sadaoikebe/ts52k/README.md

# TS52K — 無線版

親指シフト（NICOLA配列）を前提に設計した、52キーの自作キーボードです。このブランチは、MDBT50Q-1MV2 と ZMK で動かす無線版です。ケースとプレートは RP2040 版と共通です。

解説記事: [親指シフトキーボードを作った話](https://qiita.com/sadaoikebe/items/e3715383058286457a23)

## 特徴

- **親指シフト専用設計** — かな入力だけでなく、英数レイヤーも親指シフトで打てる配列
- **52キー + ロータリーエンコーダ** — 50%サイズに親指キーを確保したレイアウト
- **ZMK** — 有線のときは USB HID、ケーブルを抜くと BLE
- **MDBT50Q-1MV2** — Raytac の nRF52840 モジュール。チップアンテナ付き。技適あり
- **USB-C が一つ** — 有線キーボード、充電、あとからの UF2
- **保護付きの LiPo** — 過放電保護はセル側。基板側コネクタはJST PH横挿しSMT、電池製品は後で選ぶ
- **JLCPCB で発注できる基板** — モジュールは在庫 0 なので、事前発注してから PCBA
- **FDM 3Dプリンタで出力できるケース** — 特殊な設備なしで製作可能

---

## このブランチ

回路図は無線版へ更新しました。既存の配置を引き継いだ親シートと、MDBT50Q・電源容量・LF水晶の子シートの2枚です。[回路図PDF](pcb/schematic-review/ts52k-wireless.pdf)と[配置元・確認記録](notes/wireless-schematic-layout.md)を参照してください。PCBは2026-11-10にU5を西端へ移し、GPIO割当てと西側の配置・配線を更新しました。[配置画像・記録](pcb/placement-review/README.md)を参照してください。取り込み判断・実機検証・無線版の製造データ作成は未了です。

現行の決定は[無線版の決定事項](notes/wireless-decisions.md)に集約しています。BOMは20品種・82点で（2026-11-11に電池の逆接続保護Q1を追加）、回路図から参照番号付きで照合済みです。ERCはエラー・警告とも0件。電池・ケース、SWD機材の購入判断は後日です。

使用しているKiCad MCPとローカル開発環境は[KiCad開発環境の記録](pcb/DEVELOPMENT.md)を参照してください。

## リポジトリ構成

```
pcb/     KiCad 10 プロジェクト。回路図・PCBは無線版、U5西端移設後
         子シート pcb/mdbt50q.kicad_sch
         schematic-review/ — PDF、画像、ERC、参照番号付きBOMと検査結果
         placement-review/ — PCB配置・配線画像と各時点の照合結果
         PLACEMENT.md — RP2040 版の基板レイアウトガイド
case/    FreeCAD ソース、3Dプリント用 3MF、プレート加工用 DXF
```

`pcb/` は無線版で使うシンボルとフットプリントを同梱しています。回路図とPCBの旧部品・旧ライブラリ参照は除去済みです。

| ライブラリ | 内容 |
| :--- | :--- |
| `MX_Only.pretty` | Cherry MX キースイッチのフットプリント（1U〜3U、7種） |
| `ts52k.kicad_sym` / `.pretty` | 無線版の選定済み20品種とMXシンボル。採用ランド15種を同梱 |
| `tag-connect.kicad_sym` | Tag-Connect TC2030のSWDシンボル。既定ランドは`ts52k.pretty`に同梱 |

選定済み部品の登録、回路図への反映とPCBへの取り込みは完了しています。[ライブラリの出典・変更・削除内容](pcb/LIBRARIES.md)と[部品ごとのシンボル／ランド対応表](pcb/wireless-library.csv)を参照してください。全配線を接続した後の設計レビュー・実機検証は残っています。

---

## 回路の構成

```
USB-C (J1) ─┬─ VBUS ─┬─→ BQ24072 IN（1 µF）
            │        └─ 2.2 Ω ─→ モジュール VBUS（パッド 32、4.7 µF）
            └─ D−/D+ ──→ モジュール パッド 34 / 35
                         ESD は H5VU10U。データ線に直列抵抗は置かない

BQ24072 OUT（4.7 µF）──→ モジュール VDDH（パッド 30）
BQ24072 BAT（4.7 µF）──→ JST PH 2極（1=BAT+、2=GND）──→ 保護付きセル

モジュール VDD（パッド 28）──→ J2 の 1 番。電圧は REGOUT0 = 3.3 V
モジュール ── 16本 ──→ キーマトリクス（6列×10行）
          ── 2本   ──→ エンコーダの回転（A=P1.11、B=P1.13）
          ── SWD ──→ J2 の 2 番 SWDIO（パッド 51）、4 番 SWCLK（パッド 53）
SW1 ──→ P0.18（nRESET）を GND へ。電源を切らずに 500 ms 以内の 2 回押しで UF2
```

モジュールは MDBT50Q-1MV2 です。P1MV2 との差はアンテナだけで、技適は両方にあります。外形は 10.5 × 15.5 × 2.05 mm、供給は 1.7〜5.5 V です。アンテナは削ったり、足したりしません。32 MHz と無線側のインダクタはモジュールの中にあります。GPIO は 48 本が 61 パッドに出ています。

### USB

J1 は HRO TYPE-C-31-M-12 のままです。CC1 / CC2 は 5.1 kΩ で GND、シールドは GND、D− / D+ / VBUS の ESD は H5VU10U です。D+ / D− の直列抵抗は、nRF の USB PHY に入っているので置きません。

PC に挿すと、ZMK は既定で USB HID に出します。ケーブルを抜くと最後の BLE プロファイルに戻ります。切り替えは `&out` で、選択は残ります。充電器のように HID を受け取らない相手では `OUT_BLE` にします。キーマップだけの変更は ZMK Studio が USB でも BLE でもできます。

VBUS（パッド 32）は、モジュールの USB 用 3.3 V レギュレータへの 5 V 入力です。充電 IC の出力はここへ入れません。

モジュールVBUS枝には、Nordic推奨・Raytac参考回路の2.2 Ωを入れます。C22939（0603・Basic）を1個、4.7 µFは抵抗の後、VBUSのESDは手前です。BQ24072 INは抵抗の手前から分岐します。[選定根拠と接続](notes/wireless-power-input.md)を参照してください。

### 電源

セルの電圧を VDDH（パッド 30）へ入れ、モジュール内のレギュレータでコアを作ります。ZMK の nice!nano v2 は `zmk,battery-nrf-vddh` で、このピンを読みます。外の 3.3 V で VDD と VDDH を短絡する結線にはしません。この基板には灯が無く、他の基板へ 3.3 V を出すピンもありません。

GPIO の High は REGOUT0 です。nice!nano のブートローダに合わせて 3.3 V にします。UICR の生の数値は、ブートローダのソースからは写していません。未設定のままでは VDD が 1.8 V になります。

検証済みのZMK main最小構成に合わせ、REG0（高電圧側）・REG1（無線側）のDC/DCを両方オンにします。REG1のインダクタは内蔵、REG0用にはDCCH（31）–VDD（28）へ10 µHのLQM18DN100M70L / C713281を外付けします。P0.13のVCCスイッチは置かず、この端子はrow3に使います。VDDHに10 µF、VDDには4.7 µF＋1 µF＋100 nF×3を置きます。[現行BOMと根拠](notes/wireless-bom-candidates.md)を参照してください。

LFクロックは外付け32.768 kHz水晶、XTAL/50 ppm設定です。FC-12M / X1A0000610008（CL=9 pF）をXL1（17）–XL2（18）へ接続し、各端子からGNDへ12 pFを1個ずつ置きます。

### 充電

充電 IC は BQ24072 です。パッケージは VQFN-16（RGT、3.00 mm × 3.00 mm）、リール品の記号は BQ24072RGTR です。T 付きの BQ24072T は使いません。TS の見方が違い、10 kΩ 固定では充電しません。

nice!nano v2の公開回路図はBQ24075表記です。量産でBQ24072を使ったという発言は[調査記録](notes/wireless-bom-candidates.md)に出典と限界を残しています。今回の72の選定は、公開図と型番が同一という理由ではなく、VDDHへ供給するOUTの電圧条件に基づきます。SLUS810Nでは72のOUTはVBAT + 225 mV（VBATが3.2 V以上のとき+150 / +225 / +270 mV。3.2 V未満で入力があるときは3.3 / 3.4 / 3.5 V）です。4.2 Vのセルなら上側は約4.47 Vです。75のOUTは5.4 / 5.5 / 5.6 Vで、最大はモジュールの供給範囲1.7〜5.5 Vの上に出ます。

ピンは SLUS810N のピン図です。

| ピン | つなぎ |
| :--- | :--- |
| IN（13） | USB 5 V。1 µF。過電圧保護は typ 6.6 V（6.4〜6.8 V）。バイパスの範囲は 1〜10 µF |
| BAT（2、3） | 保護付きセルのプラス。充電電圧は 4.2 V。4.7 µF |
| OUT（10、11） | モジュール VDDH（パッド 30）。4.7 µF。範囲は 4.7〜47 µF。入力が無いときは BAT とつながる |
| EN1（6）、EN2（5） | 両方 GND。USB100 で入力上限は 100 mA（90 / 95 / 100 mA） |
| ISET（16） | 8.2 kΩ / C25981をGNDへ。Basic優先で選定。KISET = 890 AΩで約108.5 mAの設定だが、実際の充電電流はUSB100の入力制限とシステム負荷にも制限される |
| ILIM（12） | 1.5 kΩ を GND へ。データシートの試験条件。USB100 の電流を決めるのは EN の側。開放にはしない |
| TS（1） | 10 kΩ を GND へ。パックの NTC は引かない |
| TD（15） | GND。充電終止を有効にする。開放にはしない |
| CE（4） | GND。High で充電が止まり、OUT は生きたまま |
| TMR（14） | 開放。タイマは既定値 |
| CHG（9）、PGOOD（7） | 灯が無いので未接続 |
| VSS（8）とサーマルパッド | 両方 GND。パッドだけを GND にしない |

セルの容量はまだ決まっていないので、500 mA（EN1 = High、EN2 = Low）にはしません。nice!nano の公称も 100 mA です。BQ24072 に過放電保護は無く、短絡保護はあります。基板に保護 IC は足しません。セルを切り離す SYSOFF は 75 と 79 のピンで、72 にはありません。ロードスイッチは足しません。

コネクタはJST S2B-PH-SM4-TB(LF)(SN) / C295747で、基板側は1=BAT+、2=GNDに統一します。コネクタの1番とBQ24072のBATの間には、逆接続保護のPチャネルMOSFET（Q1、AO3401A / C15127）が直列に入っています。逆向きの電池をつないでもQ1がオフのままで、充電ICとモジュールに負電圧がかかりません。極性の確認が不要になるわけではありません（[手順書](notes/brick-avoidance.md)）。電池の容量・外形・製品は後で選び、ケーブルの実際の極性を基板に合わせます。PHシリーズ共通の極性規約を意味しません。

### キーの配線

52個のキーは、1個ずつマイコンのピンには繋ぎません。6列×10行のマトリクスです。列を1本ずつ順に駆動し、10本の行の電圧を見て、どのキーが押されているかを判断します。キーごとにダイオードが1本あり、向きはカソードが行側です。

エンコーダの押し込みスイッチも、このマトリクスの6列目に入っています。キー52と押し込み1つで、接点は53です。エンコーダの回転（A相とB相）はマトリクスの外で、専用のピンが2本です。

列と行でマイコンのピンは16本、回転と合わせて18本です。2026-11-10のU5西端移設に合わせ、上段バスの入力6本を北側パッド4・6・8・10・12・14、下段の行6本を南側パッド37・41・43・44・46・48へ割り当てました。列6本は制限なしのパッド16・20・22・24・26・49を使い、ZMKで高駆動を明示します。ダイオードは反転しません。[現在のGPIO表](notes/wireless-pin-assignment.md)は回路図・PCBへ反映済みで、ファームウェア側への反映は[ZMK同期チェックリスト](notes/zmk-pin-sync-checklist.md)に従って行います。

### 書き込み

通常のRaytacモジュールはAdafruit UF2ブートローダーなしを想定し、初回はJ2のSWDから書き込みます。検証対象はAdafruit 0.11.0のnice_nano用SoftDevice結合HEXです。秋月の書き込み済みモジュールも調達対案ですが、搭載版と電源初期化条件の照合が必要です。SWDランドはどちらでも必須、機材と購入先の決定は後日とします。[調査記録](notes/swd-equipment.md)を参照してください。

J2 は Tag-Connect TC2030 のランドだけです。部品は実装しません。初回書き込み・復旧の手順と、基板を壊さないための注意（電池の極性、3.3 V固定の書き込み器を使わない等）は[文鎮化回避の運用ルールと手順](notes/brick-avoidance.md)にまとめています。

| ピン | つなぎ |
| :--- | :--- |
| 1 | モジュール VDD（パッド 28） |
| 2 | SWDIO（パッド 51） |
| 3 | P0.18（nRESET）。SW1 と同じネット |
| 4 | SWCLK（パッド 53） |
| 5 | GND |
| 6 | SWO。未接続 |

SW1 は TS-1187A-B-A-B のまま、P0.18 を GND に落とすリセットにします。BOOTSEL 用の直列 1 kΩ は残しません。nRESET のプルアップは内蔵です。

---

## ロータリーエンコーダ

SW2 は型番未確定の EC11 互換です。押し込みは `col6` に入っています。A/B の 10 kΩ と 100 nF は外します。nRF52840 の内蔵プルアップは 11〜16 kΩ（別の回答は 13 kΩ）で、RP2040 の 50〜80 kΩ を前提にした回路は移しません。

---

## 部品リスト

回路図の実装対象BOMは**20品種・82点**です。[参照番号付きBOM](pcb/schematic-review/bom.csv)を回路図から生成し、[選定済みBOM](notes/wireless-bom-draft.csv)と一致することを確認しました。選定根拠は[先行例との対応](notes/wireless-bom-candidates.md)、実装条件は[ランド・配置の照合](notes/wireless-layout-check.md)にまとめています。実装座標はPCB移行後です。

### 残すもの、足すもの

| 部品 | 型番 / 値 | 数量 | パッケージ |
| :--- | :--- | ---: | :--- |
| モジュール | MDBT50Q-1MV2 / C5118826 | 1 | 10.5×15.5×2.05 mm |
| 充電 IC | BQ24072RGTR / C140288 | 1 | VQFN-16 3×3 mm |
| REG0 インダクタ | LQM18DN100M70L / C713281、10 µH | 1 | 0603 |
| LF 水晶 | X1A0000610008 / C96341、32.768 kHz | 1 | FC-12M、2012 |
| LF 負荷容量 | 12 pF / C1547 | 2 | 0402 |
| USB-C | HRO TYPE-C-31-M-12 / C165948 | 1 | SMD端子・スルーホール固定脚 |
| USB ESD | H5VU10U / C22395519 | 3 | DFN1006-2L |
| リセット | TS-1187A-B-A-B / C318884 | 1 | 上押し 5.1×5.1×1.5 mm |
| ダイオード | 1N4148W / C81598 | 53 | SOD-123 |
| CC 抵抗 | 5.1 kΩ / C23186 | 2 | 0603 |
| VBUS 直列抵抗 | 2.2 Ω / C22939（Basic） | 1 | 0603 |
| ISET | 8.2 kΩ / C25981 | 1 | 0603 |
| ILIM | 1.5 kΩ / C22843 | 1 | 0603 |
| TS | 10 kΩ / C25804 | 1 | 0603 |
| IN、VDD のコンデンサ | 1 µF / C15849 | 2 | 0603 |
| OUT、BAT、VBUS、VDD のコンデンサ | 4.7 µF / C19666 | 4 | 0603 |
| VDD のバイパス容量 | 100 nF / C14663 | 3 | 0603 |
| VDDH のコンデンサ | 10 µF / C15850 | 1 | 0805 |
| 電池コネクタ | S2B-PH-SM4-TB(LF)(SN) / C295747 | 1 | PH横挿しSMT、2極 |

Tag-ConnectのJ2はランドだけです。電源コンデンサの構成と選定根拠は[選定記録](notes/capacitor-selection.md)を使います。

### 手付け・機構部品

| 部品 | ソース | 数量 | 備考 |
| :--- | :--- | ---: | :--- |
| キースイッチ | AliEx / 淘宝 / 自キ専門店 | 52 | お好みの打鍵感で。Kailh Box 白軸がおすすめ |
| ロータリーエンコーダ | — | 1 | Alps EC11E 互換、押し込みスイッチ付き。型番未定 |
| 2u スタビライザー | AliEx / 淘宝 / 自キ専門店 | 3 | PCBマウント |
| 3u スタビライザー | AliEx / 淘宝 / 自キ専門店 | 1 | PCBマウント |
| キーキャップ | AliEx / 淘宝 / 自キ専門店 | 1セット | **3u と 2.75u の親指キーが必要** |
| ケース ふた | [3Dプリント](case/) | 1 | FDM で出力可能 |
| ケース 底板 | [3Dプリント](case/) | 1 | FDM で出力可能 |
| 定位板（プレート） | [レーザーカット](case/) | 1 | t=1.5 mm 真鍮 |
| セル | — | 1 | 保護付き LiPo。容量と外形はケースのとき |
| ヒートセットインサート | [AliExpress](https://www.aliexpress.com/item/1005002288716120.html) | 8 | M3 × 6 mm × 4.6 mm。長さは 6 mm でなくても可 |
| M3 円頭六角ボルト | — | 8 | 6 mm |
| クッション | — | 12 | Poron / EVA フォーム、2 mm 厚 × 2 mm × 87 mm |
| ゴム足 | — | 4〜 | — |

キースイッチの内訳: 1U ×39、1.25U ×5、1.5U ×2、1.75U ×2、2.25U ×2、2.75U ×1、3U ×1

### まだ決めていない

- **実際の部品配置** — U5を基板西端に移設し、モジュールの全層アンテナ禁止領域と、基板端に沿って拡張した `ANT_EDGE` を設定済みです。[配置記録](pcb/placement-review/README.md)を参照してください。実機の通信距離は未確認です。
- **SWD機材・モジュールの購入先** — 調査記録を残し、決定は後日。
- **電池製品** — 容量と外形は後で選びます。今回ケースの設計は行いません。
- **エンコーダ SW2** — 型番。RP2040 版から未定のままです。

---

## 回路図に反映した変更

### 維持したもの

- キー、1N4148W が 53 個、6列×10行。回路図のネット名は `col1`〜`col6`、`row1`〜`row10`。ダイオードのカソードは行側。エンコーダの押し込みは6列目。エンコーダ本体 SW2。
- J1。R5 と R6（5.1 kΩ）。シールドは GND。D89、D90、D91（H5VU10U）。
- J2 のランド。上のピン表。
- SW1 の部品。つなぎ先は P0.18。

### 除去したもの

旧RP2040子シートごと除去しました。

- U5 RP2040
- X2。12 MHz の OC2EL89CJO-113YLC-12M
- R3、R4。RUN と発振器 EN の 10 kΩ
- R7、R8。USB の直列 22 Ω
- R9〜R13。QSPI の直列 22 Ω
- C6〜C10、C12〜C18、C21。1 µF

親シートから除去しました。

- U4 W25Q128。R2（CS の 10 kΩ）
- R14（1 kΩ）。SW1 には残しません
- U3 TPS7A2433。C3（4.7 µF、0603）、C5（4.7 µF、0402）
- C2、C4。その 3.3 V の 1 µF
- R15、R16（エンコーダの 10 kΩ）、C19、C20（100 nF）

### 追加したもの

- MDBT50Q-1MV2 と GND。6列×10行の16本と、エンコーダの回転2本は[GPIO接続表](notes/wireless-pin-assignment.md)の割当てを使う
- VDD（パッド28）–GNDに4.7 µF＋1 µF＋100 nF×3。[電源コンデンサの現行選定](notes/capacitor-selection.md)を使う
- DCCH（31）–VDD（28）へ10 µH、VDDH（30）–GNDへ10 µF
- XL1（17）–XL2（18）へFC-12M、各端子からGNDへ12 pFを1個ずつ
- BQ24072 と、上のピン表の抵抗・コンデンサ
- OUTをVDDH（30）へ。USB 5 Vは別枝の2.2 Ωを介してVBUS（32）へ、4.7 µFは抵抗の後
- D− をパッド 34、D+ をパッド 35 へ
- 電池コネクタS2B-PH-SM4-TB(LF)(SN)。1=BAT+、2=GND
- アンテナの全層禁止領域と局所的な実装面禁止領域を登録ランドへ含めた。PCBでの拡張・配置は[寸法と配置条件](notes/wireless-layout-check.md)に従う

### 採用しないもの

- NFC
- 外の 3.3 V で VDD と VDDH を短絡する結線
- P0.13 のロードスイッチ
- LED、USBデータ線の直列抵抗、エンコーダのRC
- ドングル用ブートローダの P0.15 と P0.10
- 基板上の電池保護IC、電池プラス側のスイッチ、DW01AとFS8205。電池保護はパック側

---

## 配置と製造

モジュールは B.Cu、真鍮の定位板 t=1.5 mm は F 面、電波は樹脂の底板側へ抜けます。承認書 2.3 は、アンテナの位置を全層で GND 無し、できるだけ広く、端の方が中央より良い、と書いています。エンコーダの金属筐体はアンテナの近くに置きません。モジュールの高さは 2.05 mm です。

MDBT50Q-1MV2 の JLCPCB 部品番号は C5118826 です。2026-10-31 の表示は在庫 0、Standard Only、X-ray 必須でした。在庫が無くても Parts Manager で事前発注し、私有庫に入ってから PCBA に出します。生基板の最少は 5 枚です。Standard はエッジレールが要り、レール幅のヘルプは最小 5 mm です。レールは製品の外形に残しません。自宅リフローは、事前発注が通らないときの予備です。

Fanstel BC840 は使いません。同じ机の上でも、MDBT50Q より距離の余裕が小さく、縁ゼロのアンテナ条件は残ります。

---

## ファームウェア

無線版はZMKです。開発は別リポジトリ`C:\Users\marur\zmk-config`で行い、本リポジトリはハードウェアを扱います。ZMK main `4dd95d7840eb3d5a3f59bb29fbf1ab054715ef85` / Zephyr 4.1.0で、TS52Kの1×1最小定義をビルド済みです。VDDH給電、REG0/REG1 DC/DCともオン、外付けLF水晶XTAL/50 ppm、USB/BLE、P0.18リセット。P0.13の`EXT_POWER`は使いません。GPIO18本の全マトリクスと親指シフトの実装は今後のファームウェア開発で行います。

ビルド成功は実機の起動確認ではありません。初回SWD、USBブートローダー、最小ZMK、BLEの順に試作基板で確認します。[起動条件の調査記録](notes/zmk-hardware-bringup.md)を参照してください。

有線版の QMK は別リポジトリです。公開済みの `ts52k` 定義は ATmega32U4 用です。

https://github.com/sadaoikebe/qmk_firmware/tree/master/keyboards/ts52k

---

## 組み立て手順

ケース、プレート、キースイッチの手順はRP2040版と同じです。電池の入れ方は電池製品を選んだ後で書きます。SW1はBOOTSELではなくリセットです。ケースの穴は、このボタンを押すためのものです。

### 1. 部品の確認

部品リストの通り揃っているか確認します。

### 2. スタビライザーの取り付け

**ここが一番の要注意ポイントです。** ちゃんと嵌っていないと、後の工程で気づいたときに大幅な手戻りになります。基板にスタビライザーを取り付けたら、爪がしっかりロックされているか1つずつ確認してください。

### 3. ロータリーエンコーダの取り付け

### 4. プレートとキースイッチの取り付け

プレートを貫通させて、**まず四隅のキースイッチから固定**します。四隅が決まるとプレートと基板の位置が安定するので、残りが入れやすくなります。

### 5. Poron フォームの貼り付け

### 6. ケースへのヒートセットインサート挿入

半田ごてで温めながら、**まっすぐ**押し込みます。斜めに入ると取り返しがつかないので、少しずつ確認しながら進めてください。

### 7. ケースの組み立て

---

## 開発環境

- **KiCad 10.0** 以降

無線版回路図のERCはエラー0・警告0です。[検査スクリプト](pcb/check_schematic.py)で電源・信号・BOM・旧マトリクスとの一致を確認し、[結果](pcb/schematic-review/validation.json)を保存しました。ライブラリ検査は[別記録](pcb/LIBRARIES.md)です。PCBは旧版なので、無線版DRC・schematic parityの検査はこれからです。RP2040版の0件という過去結果を現在のPCB整合の結果として使いません。

**`Tools → Update PCB from Schematic` では `Link footprints using reference designators` をオフのままにしてください。** フットプリントは Unique ID で回路図と紐付いています。

基板を編集する場合は、[`pcb/PLACEMENT.md`](pcb/PLACEMENT.md) の「やってはいけないこと」を先に読んでください。`PLACEMENT.md` が説明しているのは RP2040 版の配置です。編集後はベタを再充填し、DRC と製造データを作り直します。

```sh
kicad-cli sch erc                                   -o erc.rpt ts52k.kicad_sch
kicad-cli pcb drc --schematic-parity --refill-zones -o drc.rpt ts52k.kicad_pcb
```

---

## ライセンス

[Creative Commons Attribution-NonCommercial 4.0 International (CC BY-NC 4.0)](LICENSE.md)

複製・改変・再配布が可能です。ただし以下の条件が付きます。

- **表示（Attribution）** — 作者のクレジット表示、ライセンスへのリンク、変更の有無の明示が必要です
- **非営利（NonCommercial）** — 商用目的での利用はできません
