sadaoikebe/ts52k/pcb/jlcpcb/README.md

# JLCPCB 向け出力 — 無線版

**同梱の製造出力は、2026-11-13にJ2（SWD接点）を最下段のMX5とMX9の間 (19.05, 115.0) へ再移設した基板から再生成したもの。BOM 21行・LCSC 20種類・82実装点、実装面はすべてBottom。** J2は部品を実装しないので、変わったのはガーバーだけ。BOM・CPLは2026-11-11の回転監査時（wireless `6e3c3ec`）と同じ。[移設の記録](../placement-review/README.md)Q1の既存+180°補正を維持し、今回追加する角度補正はない。

監査の[全BOM行の判定・根拠・角度一覧](../../notes/rotation-audit-2026-11-11/report.md)と[取得データ・照合手順](../../notes/rotation-audit-2026-11-11/README.md)を参照。最終再生成のDRCはシルク警告9件のみ、未接続0・回路図パリティ0、ERCはエラー・警告とも0。

## 無線版：発注画面の配置プレビューで向きを確かめる部品（2026-11-11）

JLCPCB公開ページのビューアが使う **JLCEDA/EasyEDA公式ライブラリの番号付きランド図**を全20種類取得し、KiCadのランド形状・寸法・ピン番号と比較した。基板上の全82点についても反転・配置回転を戻して確認した。判定は、補正あり1点（Q1）、補正不要（確認済み）61点、180°反転が電気的に無意味な2端子部品20点。ライブラリの回転定義について未確認の部品は残っていない。

`export.py` の `ROTATION_CORRECTIONS` は **C15127: +180°のみ**。補正はKiCadの生角度に一度だけ加える。Q1は生角度0°→CPL 180°で、今回の監査前後のCPL角度は同じ180°。他の部品は生角度を維持する。

公開ライブラリの照合を済ませても、**発注画面の配置プレビューは最終目視として必要**。ピン1・極性・全ランドの重なりを確認する。下表は基板を表面側から透かして見た向き（東=+x、南=+y、座標mm）。Bottomを直接見る表示では左右が反転する。CPLのYはKiCad基板座標の符号を反転している。

| 部品 / LCSC | 中心 (x, y) mm | 監査判定 / 最終CPL角度 | プレビューで確認する実際の位置 |
| --- | --- | --- | --- |
| U5 MDBT50Q-1MV2 / C5118826 | (4.45, 63.4) | 補正不要（確認済み） / −90° | 1番は西へ3.75、北へ4.65。アンテナが基板左端。61端子すべての位置も確認 |
| U6 BQ24072 / C140288 | (16.5, 51.2) | 補正不要（確認済み） / 90° | 1番は東へ0.75、南へ1.4625。中央17番を含む全端子がランドに重なること |
| D91 VBUS ESD / C22395519 | (25.9588, 49.9816) | 補正不要（確認済み） / −135° | 1番=Kは東へ約0.3005、北へ約0.3005（VBUS）。2番=AはGND |
| D89・D90 USB ESD / C22395519 | (21.225, 51.8) / (23.075, 51.8) | 補正不要（確認済み） / 180°・0° | 1番=KはD89が東へ0.425、D90が西へ0.425。信号側がK、GND側がA |
| Q1 AO3401A / C15127 | (24.97, 68.73) | **既存+180°補正を維持** / 180° | 1本の辺（3=D）が東、2本の辺が西。南西1=G/GND、北西2=S/BAT。補正の二重適用がないこと |
| J3 電池コネクタ / C295747 | (30.6, 65.0) | 補正不要（確認済み） / −90° | 1番=BAT+は西へ2.85、北へ1.0、シルク「+」側。差し込み口は東。信号端子・固定金具が重なること |
| J1 USB-C / C165948 | (23.820919, 43.588617) | 補正不要（確認済み） / 0° | 差し込み口が基板上辺。A1/B12は西、A12/B1は東。12か所の信号ランドと4本のシールド脚を確認 |
| SW1 リセット / C318884 | (27.5, 74.6) | 補正不要（確認済み） / 0° | 南側の左右がGND（KiCad 1=EasyEDA 1・2）、北側の左右がRESET（KiCad 2=EasyEDA 3・4）。180°は同等、90°はランドに合わない |
| D2〜D88のBOM記載53点 / C81598 | 全位置はCPL参照 | 補正不要（確認済み） / 各90°または−90° | 1=Kの帯が90°配置では南、−90°配置では北。全53点の帯とランドを確認。D2からD88の連番すべてではなく、BOMに列挙された53点を対象とする |
| C22〜C33・R5/R6/R17〜R20・L1・X3 | 全位置はCPL参照 | 回転無意味（0°と180°が電気的に等価） / 生角度を維持 | 合計20点。90°回転は許容しない。2端子の長軸とランドが重なること |

SW1の接点対応はメーカー図のA–B / C–Dの導通と、EasyEDAの1–2 / 3–4の同じ行の配置で確認済み。

**回転とは別の確認事項：** U5のEasyEDA原点はKiCad原点と約1.700 mm（フットプリントのy方向）異なる。J1にも約1.4〜1.6 mmのy方向差がある。番号とランド配列の向きは一致しており、フットプリント不適合と断定する差ではない。JLCPCBが部品中心をどう扱うかは公開SVGだけでは確定しないため、XY補正は加えず、プレビューで部品全体の平行ずれも最終確認する。

## 以下は旧RP2040版 Revision 0.2 の記録

以下の電源構成、部品数、配置、DRC件数、RP2040の製造実例は旧版の履歴であり、現在の無線版の発注値ではない。現行の部品数・回転監査・確認対象は上記を使う。[無線版の決定事項](../../notes/wireless-decisions.md)と[回路BOM](../schematic-review/bom.csv)も参照。

## 電源・USB ESD保護

- U3 は **TPS7A2433DBVR / C2866134**。SOT-23-5 の 1=+5V、2=GND、3=+5V（EN と IN を直結）、4=GND（NC端子を放熱用に接続）、5=+3V3。[TI データシート](https://www.ti.com/lit/gpn/TPS7A24)
- C3 は **CL10A475KA8NQNC / C69335、4.7 µF、25 V、0603**。入力側の C4 は1 µFのまま、位置を調整。U3出力側のC5は従来の **CL05A475MP5NRNC / C23733、4.7 µF、10 V、0402** のままです。メーカーの典型DCバイアスデータでは、C3は5 Vで約2.43 µF、C5は3.3 Vで約2.43 µFです。これは典型値であり、温度・個体差を含む保証値ではありません。[C3](https://product.samsungsem.com/mlcc/CL10A475KA8NQN.do) / [C5](https://product.samsungsem.com/mlcc/CL05A475MP5NRN.do)
- D−のD89、D+のD90、VBUSのD91に **H5VU10U / C22395519** を使用しています。各素子の1番は保護する線、2番はGNDです。[JLCPCB 部品情報](https://jlcpcb.com/partdetail/C22395519)
- 3個ともKiCad標準の `Diode_SMD:D_SOD-882D` を使用し、Bottomに実装します。現在の位置と向きは基板データと実装座標を参照してください。
- J1はKiCad標準の `Connector_USB:USB_C_Receptacle_HRO_TYPE-C-31-M-12`、C13は `Capacitor_SMD:C_0402_1005Metric`、J2は `Connector:Tag-Connect_TC2030-IDC-NL_2x03_P1.27mm_Vertical` です。J1のシールド端子 `SH` はGNDに接続しています。J2は標準のベタ銅箔とビアの禁止領域を含みます。
- C3・C4はU3入力とGNDの間、C5・C21は3.3V出力とGNDの間に接続しています。U3の2番・4番はGNDに接続しています。回路・ESD波形の実測は未実施です。
- USB付近の配線と保護素子の位置は基板データを参照してください。USB信号品質は未測定です。

## 基板と検査

- 銅箔と基板外周の設計ルールを **0.25 mm** にし、表裏の GND ゾーンを再充填して基板に保存しました。JLCPCB の通常のルーター外形では銅箔まで 0.2 mm 以上が必要です。[JLCPCB 基板製造能力](https://jlcpcb.com/capabilities/pcb-capabilities)
- BOOTSEL の SW1 は、上押し式 **XKB TS-1187A-B-A-B / C318884** に変更。JLCPCB の掲載上は Basic です。高さは基板から約 1.5 mm、実装面は Bottom。裏面側から押します。[部品情報](https://jlcpcb.com/partdetail/C318884) / [メーカー図面](https://www.helloxkb.com/uploads/qingchukaiguan/TS-1187A-X-X-X.pdf)
- SW1 は裏面の (47.6, 76.2) mm、90°に配置しています。メーカー図面の推奨ランドと A–B／C–D の接点構成に合わせています。ケースは既存版と共通です。底板を取り付けた状態での BOOTSEL の押下方法は組み立て時に確認してください。
- KiCad 10.0.5 のDRCは **エラー0、未接続0、回路図との不一致0、フットプリント差異0、警告25件**。残る警告はシルク関連で、ERCはエラー・警告とも0件です。プロジェクト設定で無効なチェックもあるため、これだけで機構干渉や実装品質を保証するものではありません。
- USB の R7/R8 は **22Ω・C25092** のままです。同じ Basic 部品を QSPI 側 R9–R13 と共通化し、部品種と PCBA の段取り費を抑える設計判断です。Raspberry Pi の[設計資料](https://datasheets.raspberrypi.com/rp2040/hardware-design-with-rp2040.pdf)で指定される 27Ω とは異なり、USB 波形の測定・シミュレーションは行っていません。

## データの再生成

KiCad 10 と Python 3 を用意し、KiCad 上の変更を保存したうえで、リポジトリ直下から実行します。

```powershell
python pcb/jlcpcb/export.py
```

`kicad-cli` が PATH にない場合、Windows の標準 KiCad 10 インストール先を探します。それ以外では `--kicad-cli` に実行ファイルのパスを渡します。

スクリプトは現在の回路図・基板から DRC / ERC、ガーバー、PTH・NPTH ドリル、BOM、実装座標を作成します。外周クリアランスが 0.2 mm 未満の場合、DRC エラー・未接続・回路図との不一致・ERC エラーがある場合、部品番号や実装座標が欠けている場合は停止します。作成時のソースと出力の SHA-256 は `assembly/manifest.json` に記録します。ガーバーZIP、BOM、実装座標、manifestはGitに保存し、基板編集後は再生成してください。その他の生成物は `.gitignore` の対象です。

次の表は現在の基板から生成した出力先です。

| JLCPCB に渡すもの | ファイル |
| :--- | :--- |
| ガーバーとドリル | `gerber/ts52k-gerbers.zip` |
| PCBA 部品表 | `assembly/ts52k-bom.csv` |
| PCBA 配置座標 | `assembly/ts52k-cpl.csv` |

正常終了したら `assembly/export-status.txt` が `EXPORT COMPLETED` になります。失敗時には以前の出力が残ることがあるため、利用しないでください。基板・回路図・設定を変更したら再生成します。

実装面は **Bottom のみ、96 点 / 部品番号16種、BOM 16行**です。C13は同じ標準フットプリントと部品番号を使うコンデンサと同じ行です。USB コネクタ J1 と BOOTSEL の SW1 は JLCPCB に実装してもらいます。キースイッチ 52 個とロータリーエンコーダ SW2 は手付け、Tag-Connect J2 は接点と穴だけで部品実装なしです。J1は固定脚にPTHがあるため、スクリプトはSMDのみに限定せず座標を出力し、J1を含むBOMと配置座標の参照番号を照合します。

## RP2040 のパッドと JLCPCB の製造実例

**結論：この基板の RP2040 のパッドと中央パッド内ビアは、JLCPCB の2層・1 ozで製造・実装できる設計と判断しています。パッド幅や中央パッド内ビアを理由にガーバー出力を止める必要はありません。**

この基板の U5（RP2040）は、端子パッドの幅が **0.20 mm** です。中央の GND パッドには、ペースト開口と重なる **穴径 0.30 mm の貫通ビアが4個**あります。

参考となる実例として、[RP2040 Advanced Breakout Board の発注手順](https://github.com/OpenStickCommunity/Hardware/blob/main/Boards/GP2040-CE%20Official%20Boards/RP2040%20Advanced%20Breakout%20Board/RP2040%20Advanced%20Breakout%20Boa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)では、JLCPCB に発注した基板について、2層・1.6 mm厚・1 oz・Tented ビアが指定されています。[公開 BOM・実装座標・ガーバー](https://github.com/OpenStickCommunity/Hardware/tree/main/Boards/GP2040-CE%20Official%20Boards/RP2040%20Advanced%20Breakout%20Board/RP2040%20Advanced%20Breakout%20Boa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)を確認すると、RP2040 は C2040、端子パッド幅は 0.20 mm、中央パッド内にはペースト開口と重なる穴径 0.305 mm のビアが9個あります。

この実例は、同様のパッド幅と中央パッド内ビアを持つ基板が JLCPCB に発注されている根拠です。中央パッド内ビアの実装については、[JLCPCB のビア・イン・パッド資料](https://jlcpcb.com/help/article/via-in-pad-pofv-guide)も参照できます。

## 発注画面で確認すること

1. 2 層、板厚 1.6 mm、銅厚 **1 oz** を選ぶ。基板外形は約 307.23 × 80.41 mm。最小配線幅 0.15 mm は JLCPCB の 2 層 1 oz の公表能力内ですが、2 oz の公表最小値 0.16 mm は満たしません。
2. BOM をアップロードし、各部品の実装在庫と見積額を確認する。
3. 現在の無線版を発注する場合は、本書冒頭の「無線版：発注画面の配置プレビューで向きを確かめる部品」の表を使う。Q1のみ+180°補正済み。公開ライブラリの全件照合後も、極性・角度・XY位置をプレビューで最終目視する。
4. U5 のパッドとビアについては、上記の製造実例を参照する。
5. 実機では SW1 の押下方法と Tag-Connect の挿入性、全キー、同時押し、USB の両向き、繰り返し起動を確認する。Revision 0.2 の動作には RP2040 対応ファームウェアが必要です。
