sadaoikebe/ts52k/pcb/placement-review/scripts-2026-11-10/README.md

# 2026-11-10 配線編集スクリプト（記録）

`lib.py` はpcbnew用の小さな編集ヘルパー。`s2`→`s2b`→`s3`→`s4`→`s5`→`s5b` の順に、
コミット `5ea75d5` の基板へ適用した編集の記録である。各スクリプトは適用前の座標を前提にしており、
現在の基板へ再実行するものではない。`lib.py` の `PCB` は作業時の絶対パスを指す。

このVMのpcbnewでは `BOARD.Remove()` の後にSWIGの型解決が壊れるため、削除は `RemoveNative()` を使っている。
