sadaoikebe/ts52k/notes/wireless-decisions.md

# 無線版の現行決定事項

2026-11-03更新。会話で合意した内容の参照先。旧調査案より本書を優先し、会話で変更が決まった場合は本書と関連するBOM・ライブラリを揃える。

## 作業範囲と現在地

ts52kはハードウェア用。ファームウェアは`C:\Users\marur\zmk-config`等の別リポジトリで扱う。NICOLAの内部実装とQMKのRP2040移植は今回の作業に含めない。ZMKの調査対象は基板の起動に必要な条件に限る。

現在は**無線版回路図の作成・検査が完了し、PCBの仮配置まで実施**。親シートとMDBT50Q子シートの2枚。旧RP2040子シートと不採用の埋め込みシンボルを削除した。回路図の既存配置と追加ブロックの先行例は[配置記録](wireless-schematic-layout.md)を参照。PCBは旧MCU・周辺部品と配線を除去し、無線部品を裏面に仮置きした。新規配線は行っていない。[仮配置記録](../pcb/placement-review/README.md)を参照。旧ライブラリは復活させない。

メーカー参考回路と実績あるキーボードの構成を基準にする。新たな仕様や最適化を先に作り、そのために高価な部品・追加回路・検討工程を増やさない。抵抗・容量は必要条件を満たす安いBasic品を優先する。

## 決定済みの構成

| 項目 | 採用内容 |
| --- | --- |
| MCU | MDBT50Q-1MV2 / C5118826。裏面実装、内蔵アンテナ・32 MHz水晶・REG1インダクタを使用 |
| 給電 | BQ24072 OUT→VDDH(30)。外部3.3 V LDOは使わない |
| REG0 / REG1 | ZMKで両DC/DC有効。REG0はDCCH(31)–VDD(28)にLQM18DN100M70L / C713281、10 µHを外付け |
| VDD外付け容量 | **4.7 µF＋1 µF＋100 nF×3を全て実装**。単体4.7 µFへ簡略化しない |
| その他の電源容量 | VDDH=10 µF、モジュールVBUS=4.7 µF、BQ IN=1 µF、OUT=4.7 µF、BAT=4.7 µF |
| LFクロック | 外付けFC-12M / X1A0000610008 / C96341、CL=9 pF。12 pF / C1547×2、ZMKはXTAL/50 ppm |
| 充電 | **USB100固定**。EN1・EN2・CE・TDはGND。TS=10 kΩ、TMR開放。USB状態連動の充電制御・追加GPIO・記述子変更は初版で実施しない |
| ISET | 8.2 kΩ / C25981。ISET単独設定は約108.5 mAだが、USB100入力制限から本体負荷を差し引くため、実際に109 mA充電へ増やす変更ではない |
| USB | 既存HRO USB-C、CC各5.1 kΩ、H5VU10U×3を継続。モジュールVBUS枝だけに2.2 Ω / C22939。BQ INは抵抗の手前で分岐。D−=34、D+=35、データ線直列抵抗なし |
| 電池コネクタ | JST S2B-PH-SM4-TB(LF)(SN) / C295747、横挿しSMT。1=BAT+、2=GND |
| 電池の逆接続保護 | 2026-11-11追加（ブランチ claude-fable-mosfet-2026-11-11、未マージ）。J3の1番とBQ24072 BATの間にPチャネルMOSFET Q1＝AO3401A / C15127（Basic、SOT-23）を直列に1個。ドレイン=J3側（ネット `/BAT_CONN`）、ソース=BAT、ゲート=GND。C24（4.7 µF）はBQ側に残す。[選定根拠](wireless-bom-candidates.md#電池の逆接続保護q12026-11-11)、[手順上の注意](brick-avoidance.md) |
| SWD / リセット | TC2030-NL接点を必ず設ける。VTref=VDD(28)、SWDIO=51、SWCLK=53、nRESET=P0.18(40)。6番NC。消去直後1.8 Vと初期化後3.3 Vへ対応する経路を確保 |
| マトリクス等 | 6列×10行、53接点、カソード行側、`col2row`を維持。2026-11-10にモジュールを基板左端へ移し、GPIO割当てを組み直した。入力12本のうち上段6本は低周波専用のパッド4〜14、列6本は制限なしGPIOで、ZMKで高駆動を指定。[現在の割当て表](wireless-pin-assignment.md)を参照 |

発注型番・JLC番号・数量は[仮BOM](wireless-bom-draft.csv)、シンボルとランドは[登録表](../pcb/wireless-library.csv)。**20品種・82点、Basic 13品種73点、Extended 7品種9点**（2026-11-11にQ1を追加）。[参照番号付きBOM](../pcb/schematic-review/bom.csv)を回路図から生成・照合済み。実装座標はPCB作成後で、現時点のCSVをJLC製造用BOMとして使わない。

ExtendedのREG0インダクタはBasic対案との電流特性比較後に了承済み。電池コネクタも廉価対案との比較後にSMTを了承済み。比較結果は[選定根拠](wireless-bom-candidates.md)に残す。

BQ24072の選定理由は当初READMEにあったOUTの電池電圧追従とBQ24075との出力電圧差を引き継ぐ。nice!nanoの公開図がBQ24075であることと、量産品に関する第三者経由のBQ24072採用情報は区別する。ビルド成功から充電ICの適合を判断しない。

## 検証済みの範囲

- ZMK main `4dd95d7840eb3d5a3f59bb29fbf1ab054715ef85` / Zephyr `10ba6d0cb38bc3d258775d27982f707599320085`で1×1最小構成をビルド済み。両DC/DC、XTAL/50 ppm、USB/BLE、P0.18、フラッシュ領域を出力設定で照合した。
- ブートローダ候補はAdafruit 0.11.0のnice_nano用SoftDevice結合HEX。初期化ソースとファイル領域を照合済み。初回実機でVDD/UICRを読戻す。[起動条件](zmk-hardware-bringup.md)を参照。
- 採用部品のライブラリはKiCadで読み込み、BOMとの一致、ピン・パッド番号、専用ランド寸法を検査済み。[検査記録](../pcb/LIBRARIES.md)を参照。
- 無線版回路図はERCエラー0・警告0。ネットリストで電源・USB・SWD・LF水晶・18 GPIO・BOMを照合し、既存マトリクス105部品の座標と接続も確認した。[検査結果](../pcb/schematic-review/validation.json)と[PDF](../pcb/schematic-review/ts52k-wireless.pdf)を参照。

REG0 LDOは以前の検証用の暫定設定。ZMKの版を変えるたびに回路を変更する要求ではなく、実装回路と基板定義の対応を維持する。UF2生成は実機起動の証明ではない。旧RP2040版のERC/DRC結果は当時の回路・ライブラリ構成に対する履歴で、現在の検査結果ではない。

## 後日扱う事項

電池製品・容量・外形とケース設計は後日。SWD機材・購入時期・モジュール購入先も後日。通常品と秋月の書き込み済み品を候補にでき、どちらでもSWDランドは必須。機材購入や秋月品の採用を現在の工程の条件にしない。

独自の0〜50℃等の温度要件や高精度品への変更は採用していない。実機の起動、LF精度、USB波形・ESD、BLE通信は試作後の確認。内部容量やUSB電流管理の未実証を、決定済み部品の再選定・初版の追加制御へ自動的につなげない。

## 会話監査12項目への是正

| 監査項目 | 是正後の状態 |
| --- | --- |
| 1. 不要ライブラリの保持 | RP2040用ライブラリ一式・旧LDO・登録を削除。旧回路図参照の例外を撤回 |
| 2. VDD単体への独自簡略化 | 5個構成をBOM・README・登録済み部品へ統一 |
| 3. 部品決定後の調査・保留の反復 | 容量の旧候補・選定停止記述を現行資料から除去し、試作確認と区別 |
| 4. Basic優先・価格比較の不足 | 全19品種を分類。抵抗・容量は全てBasic、了承済みのExtended例外と比較根拠を明記 |
| 5. 固定充電の未決扱い | USB100固定を決定として統一。追加制御案を現行の作業候補から除去 |
| 6. 電池・ケースへの範囲拡大 | 現在の作業候補から製品選定・収納設計を除外。コネクタだけを採用BOMへ記載 |
| 7. 暫定LDOの固定条件扱い | 現行の両DC/DC構成を冒頭に明示。旧v0.3は試験履歴として分離 |
| 8. 独自温度要件 | 温度範囲・精度変更を未依頼の要件として使わない |
| 9. BQ24072の選定理由の見落とし | 既存理由を復元し、メーカー条件と第三者情報を区別 |
| 10. SWD機材推奨前の調達比較不足 | 通常品／書き込み済み品を先に示し、機材は未決の調査例と明記 |
| 11. 109 mAの説明 | ISET設定値とUSB100入力制限・実充電電流を各資料で区別 |
| 12. 記録・検査状態の過大報告 | 古い進捗・未決記述を整理。旧ERC/DRCと現在のライブラリ検査を区別 |

再発防止の作業方針は[AGENTS.md](../AGENTS.md)へ記載した。既存の決定事項を参照して次の依頼を実行し、解消済みの論点で繰り返し判断を求めない。
