sadaoikebe/ts52k/pcb/mcu-layout/ground-reference.png

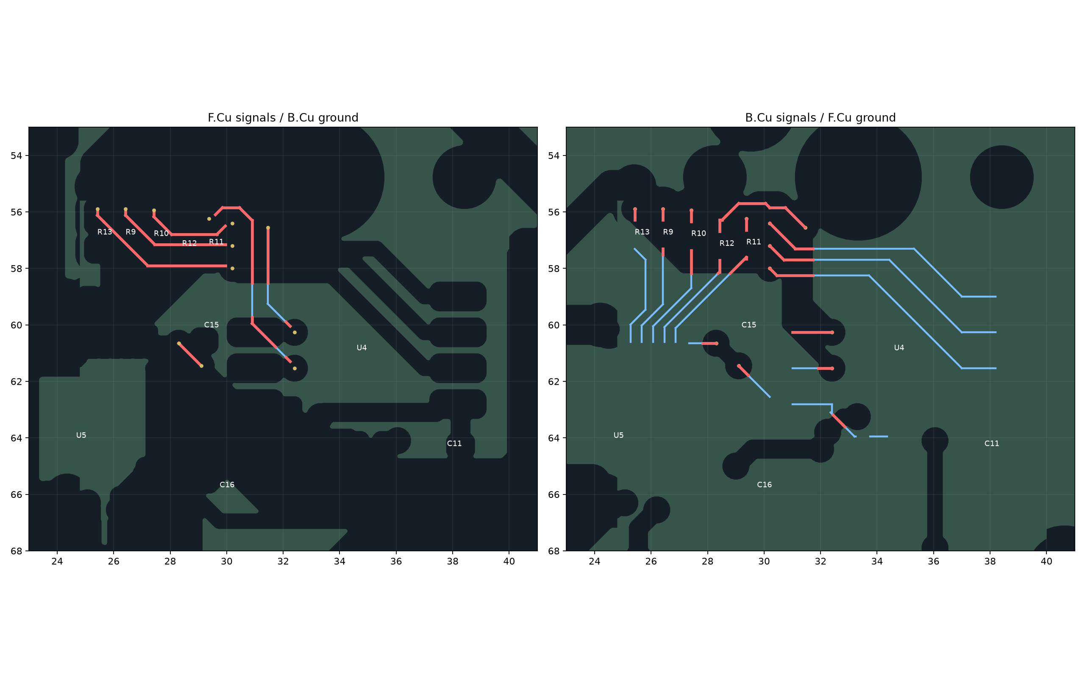
pcb/mcu-layout/ground-reference.png
