sadaoikebe/ts52k/pcb/placement-review/antenna-module-2026-11-10.png

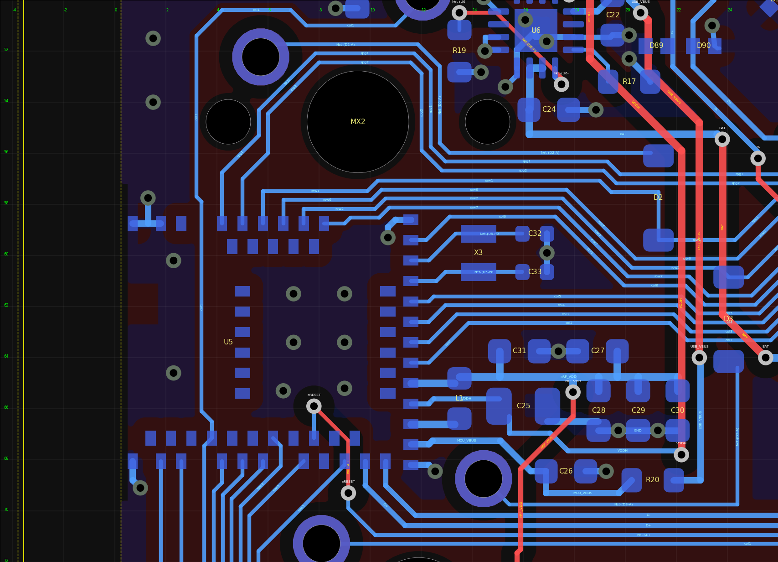
pcb/placement-review/antenna-module-2026-11-10.png
