sadaoikebe/ts52k/pcb/placement-review/gpio-schematic.png

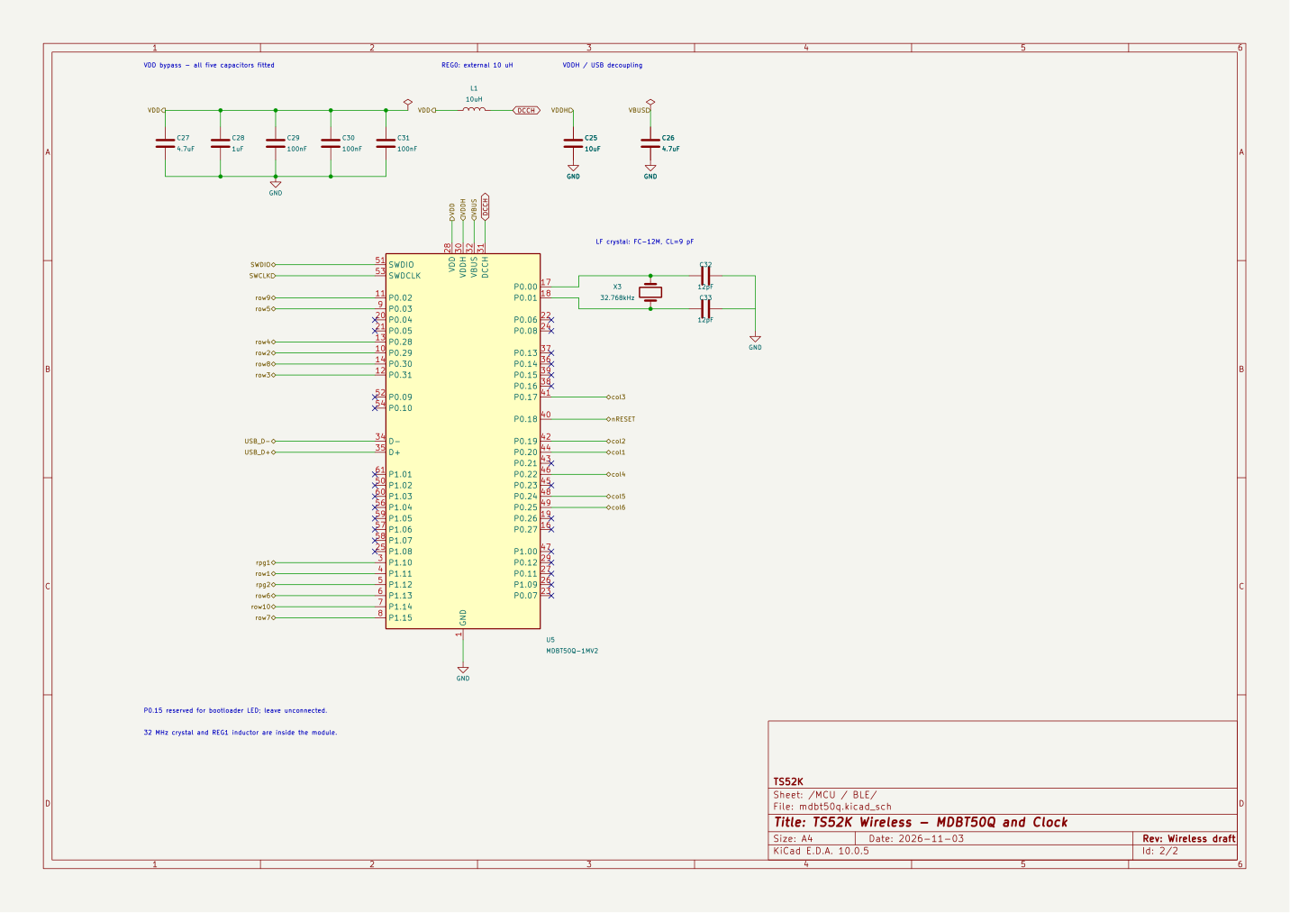
pcb/placement-review/gpio-schematic.png
