sadaoikebe/ts52k/pcb/placement-review/matrix-bus.png

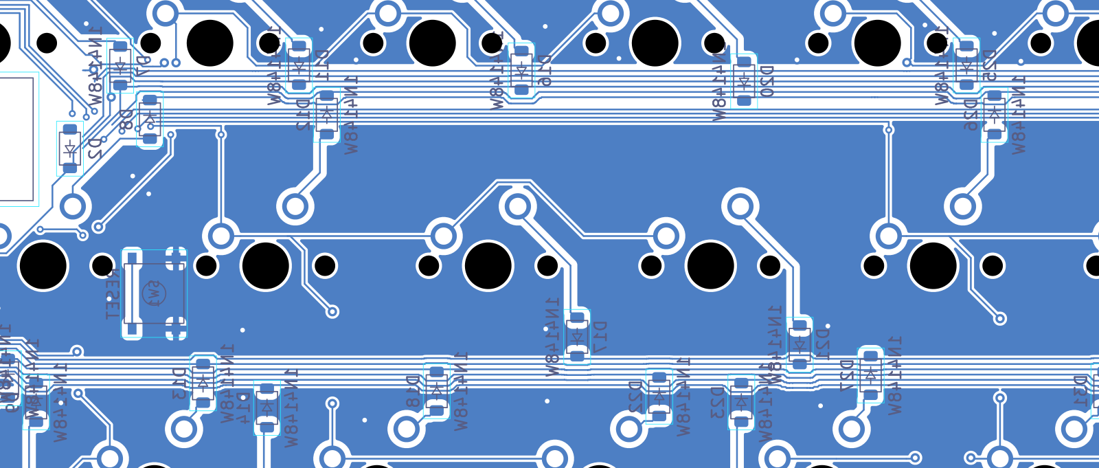
pcb/placement-review/matrix-bus.png
