sadaoikebe/ts52k/pcb/placement-review/matrix-front.png

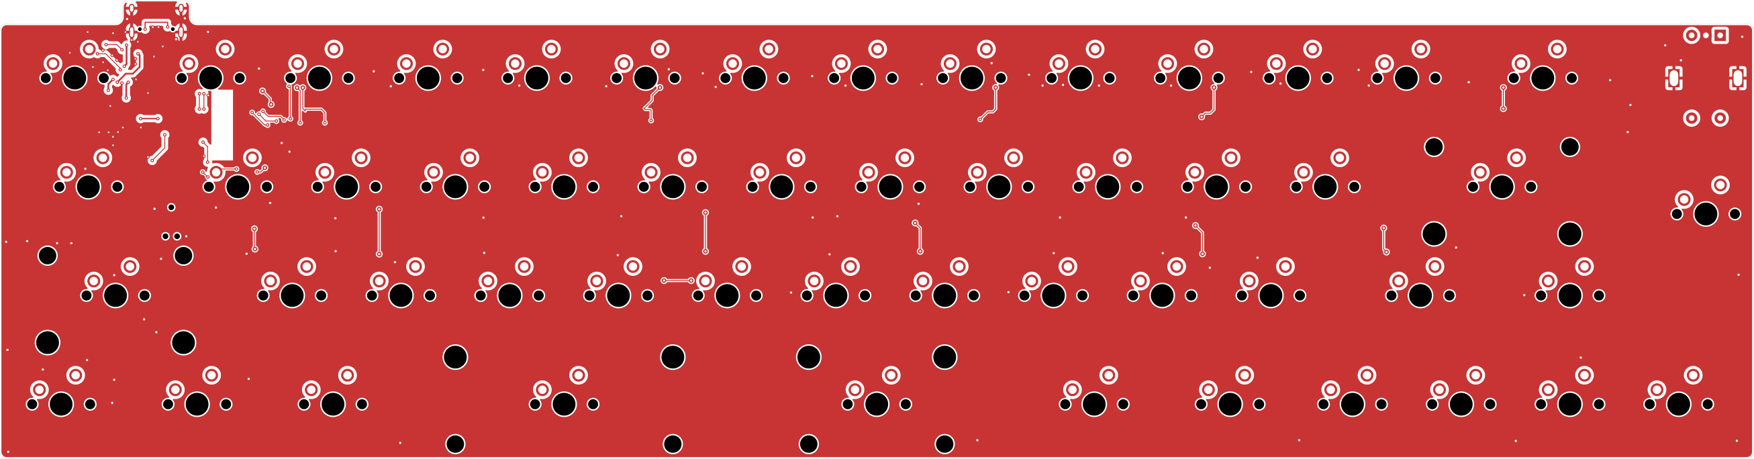
pcb/placement-review/matrix-front.png
