sadaoikebe/ts52k/pcb/placement-review/mcu-area.png

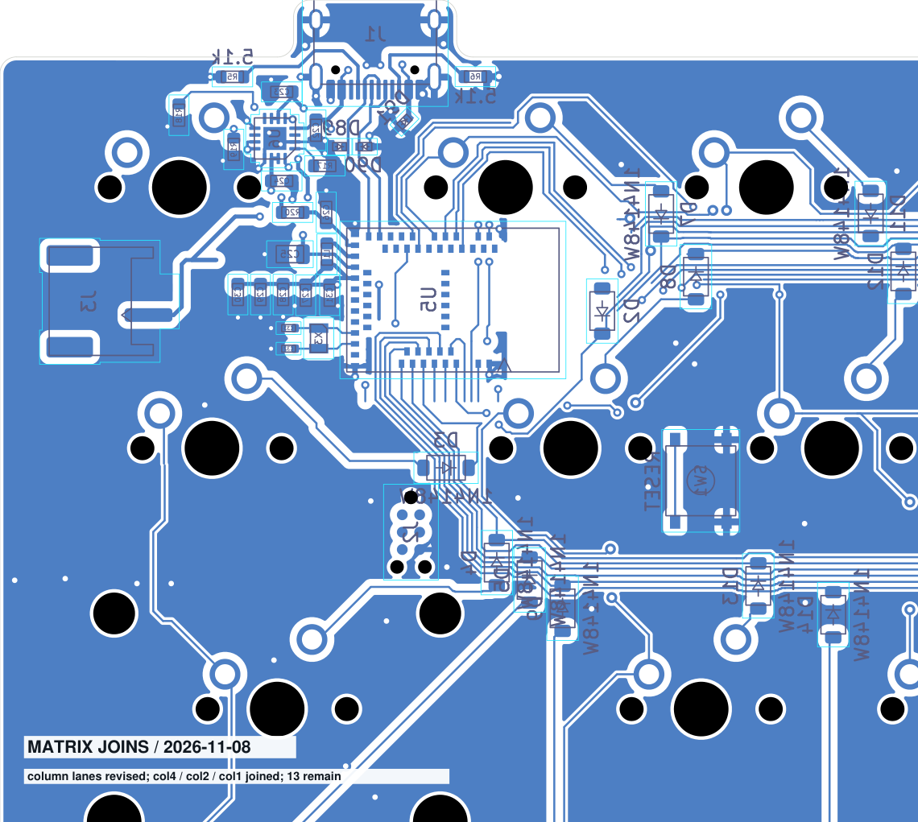
pcb/placement-review/mcu-area.png
