sadaoikebe/ts52k/pcb/placement-review/mx2-west-2026-11-10.png

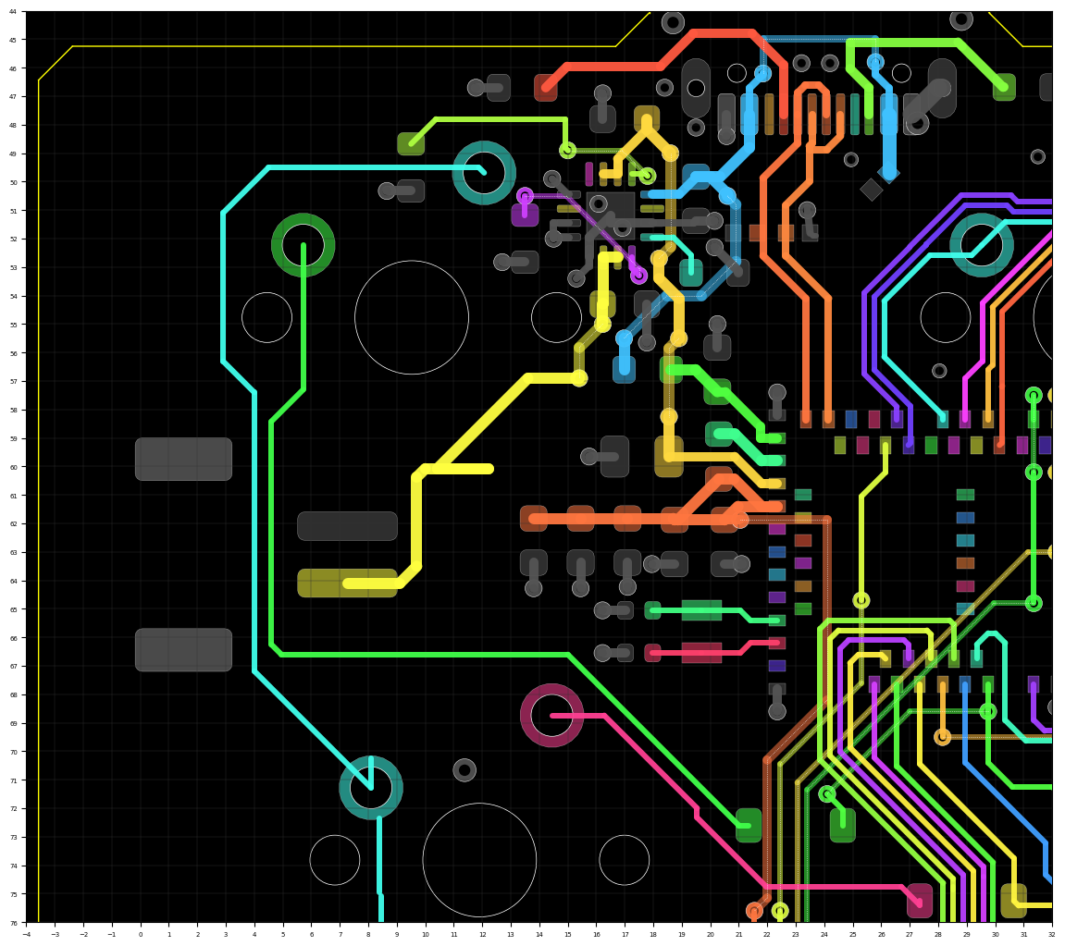
pcb/placement-review/mx2-west-2026-11-10.png
