sadaoikebe/ts52k/pcb/placement-review/power-front.png

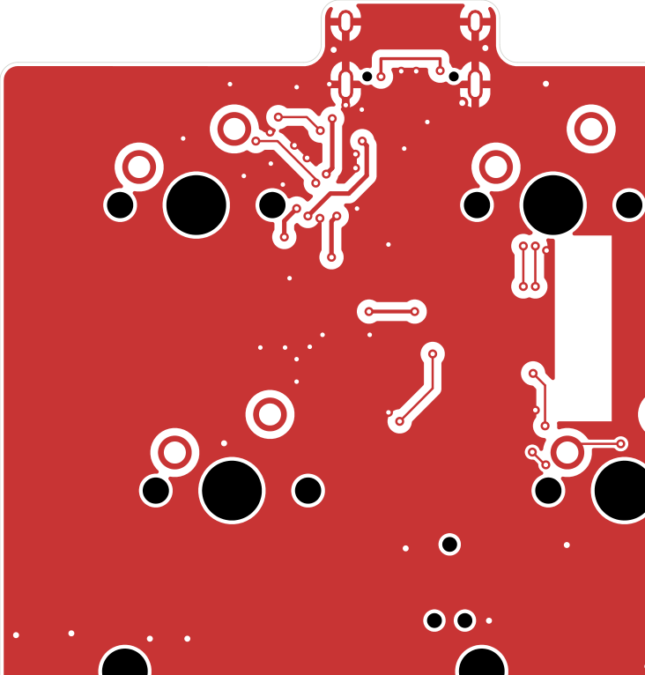
pcb/placement-review/power-front.png
