sadaoikebe/ts52k/pcb/schematic-review/mcu.png

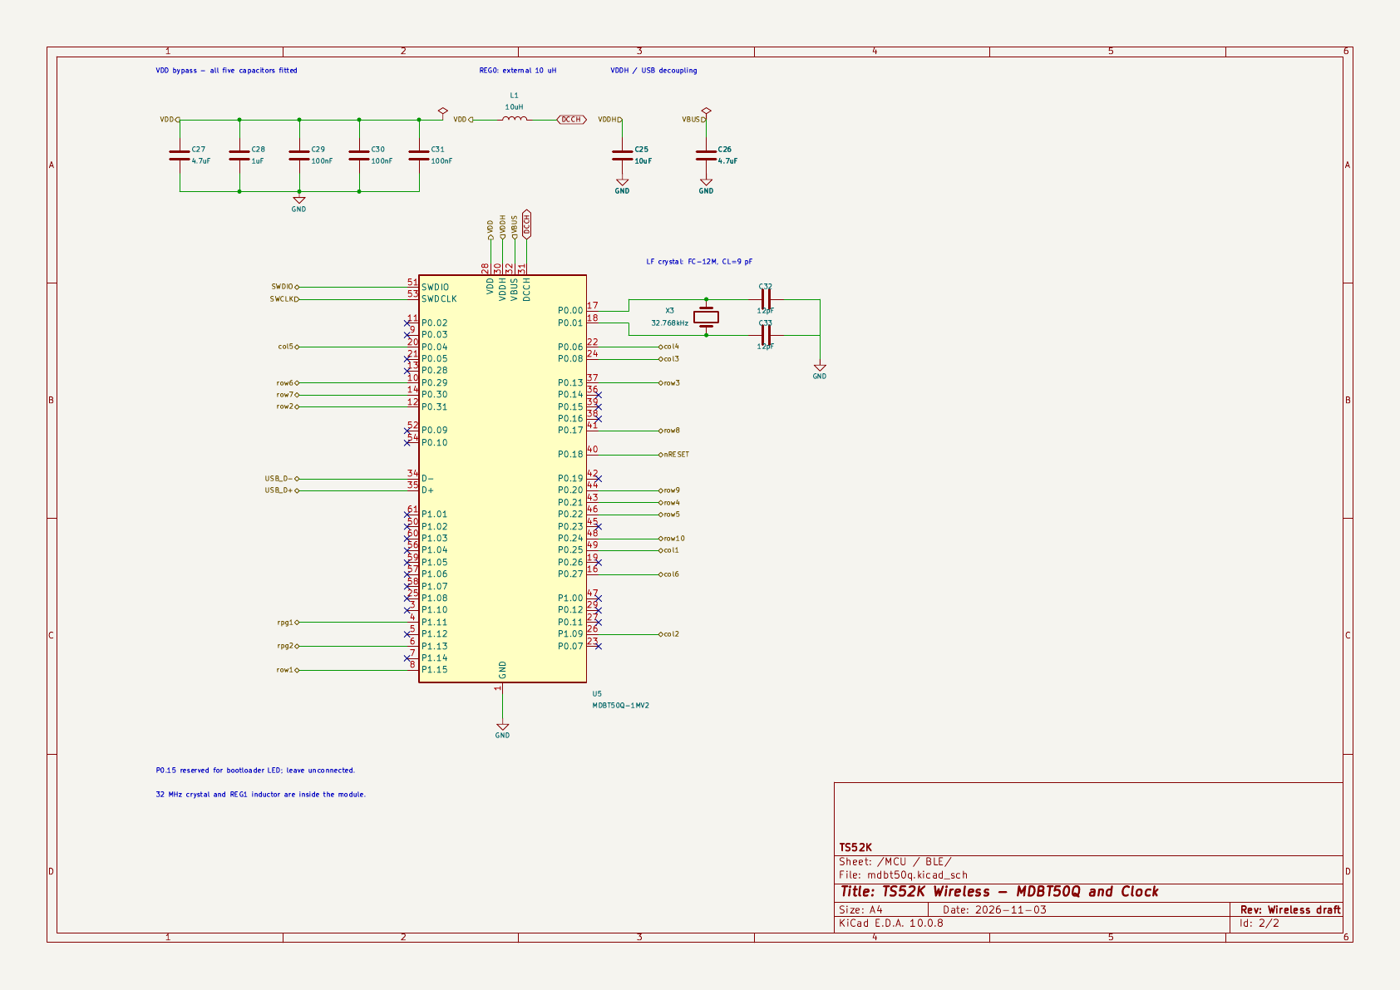
pcb/schematic-review/mcu.png
