sadaoikebe/ts52k/pcb/schematic-review/overview.png

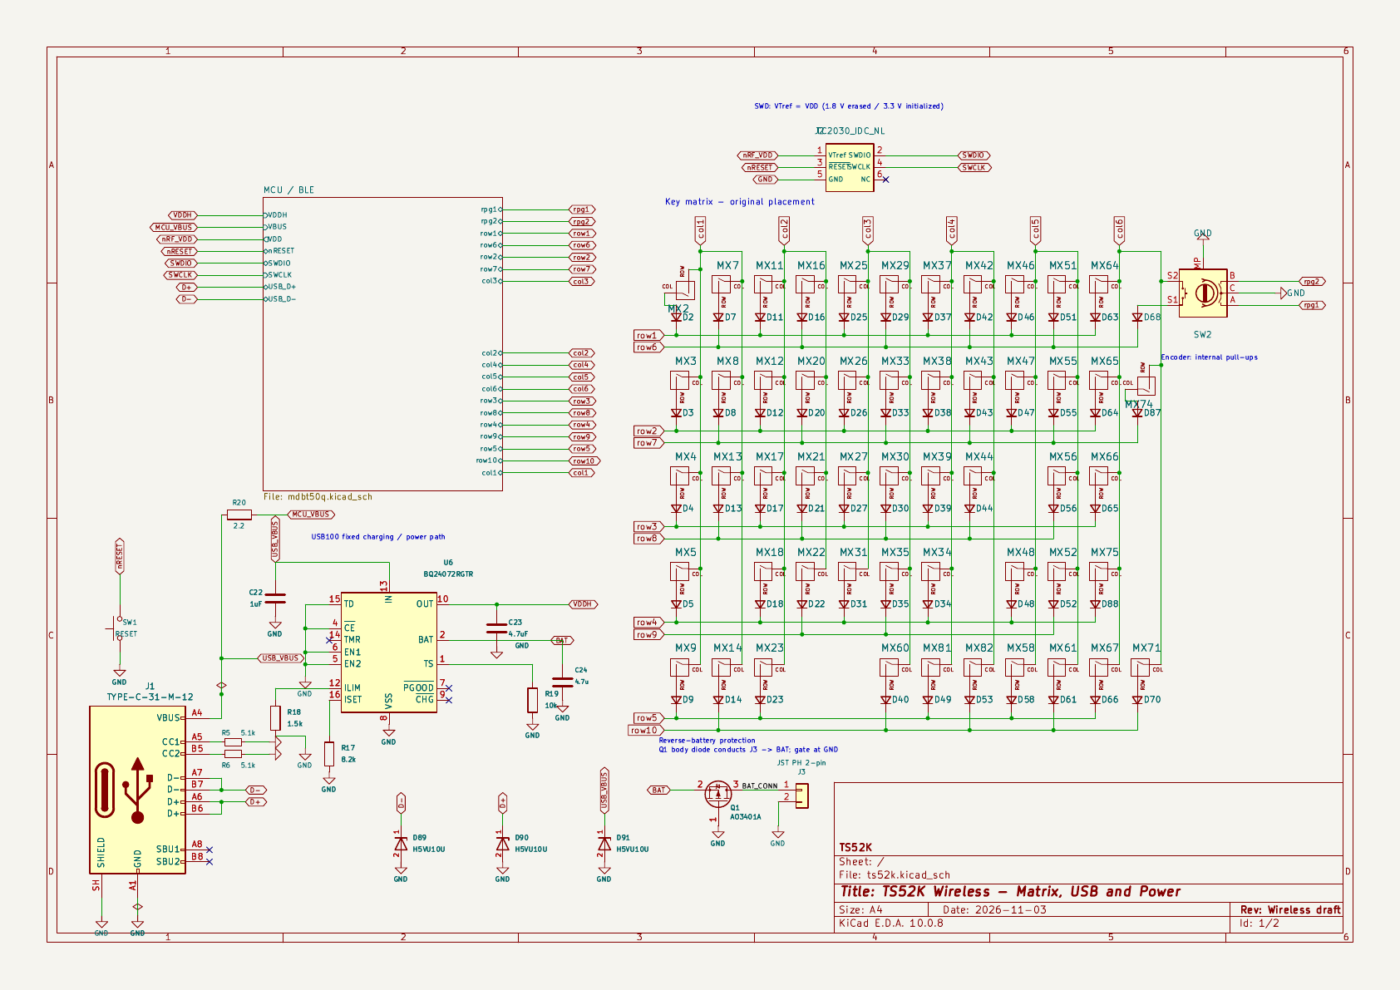
pcb/schematic-review/overview.png
