sadaoikebe/ts52k/notes/wireless-bom-candidates.md

# 無線版BOM候補と先行例の対応

2026-11-11更新（Q1を追加して20品種・82点。末尾の節）。2026-11-10時点で19品種・81点のライブラリ登録と無線版回路図への反映・検査まで完了した。[参照番号付きBOM](../pcb/schematic-review/bom.csv)と選定表は一致。PCBも無線版へ移行済みだが、製造データは未作成であり、この表は製造用BOMではない。現行方針は[決定事項](wireless-decisions.md)を参照。
ファームウェアの検証記録は `C:\Users\marur\zmk-config\docs\ts52k-main-bringup.md`、ハードウェア調査の詳細は [zmk-hardware-bringup.md](zmk-hardware-bringup.md)。

電源容量の最新案とUSB固定充電構成の決定は [wireless-power-input.md](wireless-power-input.md)。初版はBQ24072のEN1・EN2・CEをGNDに固定し、USB100と現在のUSB申告設定を維持する。USB状態連動の充電制御や追加GPIOは設計範囲外。電流管理上の制約は記録済みで、未決事項として再提起しない。以下の容量は公称候補で、実効容量の検証完了を意味しない。

## 今回の判断基準

メーカー参考回路と、実際のキーボード用コントローラの構成を優先する。温度範囲を先に独自設定して、それを満たすために部品を高級化する進め方は採らない。0〜50℃は確定要件ではない。

現在の比較基準は、ZMK `4dd95d7840eb3d5a3f59bb29fbf1ab054715ef85` / Zephyr 4.1.0でビルドしたTS52K最小構成。VDDH給電、REG0/REG1 DC/DC、外付け32.768 kHz、50 ppm、USB/BLE、P0.18リセット。この文書作成では設定・UF2を変更していない。

「踏襲」は結線・方式を参考にできる意味で、TS52Kの実機動作保証ではない。「差分」は追加照合が必要、「未確認」は発注仕様や動作実績を裏づけられていないもの。

## 先行例の比較

| 参考元 | 確認できた内容 | TS52Kへの適用と限界 |
| --- | --- | --- |
| Raytac MDBT50Q仕様書 Version K p37–40 | REG0 DC/DC参考図はDCCH–VDDに10 µH。LF水晶と12 pF×2。REG1用インダクタと32 MHz水晶はモジュール内蔵 | モジュール周辺の主たる結線根拠。メーカー参考構成であり、完成キーボードの実績ではない |
| nice!nano v2 公開回路 | 裸のnRF52840、REG0に10 µH、LFはFC-12M＋12 pF×2。充電IC表記はBQ24075 | 電源・LFクロックの方式を踏襲。TS52Kはモジュールなので、内蔵部品を外へ重複実装しない。FC-12Mの完全な発注仕様は図から確定できない |
| 検証に使用したZMK mainのnice!nano v2 | REG0/REG1 DC/DC、基準ビルドではXTAL/50 ppm | 今回のTS52K設定と対応する。旧v0.3との差を確認済み。公開回路とファームウェアの現行設定を組み合わせた照合であり、量産BOMが全て公開されているわけではない |
| MDBTMicro-50Q | 同系列MDBT50Q。外付け3.3 V LDO、TP4057、水晶32.768 kHz・3215、12 pF×2 | 電源はVDD/VDDHを同電圧で使う別方式なのでコピーしない。v1.4は未製造・未試験、v1.3も製造・実装済みだが未試験と記載。水晶の確実な動作実績の根拠にはしない |
| nRFMicro作者の部品資料 | 水晶候補FC1610AN、FC-12M、FC-135。1.4への3215実装と部品番号C32346を記載 | 完全型番を追跡する補助資料。水晶任意・RC使用の説明もあり、そのBOMだけでTS52KのXTAL/50 ppmとの組合せを検証済みとはしない |

出典:
- [Raytac Version K](https://cdn.sparkfun.com/assets/4/7/4/3/8/_nRF52840__MDBT50Q-1MV2___MDBT50Q-P1MV2_Ver.K_spec.pdf)
- [nice!nano公開回路](https://nicekeyboards.com/docs/nice-nano/pinout-schematic/)
- [MDBTMicro BOM](https://github.com/siderakb/mdbt-micro#bom)、[版ごとの試験状況](https://github.com/siderakb/mdbt-micro/releases)
- [nRFMicro作者の部品資料](https://github.com/joric/nrfmicro/wiki/Components)

## BOM候補

2026-11-03更新: コンデンサは[Basic部品での現行選定](capacitor-selection.md)を採用。VDD外付けはnice!nano公開回路とNordicの例に合わせ、**4.7 µF＋1 µF＋100 nF×3**で決定。従来の4.7 µF単体案を置き換えた。

数量は1基板あたり。採用19品種は全て型番・JLC番号・ランドを登録済み。電池製品とSWD機材は選定対象外の記録。JLC分類・価格は取得時点の記録で、発注時の見積とは区別する。現行集計は[仮BOM CSV](wireless-bom-draft.csv)、主要端子と回路移行時の確認は[照合表](wireless-bom-audit.md)を参照。

| 部品・用途 | 採用型番／値 | 数量 | 出典・判定 | 配置時・実機・後日の確認 |
| --- | --- | ---: | --- | --- |
| MCUモジュール | MDBT50Q-1MV2 / C5118826 | 1 | Raytac、既存案・踏襲。Version Lとランド照合済み | 発注時の調達。ENなどの別型番へ自動置換しない |
| MCUモジュール・書き込み済みの調達対案 | 秋月電子117928、MDBT50Q-1MV2、Adafruit nRF52 Bootloader書き込み済み | 上の通常品と排他で1 | モジュール単体での販売を確認。税込1,430円・在庫あり（2026-11-03） | 通常品とどちらを購入するかは後日決める。秋月品の場合はブートローダー構成・実装手配を照合 |
| REG0インダクタ | Murata LQM18DN100M70L / C713281、10 µH、±20%、0603、Extended | 1 | Basic対案との比較後、2026-11-03にユーザーがExtended採用を了承し確定。nice!nanoの採用品番ではない | DCCH（31）–VDD（28）の直近に配置。従来READMEの「置かない」から変更する項目 |
| LF水晶 | Epson X1A0000610008 / C96341（FC-12M、32.768 kHz、CL=9 pF、±20 ppm、Extended） | 1 | 既存の電気仕様候補に対応するJLC登録を確認。メーカー梱包末尾00を付ける場合はX1A000061000800 | nice!nanoの末尾型番と一致する証拠は未取得。12 pF×2との起動・精度は実機確認 |
| LF負荷コンデンサ | 0402CG120J500NT / C1547、12 pF、50 V、C0G、±5%、0402、Basic | 2 | 初回実装用に選定 | CL=9 pF水晶用。モジュール端子・PCB寄生容量を含む精度は実機確認 |
| VDDデカップリング・4.7 µF | CL10A475KO8NNNC / C19666、4.7 µF、16 V、X5R、0603、Basic | 1 | nice!nano型の5個構成を初版へ採用 | VDD（28）–GND直近。内部込みの特性・実機動作は未検証 |
| VDDデカップリング・1 µF | CL10A105KB8NNNC / C15849、1 µF、50 V、X5R、0603、Basic | 1 | 同上。BQ24072 INと型番共用 | VDD（28）–GND |
| VDDデカップリング・100 nF | YAGEO CC0603KRX7R9BB104 / C14663、100 nF、50 V、X7R、0603、Basic | 3 | 同上。JLC個別ページでBasicと型番確認 | VDD（28）–GND、短い帰路を確保 |
| VDDHデカップリング | CL21A106KAYNNNE / C15850、10 µF、25 V、X5R、0805、Basic | 1 | Raytac公称値を維持 | モジュール直近 |
| VBUSデカップリング | CL10A475KO8NNNC / C19666、4.7 µF、16 V、X5R、0603、Basic | 1 | Nordic/nice!nano公称値 | USB直結合計5.7 µF |
| 充電IC | BQ24072RGTR / C140288、VQFN-16 RGT 3×3 mm、Extended | 1 | 決定済み型番に対応するJLC番号を確認 | BQ24075表記の公開図との違いは下記。T付き型番に置換しない |
| 充電IC IN容量 | CL10A105KB8NNNC / C15849、1 µF、50 V、X5R、0603、Basic | 1 | TI公称値 | IN直近 |
| 充電IC BAT容量 | CL10A475KO8NNNC / C19666、4.7 µF、16 V、X5R、0603、Basic | 1 | TI公称値 | BAT直近 |
| 充電IC OUT容量 | CL10A475KO8NNNC / C19666、4.7 µF、16 V、X5R、0603、Basic | 1 | TI公称値 | OUT直近、VDDHと別ランド |
| ISET抵抗 | 0603WAF8201T5E / C25981、8.2 kΩ、±1%、0.1 W、0603、Basic | 1 | Basic優先で8.87 kΩから変更。下記参照 | ISET単独の典型設定約108.5 mA、実際はUSB100入力制限も受ける |
| ILIM抵抗 | 0603WAF1501T5E / C22843、1.5 kΩ、±1%、0.1 W、0603、Basic | 1 | 既存値を継承 | EN1/EN2共にGNDのUSB100。ILIMで100 mAを設定するわけではない |
| TS抵抗 | 0603WAF1002T5E / C25804、10 kΩ、±1%、0.1 W、0603、Basic | 1 | 既存値を継承 | 固定抵抗で温度監視を代替。セルの許容充電条件は電池選定時に確認 |
| USB-C | HRO TYPE-C-31-M-12 / C165948、Extended | 1 | RP2040版の採用品を継承。JLC分類・価格を再確認 | 既存コネクタ位置を基準に、改版後のランド・ケースとの位置を照合 |
| CC抵抗 | 0603WAF5101T5E / C23186、5.1 kΩ、±1%、0.1 W、0603、Basic | 2 | 既存値を継承し完全型番を確定 | CC1/CC2からGNDへ各1個。CC同士は接続しない |
| USB VBUS直列抵抗 | 0603WAF220KT5E / C22939、2.2 Ω、±1%、0.1 W、0603、Basic | 1 | Nordic推奨・Raytac Version L p42の任意抵抗を採用 | モジュールVBUS枝のみ。4.7 µFは抵抗の後。充電IC INは手前で分岐 |
| USB ESD | H5VU10U / C22395519、DFN1006-2L、Extended | 3 | 既存品を継続採用。メーカーRev.2.0資料のCJ最大0.8 pFを確認 | D+/D−/VBUS。VBUS用は2.2 Ωの手前。保護性能は実機試験で確認 |
| リセットスイッチ | XKB TS-1187A-B-A-B / C318884、5.1×5.1×1.5 mm、SMT、Basic | 1 | 既存品を継続。JLC分類・価格確認済み | P0.18–GND。RP2040のBOOTSEL用1 kΩは省く |
| マトリクスダイオード | ST(Semtech) 1N4148W / C81598、SOD-123、Basic | 53 | 既存品を継続。JLC分類・価格確認済み | カソード行側。最小UF2は1接点だけで全マトリクス未実装 |
| 電池 | 保護付き1セルLiPo、4.2 V充電。具体的な製品は後で選ぶ | 1 | ユーザー指示により、容量・価格・外形はケース製作時に選定する | 今回の部品選定・BOM整理を止める条件にしない |
| 電池コネクタ | JST S2B-PH-SM4-TB(LF)(SN) / C295747、PH・2極・2.0 mmピッチ、横挿しSMT、Extended | 1 | 2026-11-03選定。一般的なLiPoパック用PHR-2に合わせる | 回路図ではメーカーの1番端子をBAT+、2番をGNDとする |
| 電池側ケーブル | JST PHR-2付き。電池付属品を優先 | 1 | 電池選定時に手配し、今回は別売ケーブルを選定しない | 採用電池の実際の極性を基板側に合わせる |
| SWDランド | TC2030、VTref=VDD、SWDIO、nRESET、SWCLK、GND、6番NC | 1箇所 | 結線・ランド照合と登録済み | 実際の配置面とアクセスを確認。実装部品ではない |

アンテナ、32 MHz水晶、REG1のインダクタはモジュール内部。別途BOMには追加しない。nice!nanoのLED用電源スイッチ回路も今回の構成には含めない。

### リセットスイッチ・ダイオード・充電ICのJLC番号（2026-11-03）

- [XKB TS-1187A-B-A-B / C318884](https://jlcpcb.com/partdetail/C318884): **Basic**、少量単価$0.0207。既存製造BOMと同一品で、5.1×5.1 mm・高さ1.5 mm・上押しSMTを継続する。押すとP0.18（モジュール40番）をGNDへ接続する。RP2040版BOOTSELに用いた直列1 kΩは残さない。
- [ST(Semtech) 1N4148W / C81598](https://jlcpcb.com/partdetail/C81598): **Basic**、少量単価$0.0124、SOD-123。キー52個＋エンコーダ押し込み1個の計53個に使い、既存のカソード行側の向きを維持する。マトリクス全体のファームウェア実装は別途。
- [TI BQ24072RGTR / C140288](https://jlcpcb.com/partdetail/BQ24072RGTR/C140288): 決定済み充電ICに対応するJLC番号を追加。**Extended**、QFN-16-EP 3×3 mm、少量単価$0.9975（1〜9個）。方式や型番の再選定ではなく調達番号の補完。

上記価格は選定時の部品単価で実装費別。選定時には候補表だけを更新し、その後無線版回路図へ反映・検査した。旧製造BOMとPCBは未更新。

### 電池コネクタの選定（2026-11-03）

ユーザー指示により、今回は基板側コネクタだけを選定する。電池製品の選定・ケースの設計や収納検討は今回の作業範囲から外す。電池はケース製作時に、収まりと価格を基準に選ぶ。

基板側は **JST S2B-PH-SM4-TB(LF)(SN) / C295747**。PHシリーズの2極、2.0 mmピッチ、横挿し、補強金具付きSMTとする。[JST公式資料](https://www.jst-mfg.com/product/pdf/eng/ePH.pdf)でPHR-2との組合せと2 A定格を確認。[JLCPCB C295747](https://jlcpcb.com/partdetail/C295747)はExtendedで、少量単価$0.2269（1〜49個、実装費別）を確認した。

**コスト比較の追記:** このJST品を性能上必須として選んだわけではない。ユーザーからExtended分類を指摘され、Basicと廉価品を追加確認した。今回確認した範囲ではPH・2極のBasic品は見つからず、安いPH互換品もExtendedだった。廉価対案は[CAX PH-2AW / C722769](https://jlcpcb.com/partdetail/CAX-PH2AW/C722769)、2極・2.0 mmピッチ・横挿し・2 A、少量単価$0.0085。こちらはスルーホール品なので、JSTのSMTランドへそのまま置換する品ではない。メーカー指定寸法による専用ランドが必要。部品単価は約96%下がるが、JLC実装を頼む限りExtended分類は残る。手付けに回せばこの品種のJLC実装費を除けるが、実装方法をユーザーの了承なく変更したことにはしない。上表のJST案に加えた比較記録であり、C722769への変更はまだ行っていない。

**決定:** ユーザーが「まあSMTでいいよ」と了承。JST S2B-PH-SM4-TB(LF)(SN) / C295747のSMT案を維持する。

回路図では1番=BAT+（BQ24072 BAT）、2番=GNDに統一し、基板に＋／−を表示する。PHシリーズ自体に電池の極性規約があるという意味ではない。電池側はPHR-2付きケーブルを使い、購入するパックの配線極性を基板に合わせる。電池の具体的な型番や別売ケーブルは今回のBOMに追加しない。

### USBコネクタ・CC・ESD部品の照合（2026-11-03）

旧製造BOM `pcb/jlcpcb/assembly/ts52k-bom.csv` のJ1=C165948、R5/R6=C23186、D89/D90/D91=C22395519を継続し、無線版回路図でも照合済み。旧PCBと製造BOMは未更新。

- **USB-C:** [HROメーカー説明](https://www.krhro.com/Product-Details/726.html)はTYPE-C-31-M-12を16接点、8.94×7.35×3.16 mm、20 V/5 A、着脱10,000回とする。[JLCPCB C165948](https://jlcpcb.com/partdetail/C165948)でExtended、少量単価$0.1874を確認。既存のケース開口・実装方式との整合を優先し、この既存品を継続する。
- **CC抵抗:** [JLCPCB C23186](https://jlcpcb.com/partdetail/C23186)は0603WAF5101T5E、5.1 kΩ±1%、0.1 W、75 V、0603、Basic、少量単価$0.0015。CC1/CC2は独立して各抵抗でGNDへ落とす。完全型番を上表へ反映した。
- **ESD:** [JLCPCB C22395519](https://jlcpcb.com/partdetail/C22395519)はH5VU10U、Extended、少量単価$0.0186。JLCに添付されたメーカーRev.2.0仕様書を取得し、VRWM=5 V、漏れ電流最大0.2 µA（5 V・25℃）、CJ最大0.8 pF（0 V・1 MHz）、VC最大10 V（1 A・8/20 µs）／16 V（5 A・8/20 µs）、DFN1006-2Lを確認した。メーカーサイトの代表値や別版の0.2 pFを現行仕様の最大容量として使わない。

価格は少量区分で、実装費別。**2026-11-03更新:** ESDは既存品の継続採用、VBUS直列抵抗はBasicの2.2 Ω / C22939を1個追加と決定した。メーカー参考図、分岐位置、保護性能の未検証範囲は[電源・USB入力ノート](wireless-power-input.md)に記録した。ESD素子自身のIEC耐量や低容量だけでnRF52840端子の保護を保証しない。固定充電構成やZMK設定の変更はない。

## BQ24072を選んだ根拠の訂正と引継ぎ

2026-11-03抵抗選定: [8.2 kΩ C25981](https://jlcpcb.com/partdetail/0603WAF8201T5E/C25981)、[1.5 kΩ C22843](https://jlcpcb.com/partdetail/23570-0603WAF1501T5E/C22843)、[10 kΩ C25804](https://jlcpcb.com/partdetail/C25804)は全てJLCPCBでBasicを確認。0603・±1%・0.1 Wに統一する。

従来の8.87 kΩ [C23248](https://jlcpcb.com/partdetail/23975-0603WAF8871T5E/C23248)はExtendedだったため、ISETはBasicの8.2 kΩを採用する。TI SLUS810NのISET範囲590 Ω〜8.9 kΩ内にあり、典型係数890 AΩで890/8200≒108.5 mA（従来8.87 kΩは約100.3 mA）。これはISET単独設定で、USB100固定の入力制限とシステム負荷により実充電電流は抑えられる。USB100の配線は維持し、充電電流を108.5 mA保証とは記載しない。終端・予備充電のISET依存しきい値も約8%変わるため、電池選定ではこの設定を使う。9.1 kΩは推奨範囲外なので選ばない。値の変更は本節と上表が現行で、README等の8.87 kΩ記載は旧案。

**109 mAと50／100 mAの整理（2026-11-03）:** 50／100 mAの切替は[Seeed XIAO nRF52840](https://wiki.seeedstudio.com/XIAO_BLE/#battery-charging-current)の方式。BQ24072の入力制限モードはUSB100／USB500／ILIM抵抗設定／停止で、今回使うのはUSB100固定。TI SLUS810N p12のUSB100入力制限は90／95／100 mA（最小／典型／最大、同表の条件下）。p25では、ISET設定が入力制限より大きければ、入力制限からOUT負荷を差し引いた電流で充電すると明記される。したがって8.2 kΩの採用は「実充電電流を109 mAへ増やす」という変更ではない。USB100での終端電流はp13の0.033×ICHGが典型で、今回のISET設定なら約3.6 mA、予備充電電流は約10.7 mA。

[nice!nano公式FAQ](https://nicekeyboards.com/docs/nice-nano/faq/)は標準充電を100 mAと説明し、[公式の電池説明](https://nicekeyboards.com/docs/nice-nano/#recommended-batteries)では実際は約85 mA、boost時は約500 mAと説明している。TS52Kも約100 mAクラスを維持する。公開回路の方式・公式の電流説明は参考にするが、nice!nanoが8.2 kΩを採用していると確認したわけではない。電池の許容充電電流は、未選定のセル仕様で確認する。

先の会話で「採用理由は整理されていない」と回答したのは誤り。READMEには既に、出力電圧の違いとnice!nano量産品への言及がある。

TIの[SLUS810N](https://www.ti.com/lit/ds/symlink/bq24072.pdf)では、BQ24072の出力は電池電圧追従、BQ24075は5.5 V設定で、両者は同じではない。従って「公開図が75だからTS52Kも75にする」とはしない。BQ24072を採用品として維持する。

nice!nanoで第2バッチから72になったという情報は、[nRFMicro Batteries](https://github.com/joric/nrfmicro/wiki/Batteries)が引用する設計者の発言。製造BOMを直接確認した事実とは区別する。公開図の75とこの記録を、どちらかが存在しないかのように扱わない。

TS52Kの充電設定はREADMEのUSB100、約100 mA設定、TS固定抵抗を引き継ぐ。ZMKが充電ICを制御する構成ではなく、これらは抵抗と配線で決まる。今回のビルド成功は充電条件の検証ではない。

## 水晶と温度条件

nice!nano公開図のFC-12M＋12 pF×2、現行ZMKのXTAL/50 ppmを基準に、TS52KはC96341＋C1547×2で決定・登録済み。nice!nano公開図だけから発注末尾まで特定したという意味ではなく、メーカー個別仕様で補完して選定した。

nRFMicroのC32346はCL=12.5 pFの別仕様で、今回の採用品ではない。選定済みC96341の代替として自動採用しない。

今回確認したnice!nano公式ドキュメント、公開回路、MDBTMicroのREADME/リリース、nRFMicroの部品資料からは、キーボード全体の保証動作温度や保証充電温度を確定できなかった。「世間相場は0〜50℃」とは結論しない。部品単体の温度定格を完成品の保証へ読み替えない。

独自の0〜50℃要件、50 ppmから100 ppm等への変更、広温度品や追加費用は採用しない。先行構成を基準に選んだ部品で回路図へ進み、実装後の起動・精度を確認する。

### 続報: 発注候補まで具体化できた部品

**LF水晶:** Epsonの[個別仕様書 X1A0000610008xx](https://download.epsondevice.com/td/pdf/td_xtal_32khz/FC-12M_X1A0000610008_en.pdf)を確認。32.768 kHz、CL=9 pF、25℃で±20 ppm、ESR最大90 kΩ、C0代表値1.3 pF、駆動レベル最大0.5 µW。末尾00は3000個リールなので、完全型番候補を **X1A000061000800** とする。小口手配の可否やPCBA用調達は別途確認する。

この選択は「nice!nanoで使われるFC-12Mというシリーズを、メーカーの9 pF仕様で補完した候補」であって、公開されていないnice!nanoの発注末尾を突き止めた結果ではない。個別資料でもC0は代表値なので、最大値保証まで確認したとはしない。

**2026-11-03調達番号の具体化:** [JLCPCB C96341](https://jlcpcb.com/partdetail/C96341)は **X1A0000610008** として登録され、32.768 kHz、CL=9 pF、±20 ppm、ESR=90 kΩ、SMD2012-2P、Extendedを確認。少量単価は$0.2497（1〜49個、実装費別）。Epsonの個別仕様書はX1A0000610008xxを対象とし、末尾2桁は梱包区分なので、従来候補の電気仕様を変えずにJLC番号まで具体化できた。PCBA用BOMにはC96341とJLC登録型番を記載する。在庫・必要数の引当ては発注時に確認する。メーカー仕様上の本体は2.05×1.2 mm、推奨ランドに従う。

**負荷コンデンサ:** 先行図の12 pF×2を初回実装候補とし、現行選定は **C1547、C0G、0402**。当初の0603案からBasic優先で変更済み。Nordicの[クロック回路説明](https://docs.nordicsemi.com/r/bundle/ps_nrf52840/page/clock.html)に従い、端子・PCB容量も含めた負荷を照合する。単純化した等価モデルでは同じ12 pFが2個で直列分6 pF、CL=9 pFとの差3 pFが寄生容量相当になる。ただし3 pFはモジュールで実測した値ではない。PCBではXL1/XL2を短く配置し、容量を交換できる2個のランドを確保する。固定容量での精度と起動は初回基板で確認する。

**REG0インダクタ:** メーカーの[仕様書 JELF243B-0086G-01](https://pim.murata.com/asset/pim4/inductor/JELF243B-0086_PDF_INDUCTOR)から **LQM18DN100M70L** を候補化。10 µH±20%、DCR=1.05±0.32 Ω、自己共振周波数32 MHz以上。電流定格にはインダクタンス変化基準100 mAと温度上昇基準300 mAの2種類があり、100 mA側の判定は初期値から±50%以内。販売店の「300 mA」だけで選定しない。

**2026-11-03選定完了:** 初版のREG0用には上記 **LQM18DN100M70L / C713281** を選ぶ。Raytac Version K p37の10 µH／0603／±20%／IDC 80 mA以上に対し、インダクタンス変化基準100 mA、温度上昇基準300 mAを確認。DCR上限は約1.37 Ω、自己共振周波数は32 MHz以上。[MurataのBLE電源向け説明](https://www.murata.com/products/inductor/power/overview/lineup/info/lqm)でもLQM18DN100M70は推奨シリーズとして挙がる。Raytacの推奨条件を基準に選定し、nice!nanoの非公開BOMと同一とは扱わない。

[JLCPCBのC713281](https://jlcpcb.com/partdetail/MurataElectronics-LQM18DN100M70L/C713281)で0603、Extended、少量単価$0.1052（1〜49個、実装費別）を確認。条件を満たす電源用インダクタを優先し、この1品種のExtendedを許容する。別の新着登録C9900027831は0805表記のため使用しない。DCCH（31）–VDD（28）を短く結び、メーカー推奨ランドに従う。部品選定を保留する項目には残さず、初回基板の起動・電源確認は実機検証として行う。

### REG0インダクタのBasic対案比較（2026-11-03）

外形の0603一致は絶対条件とせず、0805まで広げて比較した。JLCPCBのBasic一覧と個別ページで確認できた10 µH品は次の2品。分類・価格は個別ページで再確認し、メーカー仕様は[Sunlord SDFLシリーズ仕様書（2022/05/15版）](https://www.sunlordinc.com/uploads/files/20221118/SDFL%20Series%20of%20Multilayer%20Chip%20Ferrite%20Inductor-OK.pdf)で照合した。

| 比較項目 | 主案 Murata LQM18DN100M70L | Basic対案 Sunlord SDFL2012S100KTF | Basic参考 Sunlord SDFL1608S100KTF |
| --- | --- | --- | --- |
| JLC番号・分類 | [C713281](https://jlcpcb.com/partdetail/C713281)、Extended | [C1046](https://jlcpcb.com/partdetail/C1046)、Basic | [C1035](https://jlcpcb.com/partdetail/C1035)、Basic |
| 少量単価・実装費別 | $0.1052 | $0.0516 | $0.0279 |
| 公称L・許容差 | 10 µH ±20% | 10 µH ±10% | 10 µH ±10% |
| 本体L×W | 1.6×0.8 mm | 2.0×1.25 mm | 1.6×0.8 mm |
| DCR上限 | 約1.37 Ω | 1.15 Ω | 1.85 Ω |
| 自己共振周波数・最小 | 32 MHz | 24 MHz | 17 MHz |
| 電流定格 | L変化±50%基準100 mA、温度上昇基準300 mA | 15 mA | 3 mA |

**Basicの対案として比較に残すのはC1046。** 部品単価は約51%安くなり、Economic PCBAではこの品種のExtended段取り費も省ける。DCR上限は約16%低く、同じ電流波形なら巻線の抵抗損失も約16%減る。本体面積は約1.95倍。公称Lの許容差も狭くなり、ここは性能低下ではない。自己共振周波数は25%下がるが、これだけからREG0での損失増を定量化できない。

問題は直流重畳特性。C1046の電流定格15 mAはRaytac推奨80 mAの約19%で、推奨値は定格の約5.3倍に当たる。ただしSunlord資料はこの定格のL変化率・温度上昇の判定条件を明記しておらず、Murataの100 mAと単純に比べて「性能85%低下」とはしない。

Sunlord仕様書最終ページのSDFL2012シリーズの典型DC重畳グラフでは、10 µH品は約40〜50 mAの付近でLが低下し、50 mA付近では約8 µHに見える（小さい図の目読みによる概数、保証値ではない）。同じ印加電圧・通電時間なら8 µHでの電流増加速度は10 µHの約1.25倍になる。80 mAでのLはグラフに示されず、実際のREG0電流波形も未測定なので、効率が何%下がるか、起動やBLE送信がどこまで安定するかまでは算出できない。平均消費電流が15 mA以下というだけでは採用根拠にならない。

C1035はDCR上限が主案より約35%増え、定格3 mAはRaytac推奨値の約4%。C1046よりも電源用途の代替として不利なので推奨しない。

**判断:** C1046は安価なBasic対案として提示できるが、現資料だけでは「効率を少し犠牲にする置換」と評価できず、メーカー推奨条件外での動作検証が必要になる。初版の確実な起動と先行構成の優先を引き続き重視し、主案はC713281を維持する。サイズ・DCR・共振周波数の完全一致を要求した結果ではなく、電流特性の差を理由とする。

**決定:** 比較提示後、ユーザーが「じゃあExtendedでいいよ」と了承。REG0用はLQM18DN100M70L / C713281で確定し、C1046は比較記録としてのみ残す。LF水晶の調達型番も上表で選定済み。

現行UF2の両DC/DC・XTAL/50 ppmは維持する。これらの部品候補が見つかったことだけを理由に、実装精度や温度範囲まで検証済みとはしない。新たな回路方式や高精度発振器への変更は行っていない。

## 初回起動の機材とファームウェア

| 項目 | 候補／確認済み事項 | 未確認事項 |
| --- | --- | --- |
| SWD書き込み器 | 調査例: J-Link EDU Mini **V2**、USB-C版、8.08.91。1.8 V/3.3 V対応 | ユーザー判断により機種・購入時期は後で決める。部品選定を止めない |
| SWDケーブル | **TC2030-CTX-NL、Normal Orientation**。任意でTC2030-CLIP-3PACK | メーカー配線図と無線版予定の6ピンを照合済み。20ピン変換器不要。改版時にランド向きを照合 |
| 初回HEX | Adafruit 0.11.0 nice_nano用SoftDevice結合HEX | ソースの電圧・リセット初期化経路とファイル領域は確認済み。実機でUICR読戻し・USB認識が必要 |
| ZMK UF2 | TS52K最小構成、開始0x26000、両DC/DC、XTAL/50 ppm | 実機USB/BLE未検証 |

出典: [SEGGER V2仕様](https://kb.segger.com/J-Link_EDU_Mini_V2)、[Adafruit 0.11.0](https://github.com/adafruit/Adafruit_nRF52_Bootloader/releases/tag/0.11.0)。

機材一式、価格、利用条件、接続表は[SWD機材の選定記録](swd-equipment.md)。本体とSWDケーブルの参考額は$118.95、保持クリップを含め$136.95（税・送料別）。TS52KはUSBから給電し、VTrefはモジュールVDDを参照する。機材の実接続・書き込み・復旧の試験は未実施。

**初回SWDを省く調達対案:** [秋月117928](https://akizukidenshi.com/catalog/g/g117928/)はAdafruit nRF52 Bootloader書き込み済みのMDBT50Q-1MV2単体。標準品の工場テストコードとは別なので、ブートローダー書き込みのためにJ-Link購入が必須とはしない。版・ビルド対象・SoftDevice・電源初期化を現構成と照合できるまで、既存UF2がそのまま使えるとは断言しない。SWDランドは復旧用に保持する。具体的な残項目は上記機材ノートに記録した。

## 現在の工程と後日扱う事項

部品選定、GPIO18本の接続表、ランド照合、ライブラリ登録と無線版回路図の作成・検査まで完了した。[回路図の配置元と確認](wireless-schematic-layout.md)を参照。2026-11-10にはPCBも無線版へ移行し、U5西端移設後のGPIOと配線を反映済み。[現在の配置・配線記録](../pcb/placement-review/README.md)を参照。実機検証は未実施。SWD機材、モジュール購入先、電池製品の決定は後日とし、完了済みの部品選定へ戻さない。

2026-11-03更新: READMEと無線版回路図を現行構成へ同期。ERCエラー0・警告0、主要ネットと19品種81点を照合済み。旧RP2040子シートは除去した。旧PCBと製造出力は未移行。

## 電池の逆接続保護（Q1、2026-11-11）

ブランチ claude-fable-mosfet-2026-11-11 で追加。**Alpha & Omega AO3401A / C15127、Pチャネル、SOT-23、JLCPCB Basic、1個。**

| 条件 | 必要な値 | AO3401A（メーカー Rev 3.1、2023-12） |
| --- | --- | --- |
| ドレイン・ソース耐圧 | 逆接続時、USBなしで約4.2 V、USB給電中は定常で約5.6 V（電池4.2 V＋しきい値まで下がったBAT）、挿した瞬間は約8.4 V。配線のインダクタンスによる跳ね上がりは別（見積もりは配置記録） | −30 V |
| ゲート・ソース耐圧 | ゲートはGND固定なので、BATの最大電圧（定格5 V）がそのままかかる | ±12 V |
| しきい値 | BQ24072のBAT短絡検出しきい値（最小1.6 V）より十分低いこと。高いと、0 V付近まで放電した電池を充電し始められない | −0.5／−0.9／−1.3 V（最小／標準／最大、250 µA） |
| オン抵抗 | 電池が減った状態（VGS≈−3 V）で規定があること | 最大60 mΩ（−4.5 V）、85 mΩ（−2.5 V） |
| 漏れ | 電池からの常時消費を増やさないこと | ゲート最大±100 nA（±12 V）。オフ時ドレイン最大1 µA（−30 V、25℃） |
| ピン配置 | KiCadのSOT-23（1・2が同じ辺、3が反対の辺）と一致 | 1=G、2=S、3=D（メーカー図、およびEasyEDAのC15127部品データで確認） |

- JLCPCBの区分は、2026-11-11に[部品ページ](https://jlcpcb.com/partdetail/C15127)の埋め込みデータで `componentLibraryType: base`（Basic）を確認。LCSCの在庫表示は同日約114万個。
- Basic対案のSI2301CDS / C10487（−20 V、VGS ±8 V、142 mΩ@−2.5 V）は、ゲート耐圧とオン抵抗の余裕がAO3401Aより小さいので採らなかった。値はLCSCの掲載値で、メーカー資料との照合はしていない。
- SOT-23より小さいPチャネル品は、検索した範囲でBasicがなく、Extendedも在庫の薄いものが多かった。SOT-23を置くために周辺配線を局所的に動かす方を選んだ（`pcb/placement-review/README.md`）。
- 抵抗・ツェナーなどの付加部品はない。ゲートをGNDへ直結するので、電池からの常時電流はゲート漏れだけ。
