sadaoikebe/ts52k/case/ts52k-knob2.step

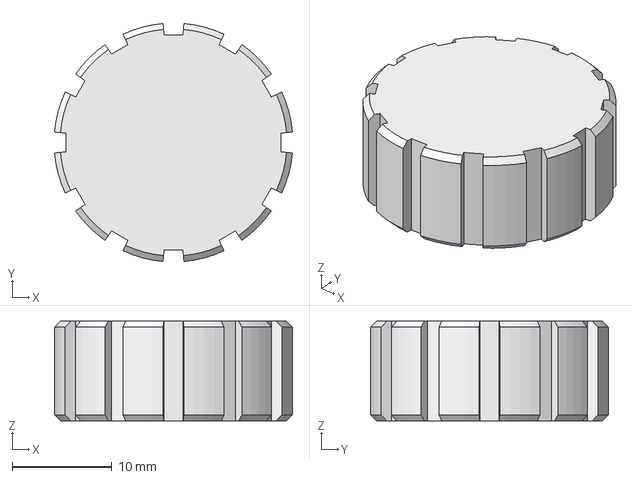
[picture p18: CAD file, 2026-05-09]
case/ts52k-knob2.step
23.9 x 23.9 x 10.0 mm
Sketch004
