sadaoikebe/ts52k/case/ts52k-case-Brim-Lid.step

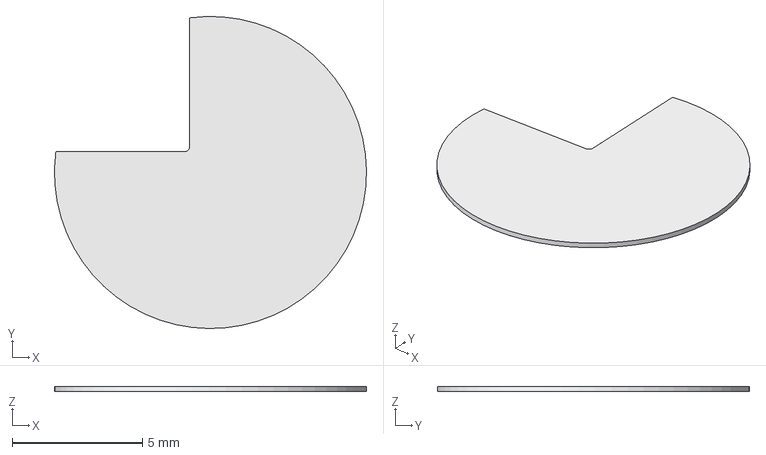
[picture p19: CAD file, 2026-05-09]
case/ts52k-case-Brim-Lid.step
12.0 x 12.0 x 0.2 mm
