sadaoikebe/ts52k/case/ts52k-case-Lid.step

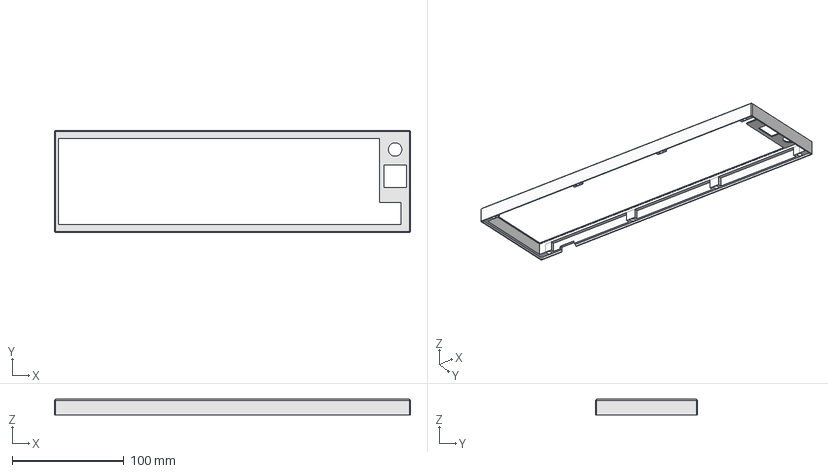
[picture p20: CAD file, 2026-05-09]
case/ts52k-case-Lid.step
318.0 x 91.0 x 14.0 mm
