sadaoikebe/ts52k/case/ts52k-knob-Body.step

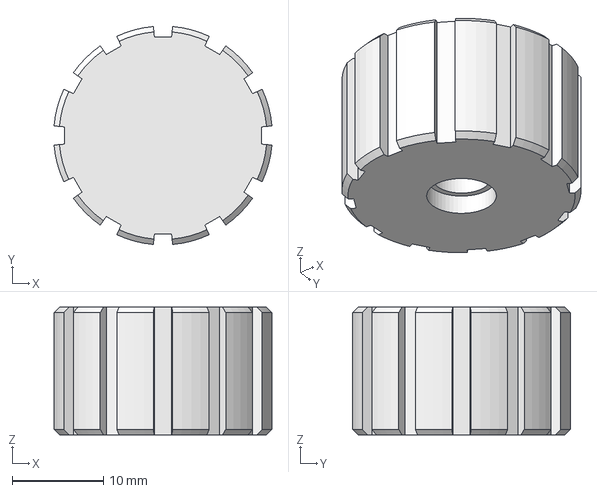
[picture p21: CAD file, 2026-05-09]
case/ts52k-knob-Body.step
23.9 x 23.9 x 14.0 mm
