sadaoikebe/ts52k/case/ts52k-case-Base.3mf

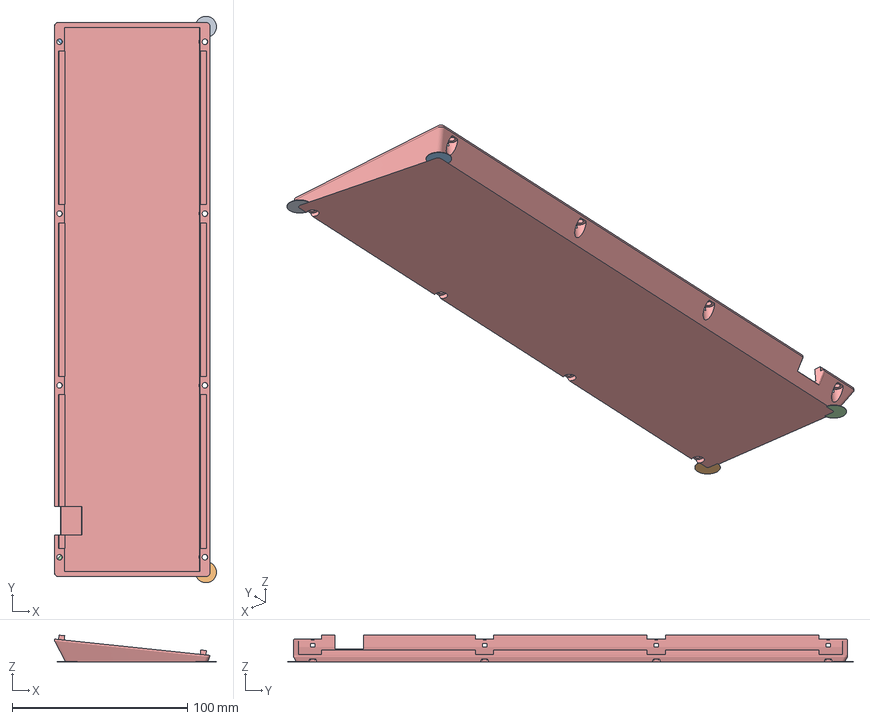
[picture p22: CAD file, 2026-05-09]
case/ts52k-case-Base.3mf
92.4 x 323.1 x 15.3 mm
ts52k-case-Brim-Base1 x 2
ts52k-case-Brim-Base2 x 2
ts52k-case-Base
