sadaoikebe/ts52k/case/ts52k-knob2-Body.step

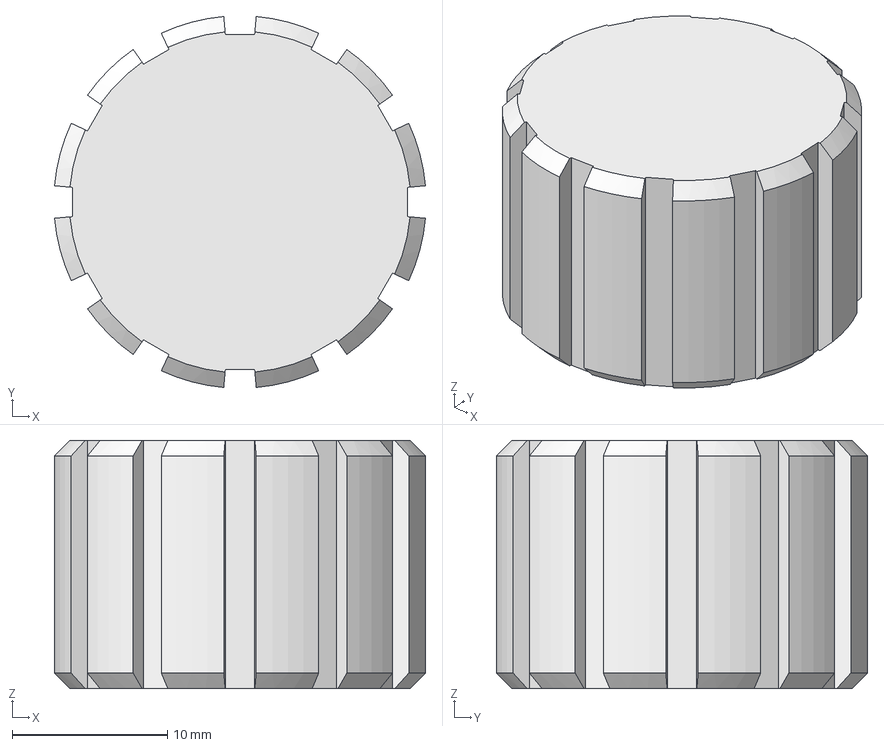
[picture p23: CAD file, 2026-05-09]
case/ts52k-knob2-Body.step
23.9 x 23.9 x 16.0 mm
