sadaoikebe/ts52k/case/ts52k-plate-2u-lthumb.FCStd

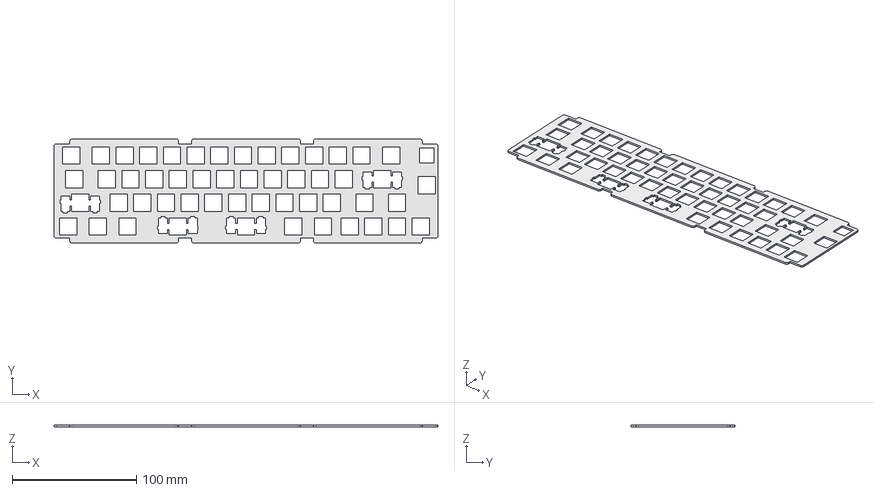
[picture p24: CAD file, 2026-02-23]
case/ts52k-plate-2u-lthumb.FCStd
308.8 x 84.0 x 1.50 mm
