sadaoikebe/ts52k/case/ts52k-plate-Body.dxf

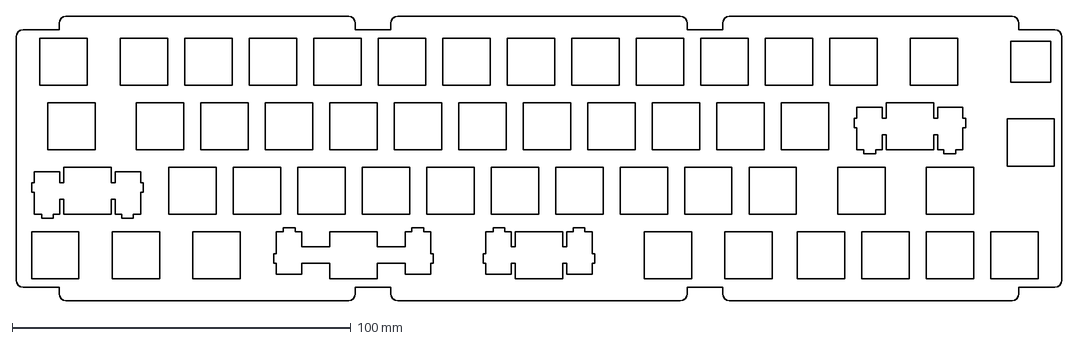
[picture p25: CAD file, 2023-10-20]
case/ts52k-plate-Body.dxf
308.8 x 83.9 mm
