sadaoikebe/ts52k/(list of files, cad)

Other CAD files:
case/ts52k-knob.FCStd
case/ts52k-case.FCStd
case/ts52k-plate.FCStd
case/ts52k-case-Lid.3mf
case/ts52k-knob2.FCStd
