sadaoikebe/ts52k/pcb/schematic-review/ts52k-wireless.pdf

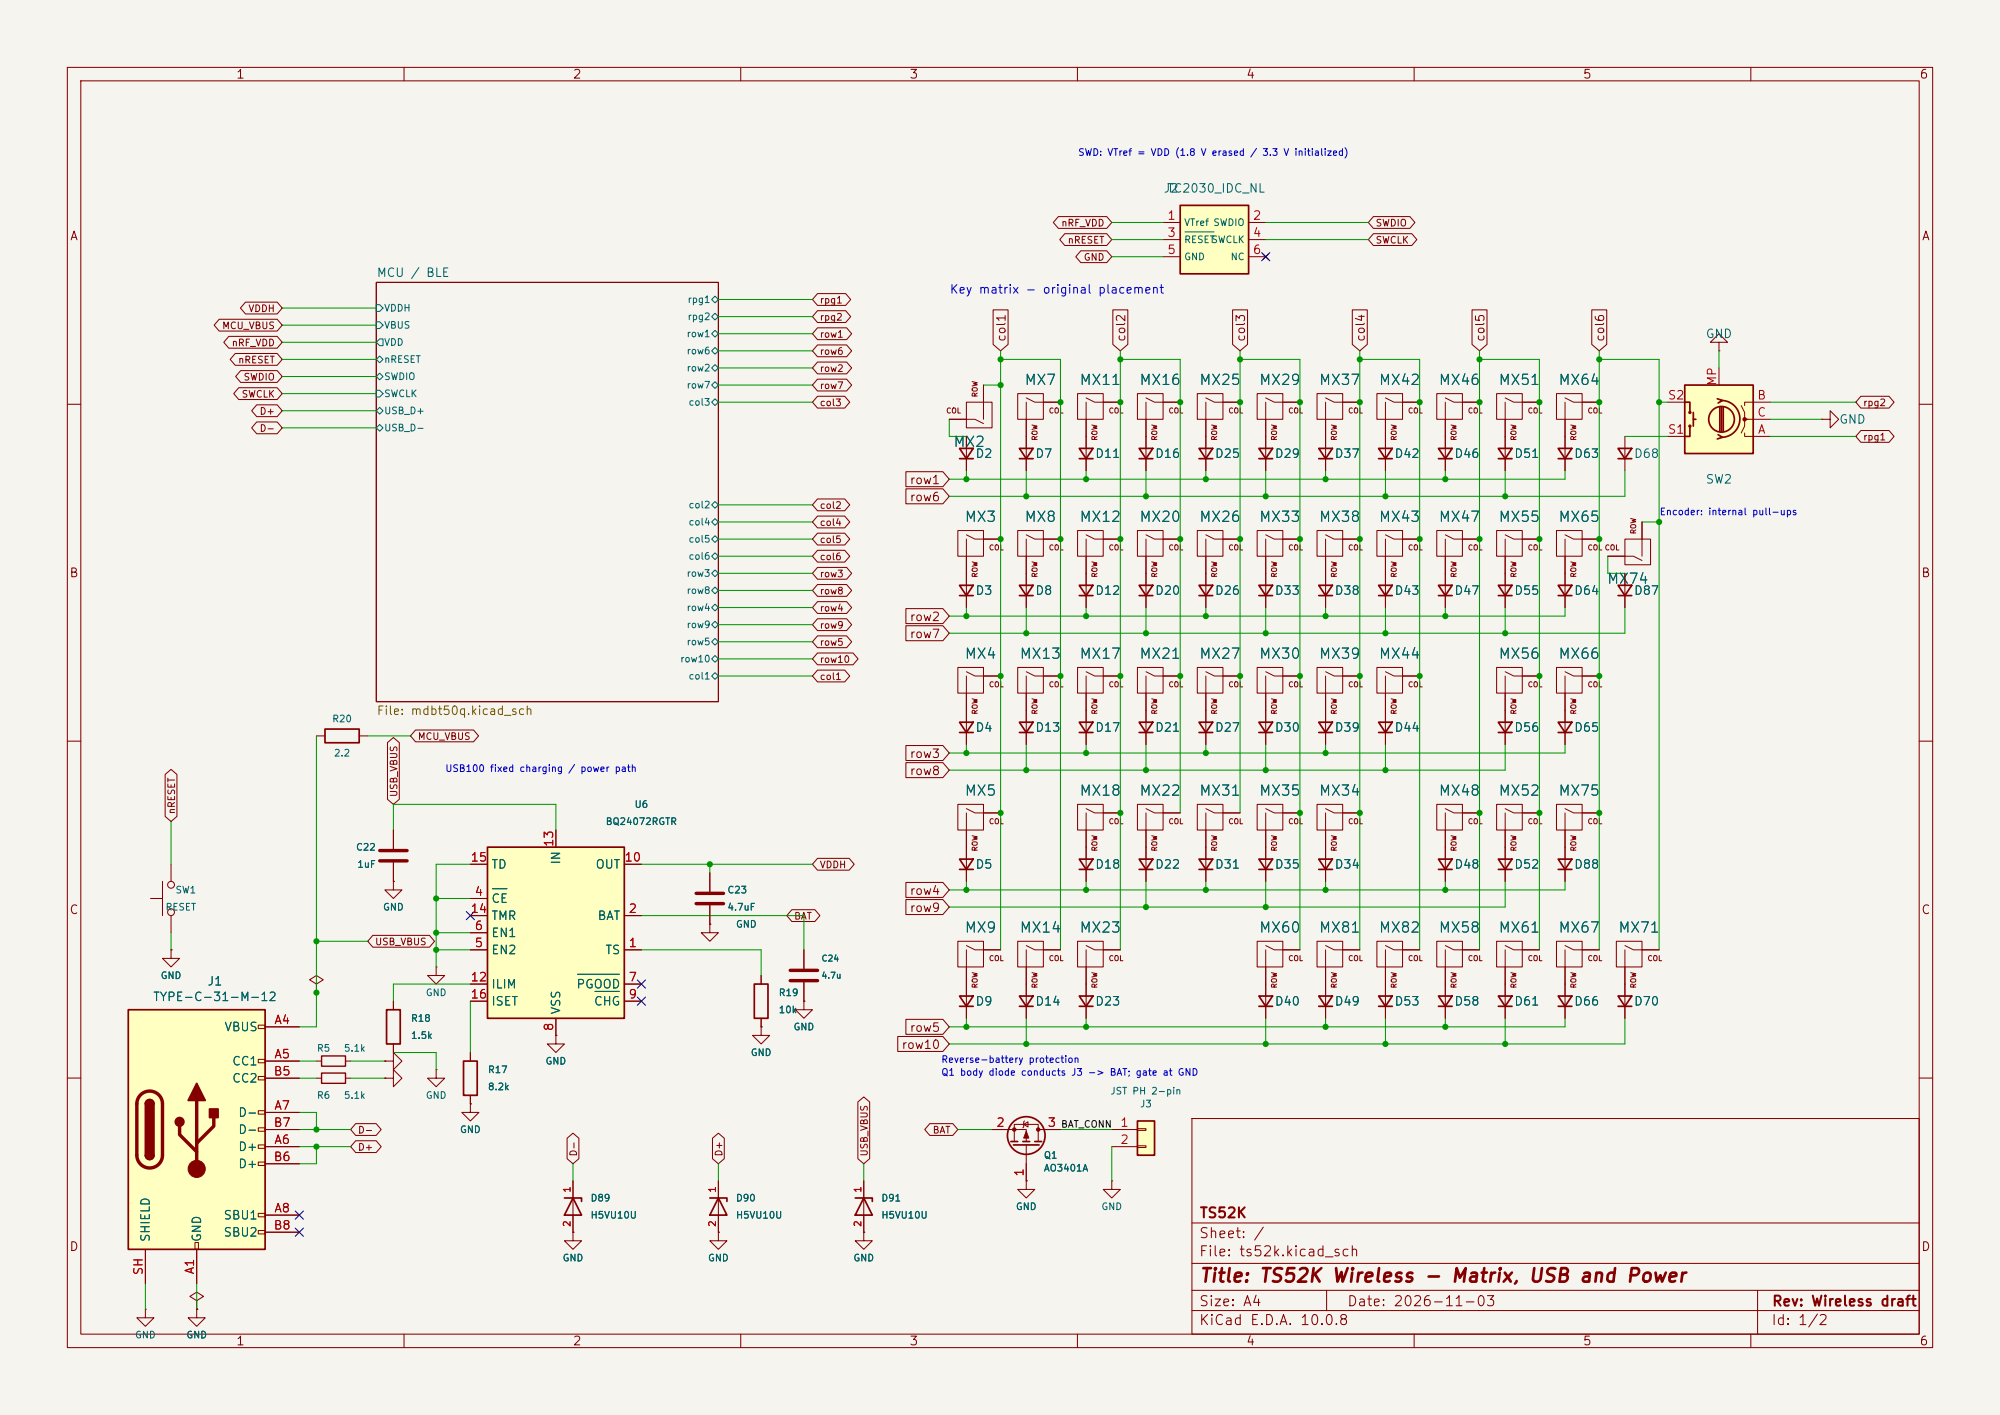
[picture p26: page 1]

SWD: VTref = VDD (1.8 V erased / 3.3 V initialized)
J2TC2030_IDC_NL ROW

Sheet: /
File: ts52k.kicad_sch
Title: TS52K Wireless - Matrix, USB and Power

Size: A4 | Rev: Wireless draft
KiCad E.D.A. 10.0.8 | Id: 1/2

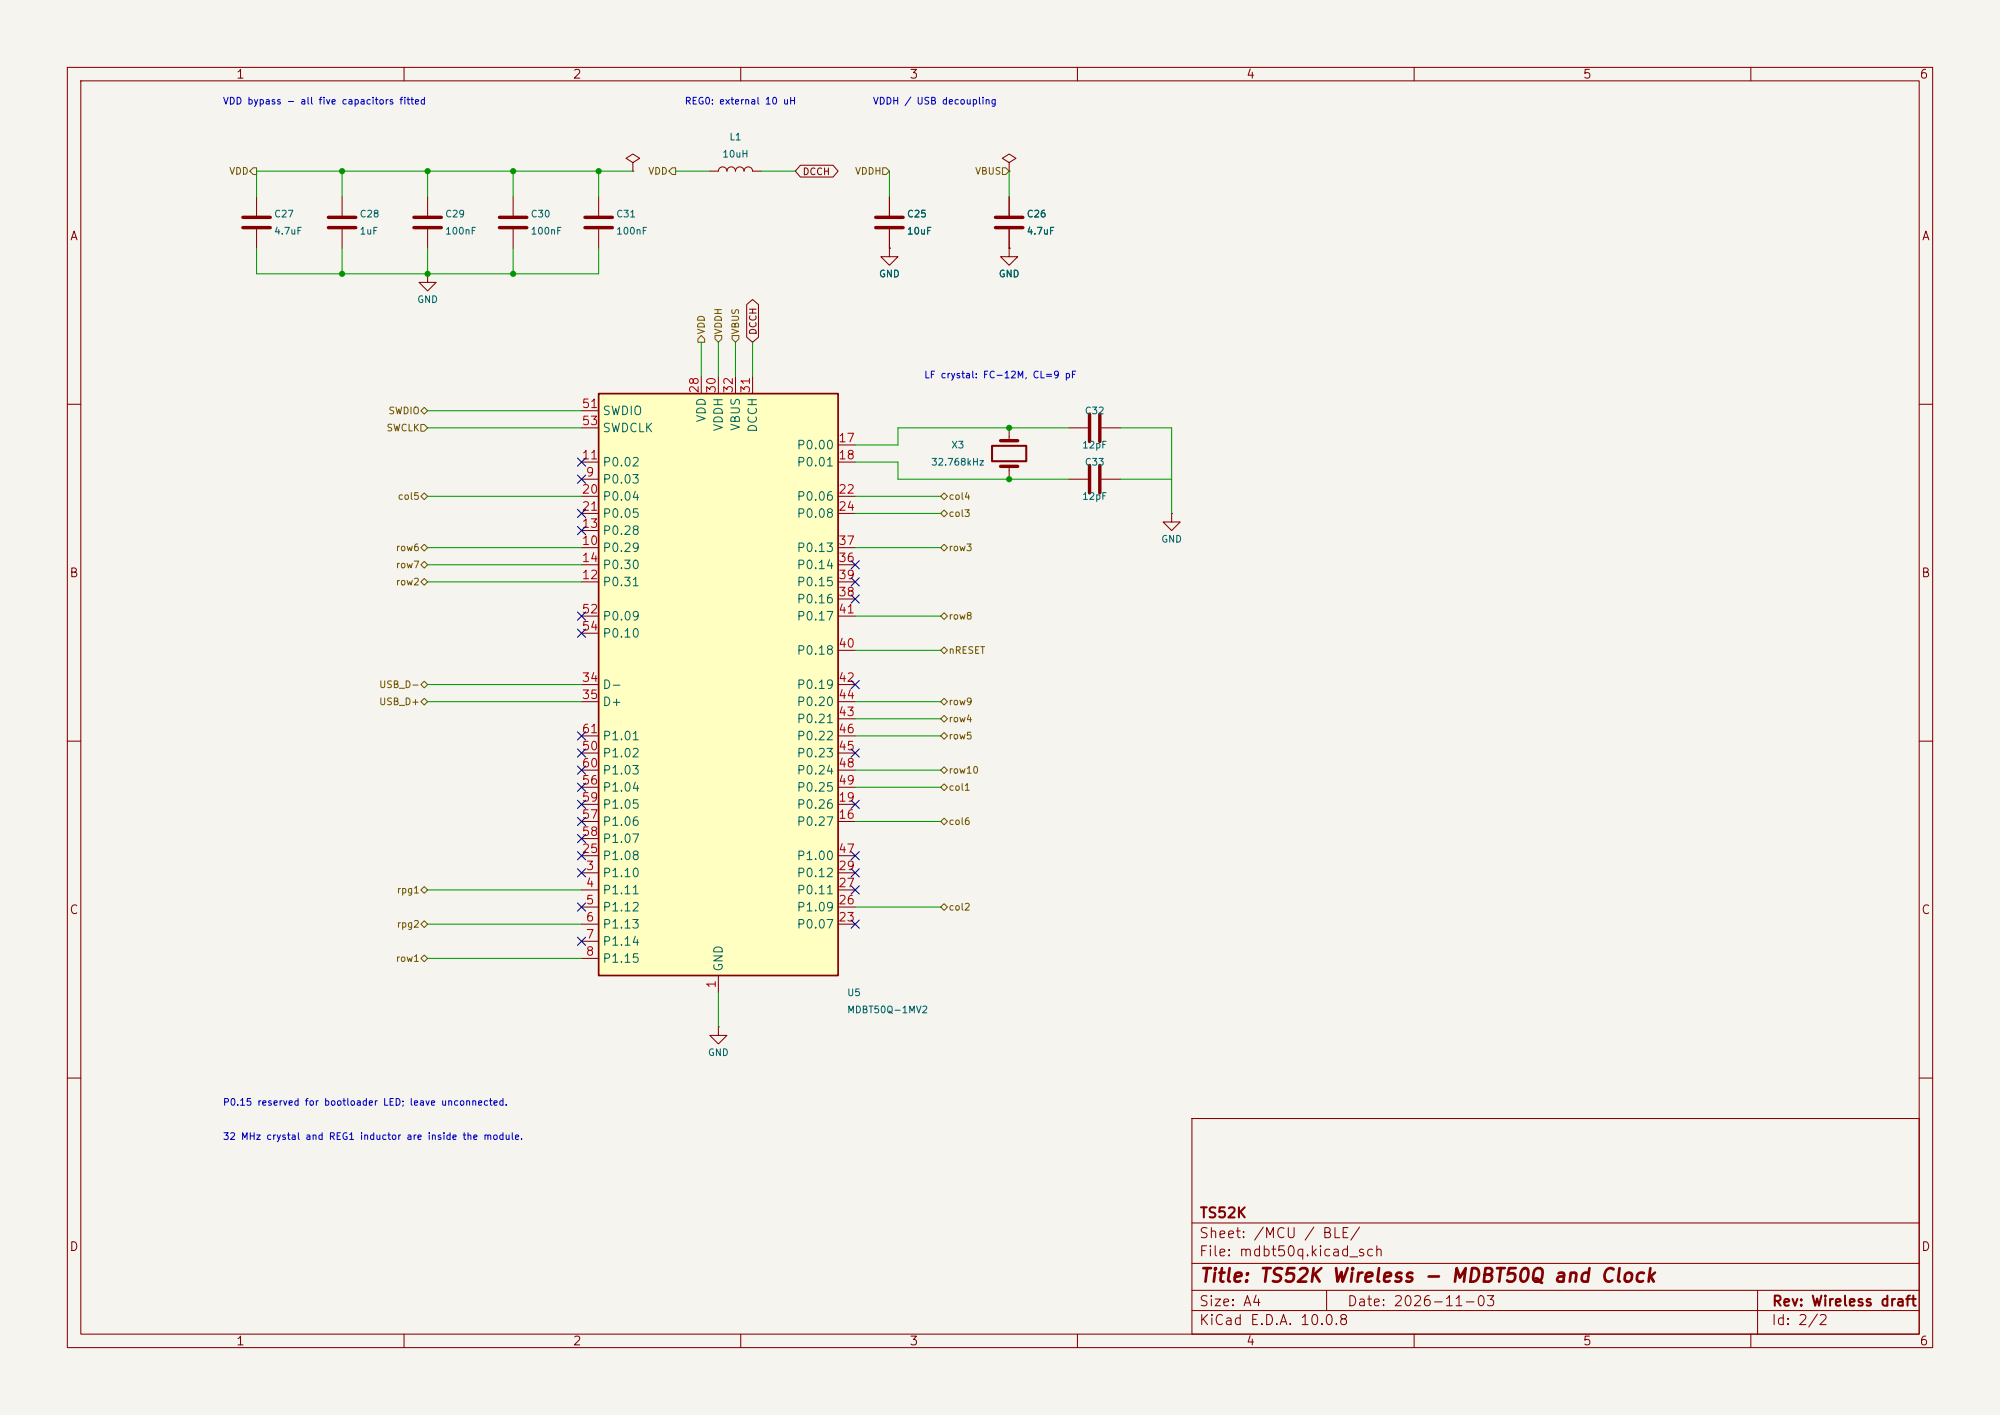
[picture p27: page 2]

LF crystal: FC-12M, CL=9 pF

1 P1.10 3 P1.11 4 P1.12 5 P1.13 6 P1.14 7 P1.15 8 P0.03 9 P0.29 10 P0.02 11 P0.31 12 P0.28 13 P0.30 14 P0.27 16 P0.00 17 P0.01 18 P0.26 19 P0.04 20 P0.05 21 P0.06 22 P0.07 23 P0.08 24 P1.08 25 P1.09 26 P0.11 27 VDD 28 P0.12 29 VDDH 30 DCCH 31 VBUS 32 D- 34 D+ 35 P0.14 36 P0.13 37 P0.16 38 P0.15 39 P0.18 40 P0.17 41 P0.19 42 P0.21 43 P0.20 44 P0.23 45 P0.22 46 P1.00 47 P0.24 48 P0.25 49 P1.02 50

P0.15 reserved for bootloader LED; leave unconnected.

32 MHz crystal and REG1 inductor are inside the module.

Sheet: /MCU / BLE/
File: mdbt50q.kicad_sch
Title: TS52K Wireless - MDBT50Q and Clock

Size: A4 | Rev: Wireless draft
KiCad E.D.A. 10.0.8 | Id: 2/2
