sadaoikebe/ts52k/(list of files, drawings)

Other design files:
notes/rotation-audit-2026-11-11/fetch-easyeda-log.json
