sadaoikebe/ts52k/pcb/ts52k.kicad_pcb

## KiCad design pcb/ts52k.kicad_pcb (2026-11-13)

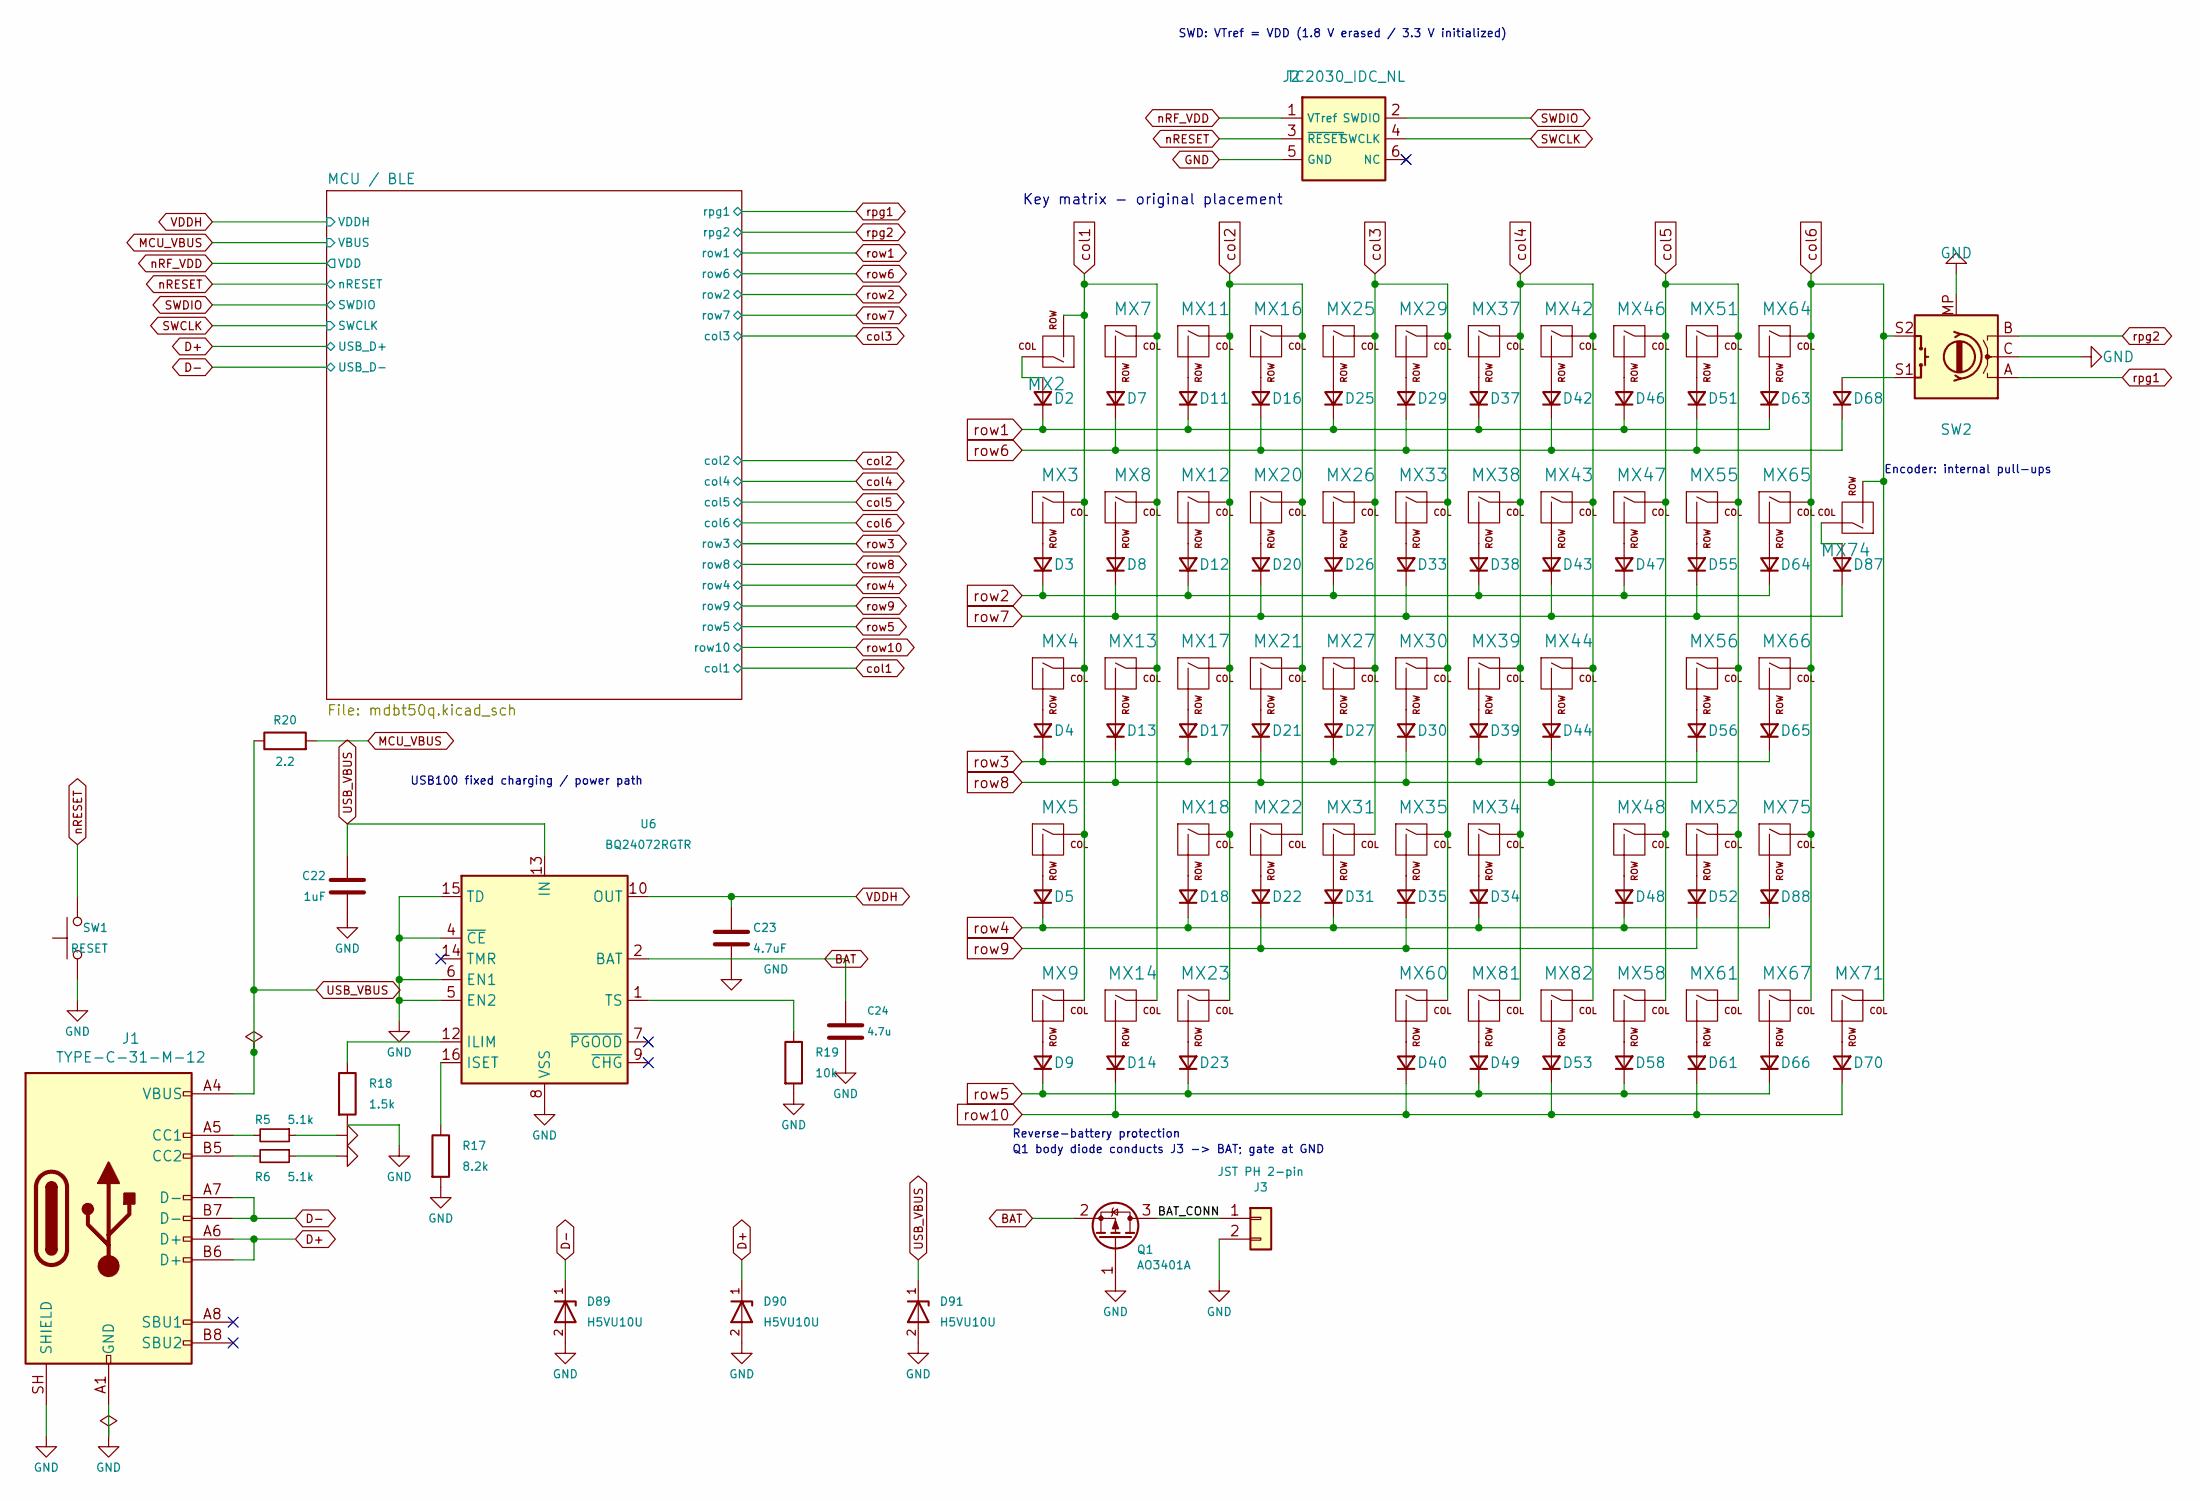
[picture p28: schematic ts52k.kicad_sch, TS52K Wireless - Matrix, USB and Power]

Parts:
C22: 1uF; C_0603_1608Metric; MPN CL10A105KB8NNNC; LCSC C15849
C23: 4.7uF; C_0603_1608Metric; MPN CL10A475KO8NNNC; LCSC C19666
C24: 4.7u; C_0603_1608Metric; MPN CL10A475KO8NNNC; LCSC C19666
D2, D3, D4, D5, D7, D8, D9, D11, D12, D13, D14, D16, D17, D18, D20, D21, D22, D23, D25, D26, D27, D29, D30, D31, D33, D34, D35, D37, D38, D39, D40, D42, D43, D44, D46, D47, D48, D49, D51, D52, D53, D55, D56, D58, D61, D63, D64, D65, D66, D68, D70, D87, D88: 1N4148W; D_SOD-123; MPN 1N4148W; LCSC C81598
D89, D90, D91: H5VU10U; H5VU10U_DFN1006-2L; MPN H5VU10U; LCSC C22395519
J1: TYPE-C-31-M-12; USB_C_Receptacle_HRO_TYPE-C-31-M-12; MPN TYPE-C-31-M-12; LCSC C165948
J2: TC2030_IDC_NL; Tag-Connect_TC2030-IDC-NL_2x03_P1.27mm_Vertical
J3: JST PH 2-pin; JST_PH_S2B-PH-SM4-TB_1x02-1MP_P2.00mm_Horizontal; MPN S2B-PH-SM4-TB(LF)(SN); LCSC C295747
MX2, MX64: MX-NoLED; MXOnly-1.5U-NoLED
MX3, MX75: MX-NoLED; MXOnly-1.75U-NoLED
MX4, MX65: MX-NoLED; MXOnly-2.25U-NoLED
MX5, MX9, MX14, MX81, MX82: MX-NoLED; MXOnly-1.25U-NoLED
MX7, MX8, MX11, MX12, MX13, MX16, MX17, MX18, MX20, MX21, MX22, MX25, MX26, MX27, MX29, MX30, MX31, MX33, MX34, MX35, MX37, MX38, MX39, MX42, MX43, MX44, MX46, MX47, MX48, MX51, MX52, MX55, MX56, MX58, MX61, MX66, MX67, MX71, MX74: MX-NoLED; MXOnly-1U-NoLED
MX23: MX-NoLED; MXOnly-3U-ReversedStabilizers-NoLED
MX60: MX-NoLED; MXOnly-2.75U-ReversedStabilizers-NoLED
Q1: AO3401A; SOT-23; MPN AO3401A; LCSC C15127
R5, R6: 5.1k; R_0603_1608Metric; MPN 0603WAF5101T5E; LCSC C23186
R17: 8.2k; R_0603_1608Metric; MPN 0603WAF8201T5E; LCSC C25981
R18: 1.5k; R_0603_1608Metric; MPN 0603WAF1501T5E; LCSC C22843
R19: 10k; R_0603_1608Metric; MPN 0603WAF1002T5E; LCSC C25804
R20: 2.2; R_0603_1608Metric; MPN 0603WAF220KT5E; LCSC C22939
SW1: RESET; SW_Tactile_XKB_TS-1187A_5.1x5.1mm; MPN TS-1187A-B-A-B; LCSC C318884
SW2: RotaryEncoder_Switch; RotaryEncoder_Alps_EC11E-Switch_Vertical_H20mm
U6: BQ24072RGTR; VQFN-16-1EP_3x3mm_P0.5mm_EP1.68x1.68mm; MPN BQ24072RGTR; LCSC C140288

Connections:
/BAT_CONN: J3.1, Q1.3 (D)
BAT: C24.1, Q1.2 (S), U6.2 (BAT), U6.3 (BAT)
D+: D90.1 (IO), J1.A6 (D+), J1.B6 (D+); also elsewhere on the board
D-: D89.1 (IO), J1.A7 (D-), J1.B7 (D-); also elsewhere on the board
GND: C22.2, C23.2, C24.2, D89.2 (GND), D90.2 (GND), D91.2 (GND), J1.A1 (GND), J1.A12 (GND), J1.B1 (GND), J1.B12 (GND), J1.SH (SHIELD), J2.5 (GND), J3.2, Q1.1 (G), R5.1, R6.1, R17.2, R18.2, R19.2, SW1.1, SW2.C, SW2.MP, U6.4 (~CE), U6.5 (EN2), U6.6 (EN1), U6.8 (VSS), U6.15 (TD), U6.17 (VSS); also elsewhere on the board
MCU_VBUS: R20.2; also elsewhere on the board
unnamed: D2.2 (A), MX2.1 (COL)
unnamed: D3.2 (A), MX3.2 (ROW)
unnamed: D4.2 (A), MX4.2 (ROW)
unnamed: D5.2 (A), MX5.2 (ROW)
unnamed: D7.2 (A), MX7.2 (ROW)
unnamed: D8.2 (A), MX8.2 (ROW)
unnamed: D9.2 (A), MX9.2 (ROW)
unnamed: D11.2 (A), MX11.2 (ROW)
unnamed: D12.2 (A), MX12.2 (ROW)
unnamed: D13.2 (A), MX13.2 (ROW)
unnamed: D14.2 (A), MX14.2 (ROW)
unnamed: D16.2 (A), MX16.2 (ROW)
unnamed: D17.2 (A), MX17.2 (ROW)
unnamed: D18.2 (A), MX18.2 (ROW)
unnamed: D20.2 (A), MX20.2 (ROW)
unnamed: D21.2 (A), MX21.2 (ROW)
unnamed: D22.2 (A), MX22.2 (ROW)
unnamed: D23.2 (A), MX23.2 (ROW)
unnamed: D25.2 (A), MX25.2 (ROW)
unnamed: D26.2 (A), MX26.2 (ROW)
unnamed: D27.2 (A), MX27.2 (ROW)
unnamed: D29.2 (A), MX29.2 (ROW)
unnamed: D30.2 (A), MX30.2 (ROW)
unnamed: D31.2 (A), MX31.2 (ROW)
unnamed: D33.2 (A), MX33.2 (ROW)
unnamed: D34.2 (A), MX34.2 (ROW)
unnamed: D35.2 (A), MX35.2 (ROW)
unnamed: D37.2 (A), MX37.2 (ROW)
unnamed: D38.2 (A), MX38.2 (ROW)
unnamed: D39.2 (A), MX39.2 (ROW)
unnamed: D40.2 (A), MX60.2 (ROW)
unnamed: D42.2 (A), MX42.2 (ROW)
unnamed: D43.2 (A), MX43.2 (ROW)
unnamed: D44.2 (A), MX44.2 (ROW)
unnamed: D46.2 (A), MX46.2 (ROW)
unnamed: D47.2 (A), MX47.2 (ROW)
unnamed: D48.2 (A), MX48.2 (ROW)
unnamed: D49.2 (A), MX81.2 (ROW)
unnamed: D51.2 (A), MX51.2 (ROW)
unnamed: D52.2 (A), MX52.2 (ROW)
unnamed: D53.2 (A), MX82.2 (ROW)
unnamed: D55.2 (A), MX55.2 (ROW)
unnamed: D56.2 (A), MX56.2 (ROW)
unnamed: D58.2 (A), MX58.2 (ROW)
unnamed: D61.2 (A), MX61.2 (ROW)
unnamed: D63.2 (A), MX64.2 (ROW)
unnamed: D64.2 (A), MX65.2 (ROW)
unnamed: D65.2 (A), MX66.2 (ROW)
unnamed: D66.2 (A), MX67.2 (ROW)
unnamed: D68.2 (A), SW2.S1
unnamed: D70.2 (A), MX71.2 (ROW)
unnamed: D87.2 (A), MX74.1 (COL)
unnamed: D88.2 (A), MX75.2 (ROW)
unnamed: J1.A5 (CC1), R5.2
unnamed: J1.B5 (CC2), R6.2
unnamed: R18.1, U6.12 (ILIM)
unnamed: R17.1, U6.16 (ISET)
unnamed: R19.1, U6.1 (TS)
SWCLK: J2.4 (SWCLK); also elsewhere on the board
SWDIO: J2.2 (SWDIO); also elsewhere on the board
USB_VBUS: C22.1, D91.1 (IO), J1.A4 (VBUS), J1.A9 (VBUS), J1.B4 (VBUS), J1.B9 (VBUS), R20.1, U6.13 (IN)
VDDH: C23.1, U6.10 (OUT), U6.11 (OUT); also elsewhere on the board
col1: MX2.2 (ROW), MX3.1 (COL), MX4.1 (COL), MX5.1 (COL), MX7.1 (COL), MX8.1 (COL), MX9.1 (COL), MX13.1 (COL), MX14.1 (COL); also elsewhere on the board
col2: MX11.1 (COL), MX12.1 (COL), MX16.1 (COL), MX17.1 (COL), MX18.1 (COL), MX20.1 (COL), MX21.1 (COL), MX22.1 (COL), MX23.1 (COL); also elsewhere on the board
col3: MX25.1 (COL), MX26.1 (COL), MX27.1 (COL), MX29.1 (COL), MX30.1 (COL), MX31.1 (COL), MX33.1 (COL), MX35.1 (COL), MX60.1 (COL); also elsewhere on the board
col4: MX34.1 (COL), MX37.1 (COL), MX38.1 (COL), MX39.1 (COL), MX42.1 (COL), MX43.1 (COL), MX44.1 (COL), MX81.1 (COL), MX82.1 (COL); also elsewhere on the board
col5: MX46.1 (COL), MX47.1 (COL), MX48.1 (COL), MX51.1 (COL), MX52.1 (COL), MX55.1 (COL), MX56.1 (COL), MX58.1 (COL), MX61.1 (COL); also elsewhere on the board
col6: MX64.1 (COL), MX65.1 (COL), MX66.1 (COL), MX67.1 (COL), MX71.1 (COL), MX74.2 (ROW), MX75.1 (COL), SW2.S2; also elsewhere on the board
nRESET: J2.3 (~RESET), SW1.2; also elsewhere on the board
nRF_VDD: J2.1 (VTref); also elsewhere on the board
row1: D2.1 (K), D11.1 (K), D25.1 (K), D37.1 (K), D46.1 (K), D63.1 (K); also elsewhere on the board
row2: D3.1 (K), D12.1 (K), D26.1 (K), D38.1 (K), D47.1 (K), D64.1 (K); also elsewhere on the board
row3: D4.1 (K), D17.1 (K), D27.1 (K), D39.1 (K), D65.1 (K); also elsewhere on the board
row4: D5.1 (K), D18.1 (K), D31.1 (K), D34.1 (K), D48.1 (K), D88.1 (K); also elsewhere on the board
row5: D9.1 (K), D23.1 (K), D49.1 (K), D58.1 (K), D66.1 (K); also elsewhere on the board
row6: D7.1 (K), D16.1 (K), D29.1 (K), D42.1 (K), D51.1 (K), D68.1 (K); also elsewhere on the board
row7: D8.1 (K), D20.1 (K), D33.1 (K), D43.1 (K), D55.1 (K), D87.1 (K); also elsewhere on the board
row8: D13.1 (K), D21.1 (K), D30.1 (K), D44.1 (K), D56.1 (K); also elsewhere on the board
row9: D22.1 (K), D35.1 (K), D52.1 (K); also elsewhere on the board
row10: D14.1 (K), D40.1 (K), D53.1 (K), D61.1 (K), D70.1 (K); also elsewhere on the board
rpg1: SW2.A; also elsewhere on the board
rpg2: SW2.B; also elsewhere on the board

Notes on the sheet:
SWD: VTref = VDD (1.8 V erased / 3.3 V initialized)
Reverse-battery protection
Q1 body diode conducts J3 -> BAT; gate at GND
USB100 fixed charging / power path
Key matrix - original placement
Encoder: internal pull-ups

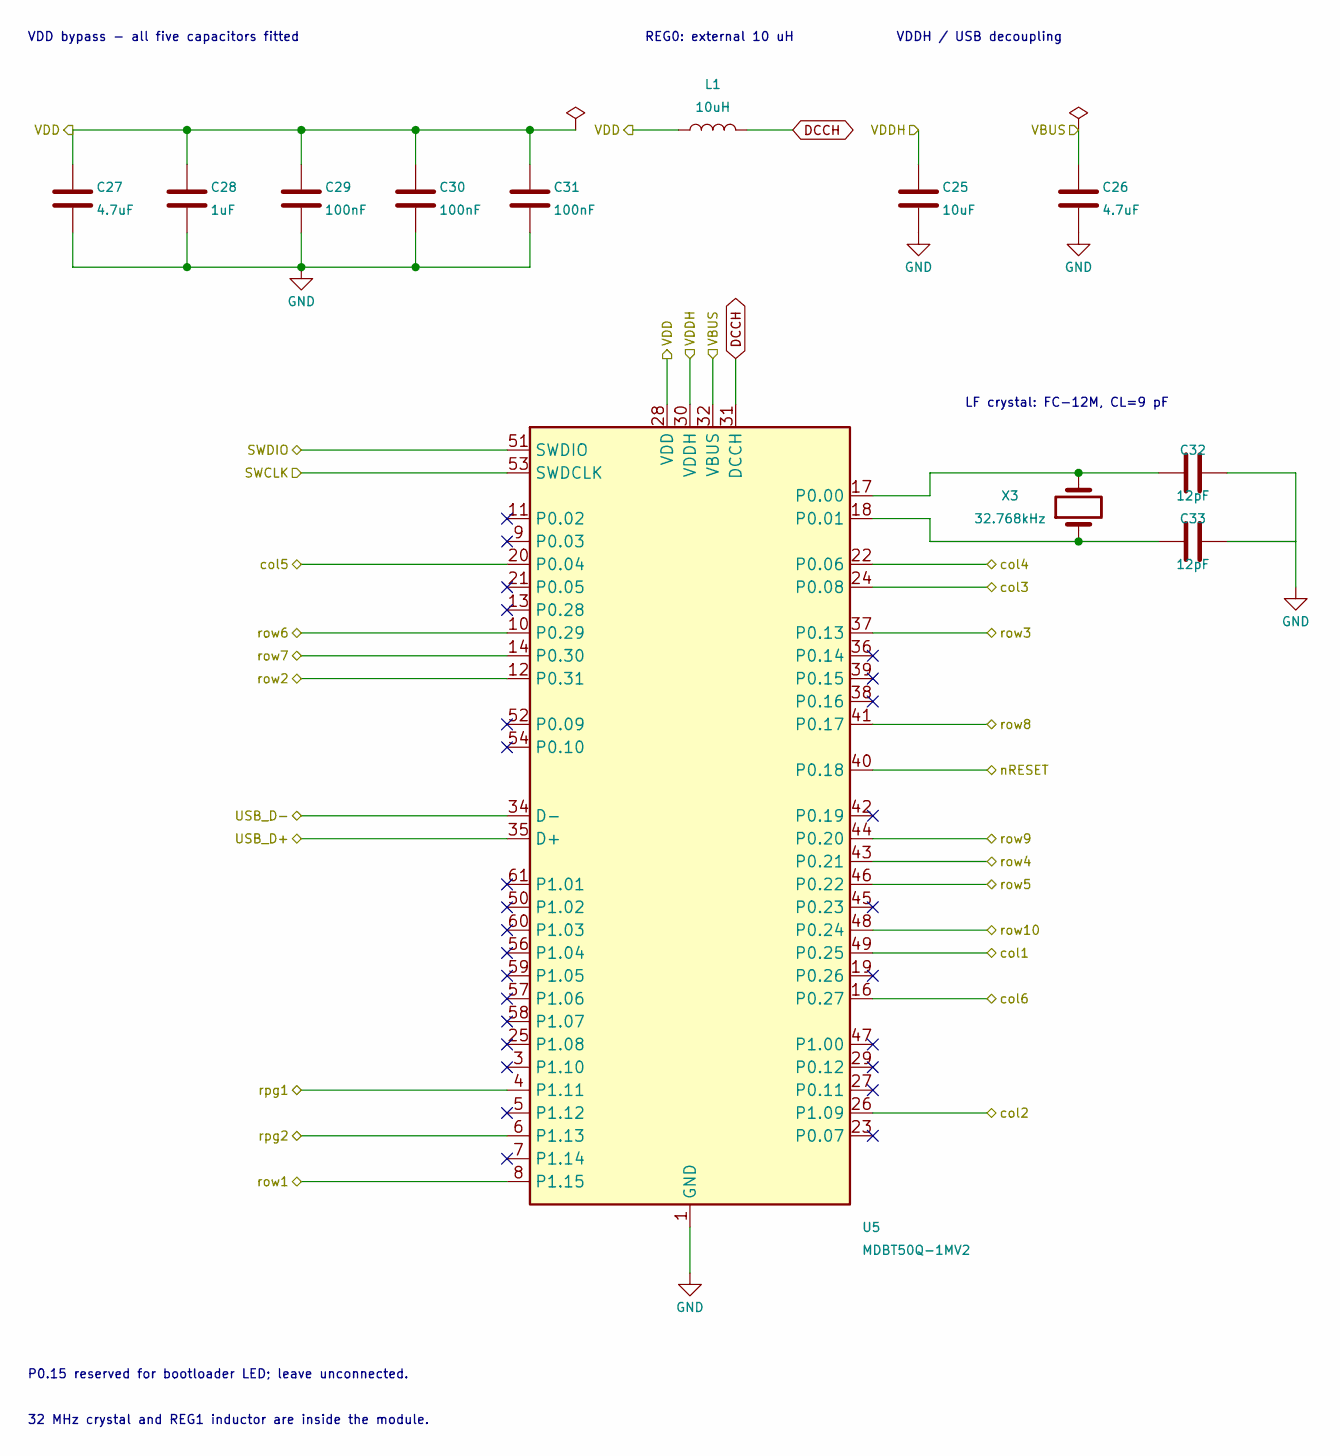
[picture p29: schematic mdbt50q.kicad_sch, TS52K Wireless - MDBT50Q and Clock]

Parts:
C25: 10uF; C_0805_2012Metric; MPN CL21A106KAYNNNE; LCSC C15850
C26, C27: 4.7uF; C_0603_1608Metric; MPN CL10A475KO8NNNC; LCSC C19666
C28: 1uF; C_0603_1608Metric; MPN CL10A105KB8NNNC; LCSC C15849
C29, C30, C31: 100nF; C_0603_1608Metric; MPN CC0603KRX7R9BB104; LCSC C14663
C32, C33: 12pF; C_0402_1005Metric; MPN 0402CG120J500NT; LCSC C1547
L1: 10uH; L_0603_1608Metric; MPN LQM18DN100M70L; LCSC C713281
U5: MDBT50Q-1MV2; Raytac_MDBT50Q; MPN MDBT50Q-1MV2; LCSC C5118826
X3: 32.768kHz; Crystal_Epson_FC-12M_2.05x1.2mm; MPN X1A0000610008; LCSC C96341

Connections:
D+: U5.35 (D+); also elsewhere on the board
D-: U5.34 (D-); also elsewhere on the board
DCCH: L1.2, U5.31 (DCCH)
GND: C25.2, C26.2, C27.2, C28.2, C29.2, C30.2, C31.2, C32.2, C33.2, U5.1 (GND), U5.2 (GND), U5.15 (GND), U5.33 (GND), U5.55 (GND); also elsewhere on the board
MCU_VBUS: C26.1, U5.32 (VBUS); also elsewhere on the board
unnamed: C32.1, U5.17 (P0.00), X3.2
unnamed: C33.1, U5.18 (P0.01), X3.1
SWCLK: U5.53 (SWDCLK); also elsewhere on the board
SWDIO: U5.51 (SWDIO); also elsewhere on the board
VDDH: C25.1, U5.30 (VDDH); also elsewhere on the board
col1: U5.49 (P0.25); also elsewhere on the board
col2: U5.26 (P1.09); also elsewhere on the board
col3: U5.24 (P0.08); also elsewhere on the board
col4: U5.22 (P0.06); also elsewhere on the board
col5: U5.20 (P0.04); also elsewhere on the board
col6: U5.16 (P0.27); also elsewhere on the board
nRESET: U5.40 (P0.18); also elsewhere on the board
nRF_VDD: C27.1, C28.1, C29.1, C30.1, C31.1, L1.1, U5.28 (VDD); also elsewhere on the board
row1: U5.8 (P1.15); also elsewhere on the board
row2: U5.12 (P0.31); also elsewhere on the board
row3: U5.37 (P0.13); also elsewhere on the board
row4: U5.43 (P0.21); also elsewhere on the board
row5: U5.46 (P0.22); also elsewhere on the board
row6: U5.10 (P0.29); also elsewhere on the board
row7: U5.14 (P0.30); also elsewhere on the board
row8: U5.41 (P0.17); also elsewhere on the board
row9: U5.44 (P0.20); also elsewhere on the board
row10: U5.48 (P0.24); also elsewhere on the board
rpg1: U5.4 (P1.11); also elsewhere on the board
rpg2: U5.6 (P1.13); also elsewhere on the board

Notes on the sheet:
VDD bypass - all five capacitors fitted
VDDH / USB decoupling
P0.15 reserved for bootloader LED; leave unconnected.
LF crystal: FC-12M, CL=9 pF
REG0: external 10 uH
32 MHz crystal and REG1 inductor are inside the module.

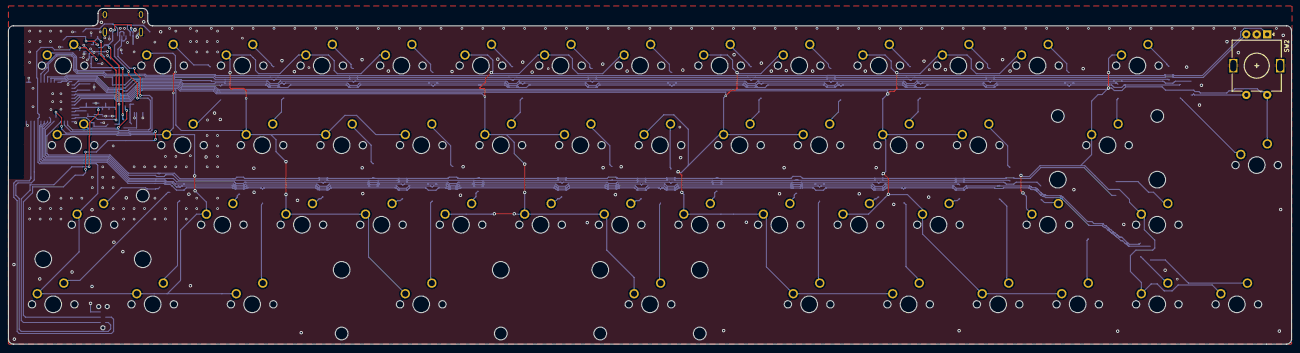
[picture p30: board pcb/ts52k.kicad_pcb from above]

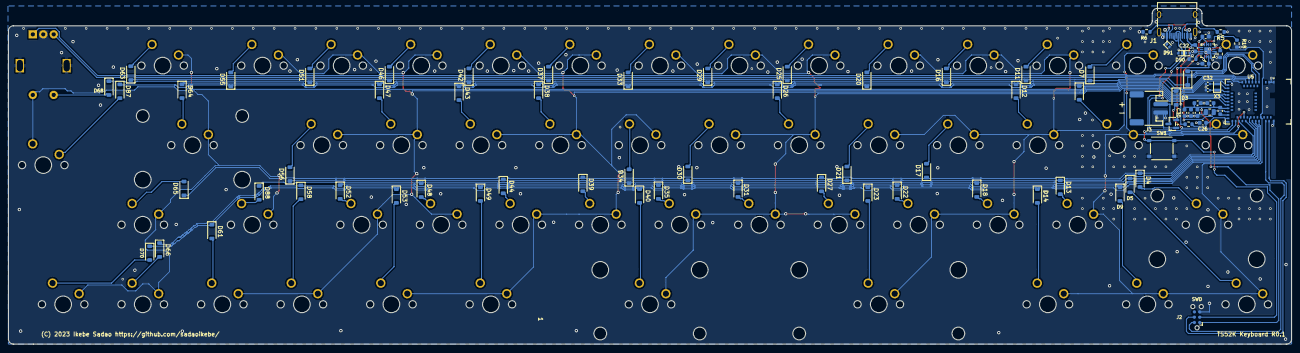
[picture p31: board pcb/ts52k.kicad_pcb from below]

Board: 2 copper layers, 307.2 x 80.4 mm, 136 parts (83 on the bottom side), 91 nets.
