sadaoikebe/ts52k/ts52k.kicad_pcb

## KiCad design ts52k.kicad_pcb (2023-07-01)

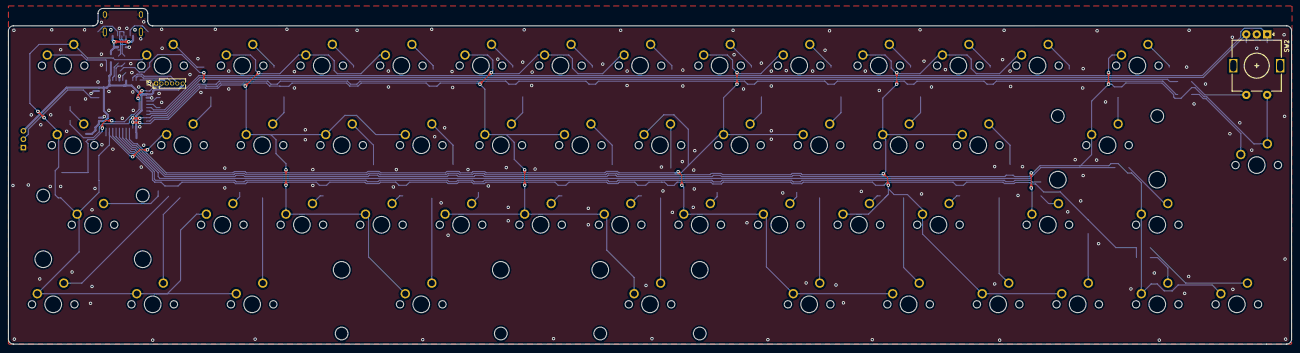
[picture p32: board ts52k.kicad_pcb from above]

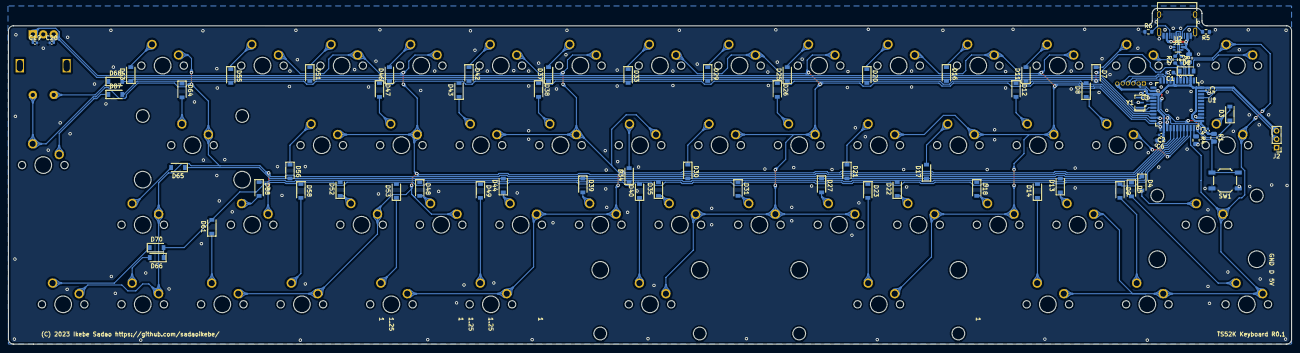
[picture p33: board ts52k.kicad_pcb from below]

Board: 2 copper layers, 307.2 x 80.4 mm, 128 parts (74 on the bottom side), 84 nets.

Parts:
C1: 1u; C_0603_1608Metric
C2, C3, C4, C5, C19, C20: 0.1u; C_0402_1005Metric
C6: 4.7u; C_0603_1608Metric
D2, D3, D4, D5, D7, D8, D9, D11, D12, D13, D14, D16, D17, D18, D20, D21, D22, D23, D25, D26, D27, D29, D30, D31, D33, D34, D35, D37, D38, D39, D40, D42, D43, D44, D46, D47, D48, D49, D51, D52, D53, D55, D56, D58, D61, D63, D64, D65, D66, D68, D70, D87, D88: D; D_SOD-123
F1: Resettable Fuse; Fuse_0805_2012Metric
J1: HRO_TYPE-C-31-M-12; USB_C_Receptacle_HRO_TYPE-C-31-M-12
J2: RGB; PinHeader_1x03_P2.00mm_Vertical
J3: ISP; PinHeader_1x06_P1.27mm_Vertical
MX2, MX64: MX-NoLED; MXOnly-1.5U-NoLED
MX3, MX75: MX-NoLED; MXOnly-1.75U-NoLED
MX4, MX65: MX-NoLED; MXOnly-2.25U-NoLED
MX5, MX9, MX14, MX81, MX82: MX-NoLED; MXOnly-1.25U-NoLED
MX7, MX8, MX11, MX12, MX13, MX16, MX17, MX18, MX20, MX21, MX22, MX25, MX26, MX27, MX29, MX30, MX31, MX33, MX34, MX35, MX37, MX38, MX39, MX42, MX43, MX44, MX46, MX47, MX48, MX51, MX52, MX55, MX56, MX58, MX61, MX66, MX67, MX71, MX74: MX-NoLED; MXOnly-1U-NoLED
MX23: MX-NoLED; MXOnly-3U-ReversedStabilizers-NoLED
MX60: MX-NoLED; MXOnly-2.75U-ReversedStabilizers-NoLED
R1, R4: 10k; R_0805_2012Metric
R2, R3: 22; R_0603_1608Metric
R5, R6: 5.1k; R_0603_1608Metric
SW1: SW_SPST; SW_SPST_TL3342
SW2: RotaryEncoder_Switch; RotaryEncoder_Alps_EC11E-Switch_Vertical_H20mm
U1: ATMEGA32U4; TQFP-44_10x10mm_P0.8mm
U2: TPD4E1U06; SOT-363_SC-70-6
Y1: CSTNE16; Resonator_SMD_muRata_CSTxExxV-3Pin_3.0x1.1mm

Connections:
+5V: C2.1, C3.1, C4.1, C5.1, C6.1, F1.1, J2.3, J3.6, R1.1, U1.2 (UVCC), U1.7 (VBUS), U1.14 (VCC), U1.24 (AVCC), U1.34 (VCC), U1.44 (AVCC)
D+: J1.A6 (D+), J1.B6 (D+), R2.2, U2.1 (IO1)
D-: J1.A7 (D-), J1.B7 (D-), R3.2, U2.4 (IO3)
GND: C1.2, C2.2, C3.2, C4.2, C5.2, C6.2, C19.2, C20.1, J1.A1 (GND), J1.A12 (GND), J1.B1 (GND), J1.B12 (GND), J1.S1 (SHIELD), J2.1, J3.1, R4.2, R5.1, R6.1, SW1.1 (A), SW2.C, U1.5 (UGND), U1.15 (GND), U1.23 (GND), U1.35 (GND), U1.43 (GND), U2.2 (VN), Y1.2
MISO: J3.3, U1.11 (PB3(PD0/PCINT3/MISO))
MOSI: J3.4, U1.10 (PB2(PDI/PCINT2/MOSI))
unnamed: C1.1, U1.6 (UCAP)
unnamed: D2.2 (A), MX2.1 (COL)
unnamed: D3.2 (A), MX3.2 (ROW)
unnamed: D4.2 (A), MX4.2 (ROW)
unnamed: D5.2 (A), MX5.2 (ROW)
unnamed: D7.1 (K), MX7.2 (ROW)
unnamed: D8.1 (K), MX8.2 (ROW)
unnamed: D9.2 (A), MX9.2 (ROW)
unnamed: D11.2 (A), MX11.2 (ROW)
unnamed: D12.2 (A), MX12.2 (ROW)
unnamed: D13.1 (K), MX13.2 (ROW)
unnamed: D14.1 (K), MX14.2 (ROW)
unnamed: D16.1 (K), MX16.2 (ROW)
unnamed: D17.2 (A), MX17.2 (ROW)
unnamed: D18.2 (A), MX18.2 (ROW)
unnamed: D20.1 (K), MX20.2 (ROW)
unnamed: D21.1 (K), MX21.2 (ROW)
unnamed: D22.1 (K), MX22.2 (ROW)
unnamed: D23.2 (A), MX23.2 (ROW)
unnamed: D25.2 (A), MX25.2 (ROW)
unnamed: D26.2 (A), MX26.2 (ROW)
unnamed: D27.2 (A), MX27.2 (ROW)
unnamed: D29.1 (K), MX29.2 (ROW)
unnamed: D30.1 (K), MX30.2 (ROW)
unnamed: D31.2 (A), MX31.2 (ROW)
unnamed: D33.1 (K), MX33.2 (ROW)
unnamed: D34.2 (A), MX34.2 (ROW)
unnamed: D35.1 (K), MX35.2 (ROW)
unnamed: D37.2 (A), MX37.2 (ROW)
unnamed: D38.2 (A), MX38.2 (ROW)
unnamed: D39.2 (A), MX39.2 (ROW)
unnamed: D40.1 (K), MX60.2 (ROW)
unnamed: D42.1 (K), MX42.2 (ROW)
unnamed: D43.1 (K), MX43.2 (ROW)
unnamed: D44.1 (K), MX44.2 (ROW)
unnamed: D46.2 (A), MX46.2 (ROW)
unnamed: D47.2 (A), MX47.2 (ROW)
unnamed: D48.2 (A), MX48.2 (ROW)
unnamed: D49.2 (A), MX81.2 (ROW)
unnamed: D51.1 (K), MX51.2 (ROW)
unnamed: D52.1 (K), MX52.2 (ROW)
unnamed: D53.1 (K), MX82.2 (ROW)
unnamed: D55.1 (K), MX55.2 (ROW)
unnamed: D56.1 (K), MX56.2 (ROW)
unnamed: D58.2 (A), MX58.2 (ROW)
unnamed: D61.1 (K), MX61.2 (ROW)
unnamed: D63.2 (A), MX64.2 (ROW)
unnamed: D64.2 (A), MX65.2 (ROW)
unnamed: D65.2 (A), MX66.2 (ROW)
unnamed: D66.2 (A), MX67.2 (ROW)
unnamed: D68.1 (K), SW2.S1
unnamed: D70.1 (K), MX71.2 (ROW)
unnamed: D87.1 (K), MX74.1 (COL)
unnamed: D88.2 (A), MX75.2 (ROW)
unnamed: J1.A5 (CC1), R5.2
unnamed: J1.B5 (CC2), R6.2
unnamed: R2.1, U1.4 (D+)
unnamed: R3.1, U1.3 (D-)
unnamed: R4.1, U1.33 (PE2(~HWB))
unnamed: U1.16 (XTAL2), Y1.3
unnamed: U1.17 (XTAL1), Y1.1
RESET: J3.2, R1.2, SW1.2 (B), U1.13 (~RESET)
RGB: J2.2, U1.41 (PF0(ADC0))
SCLK: J3.5, U1.9 (PB1(PCINT1/SCLK))
VCC: F1.2, J1.A4 (VBUS), J1.A9 (VBUS), J1.B4 (VBUS), J1.B9 (VBUS), U2.5 (VP)
col1: MX2.2 (ROW), MX3.1 (COL), MX4.1 (COL), MX5.1 (COL), MX7.1 (COL), MX8.1 (COL), MX9.1 (COL), MX13.1 (COL), MX14.1 (COL), U1.32 (PC7(ICP3/CLK0/OC4A))
col2: MX11.1 (COL), MX12.1 (COL), MX16.1 (COL), MX17.1 (COL), MX18.1 (COL), MX20.1 (COL), MX21.1 (COL), MX22.1 (COL), MX23.1 (COL), U1.25 (PD4(ICP1/ADC8))
col3: MX25.1 (COL), MX26.1 (COL), MX27.1 (COL), MX29.1 (COL), MX30.1 (COL), MX31.1 (COL), MX33.1 (COL), MX35.1 (COL), MX60.1 (COL), U1.22 (PD5(XCLK1/~CTS))
col4: MX34.1 (COL), MX37.1 (COL), MX38.1 (COL), MX39.1 (COL), MX42.1 (COL), MX43.1 (COL), MX44.1 (COL), MX81.1 (COL), MX82.1 (COL), U1.26 (PD6(T1/ADC9/~OC4D))
col5: MX46.1 (COL), MX47.1 (COL), MX48.1 (COL), MX51.1 (COL), MX52.1 (COL), MX55.1 (COL), MX56.1 (COL), MX58.1 (COL), MX61.1 (COL), U1.27 (PD7(T0/OC4D/ADC10))
col6: MX64.1 (COL), MX65.1 (COL), MX66.1 (COL), MX67.1 (COL), MX71.1 (COL), MX74.2 (ROW), MX75.1 (COL), SW2.S2, U1.28 (PB4(PCINT4/ADC11))
row1: D2.1 (K), D7.2 (A), D11.1 (K), D16.2 (A), D25.1 (K), D29.2 (A), D37.1 (K), D42.2 (A), D46.1 (K), D51.2 (A), D63.1 (K), D68.2 (A), U1.20 (PD2(RXD1/INT2))
row2: D3.1 (K), D8.2 (A), D12.1 (K), D20.2 (A), D26.1 (K), D33.2 (A), D38.1 (K), D43.2 (A), D47.1 (K), D55.2 (A), D64.1 (K), D87.2 (A), U1.21 (PD3(TXD1/INT3))
row3: D4.1 (K), D13.2 (A), D17.1 (K), D21.2 (A), D27.1 (K), D30.2 (A), D39.1 (K), D44.2 (A), D56.2 (A), D65.1 (K), U1.29 (PB5(PCINT5/OC1A/ADC12/~OC4B))
row4: D5.1 (K), D18.1 (K), D22.2 (A), D31.1 (K), D34.1 (K), D35.2 (A), D48.1 (K), D52.2 (A), D88.1 (K), U1.30 (PB6(PCINT6/OC1B/OC4B/ADC13))
row5: D9.1 (K), D14.2 (A), D23.1 (K), D40.2 (A), D49.1 (K), D53.2 (A), D58.1 (K), D61.2 (A), D66.1 (K), D70.2 (A), U1.31 (PC6(OC3A/~OC4A))
rpg1: C19.1, SW2.A, U1.18 (PD0(OC0B/SCL/INT0))
rpg2: C20.2, SW2.B, U1.19 (PD1(SDA/INT1))
