sadaoikebe/ts52k/(commit log)

2023-07-03 change to QFN
    [ts52k.kicad_sch]
2023-07-04 jlcpcb ordered
    [ts52k.kicad_sch]
2023-07-05 add case
    [ts52k.kicad_sch]
2023-07-05 add plate
    [ts52k-plate.FCStd]
2023-07-07 widen the stabilizer holes as they are too tight
    [ts52k-plate.FCStd]
2023-07-07 adjust tabs then add dxf
    [ts52k-plate-Body.dxf, ts52k-plate.FCStd]
2023-07-13 add brim
    [ts52k-case-Base.3mf]
2023-07-13 chamfer lid for flipped printing
    [ts52k-case-Lid.3mf, ts52k-case.FCStd]
2023-07-18 tighter fit
    [ts52k-case-Base.3mf, ts52k-case-Lid.3mf, ts52k-case.FCStd]
2023-07-18 base fill
    [ts52k-case-Base.3mf, ts52k-case.FCStd]
2023-10-20 case v1 release
    [ts52k-case-Base.3mf, ts52k-case-Lid.3mf, ts52k-case.FCStd]
2023-10-20 slimmer case
    [ts52k-case-Base.3mf, ts52k-case.FCStd, ts52k-knob-Body.step, ts52k-knob.FCStd, ts52k-plate-Body.dxf, ts52k-plate.FCStd]
2024-12-08 add bom
2025-01-21 update lid 3mf
    [ts52k-case-Lid.3mf]
2026-02-23 plate - lthumb with 2u stabilizer
2026-05-09 Update case geometry 2026
2026-05-09 add flash circuitry
2026-05-09 gpio wiring
2026-08-07 annotate rp2040 circuitry
    Assign reference designators to the 31 previously unannotated symbols
    added during the RP2040 conversion (C2-C21, R2-R13, U4, U5, X2).
    Without annotation KiCad could not resolve connectivity through symbols
    sharing a designator, which made ERC report 9 phantom dangling wires on
    the QSPI and USB series resistors and omit RP2040 pins 46/47 and 51-55
    from the netlist. Those nets verify as correctly connected once annotated.
    Also ignore KiCad 10's .history local-snapshot directory.
2026-08-07 assign footprints and vendor the MX_Only library
    Fill in the 24 footprints left empty by the RP2040 conversion (C6-C18,
    C21, R2-R4, R7-R13), matching the 0402 passives already used around the
    MCU, and give U5 its missing library prefix (rp2040:IC57_RP2040).
    MX_Only was referenced by all 52 keyswitches but had never been part of
    the repo, so the project could not be built from a fresh clone. The
    board file still carried a full copy of each placed footprint, so the
    library is reconstructed from there and registered in fp-lib-table.
    Clears all 53 footprint_link_issues ERC violations.
2026-08-07 vendor keyswitch and USB-C symbols into a project library
    Both symbols had become unresolvable: the keyswitch lived in a
    'ts52k-rescue' library that .gitignore excluded and that was never
    committed, and Connector:USB_C_Receptacle_USB2.0 was renamed to
    USB_C_Receptacle upstream. The schematic still carried working cached
    copies, so ts52k.kicad_sym is built from those and the 55 lib_ids are
    re-pointed at it.
    Re-pointing rather than adopting the renamed stock symbol avoids any
    risk of a differing pin layout disturbing existing connectivity.
    Clears all 53 lib_symbol_issues ERC violations.
2026-08-07 repair the RP2040 symbol's units and pin types
    The symbol declared two units that redefined the same pin numbers: unit A
    held all 57 pins with the supply pins left 'unspecified', and unit B
    re-declared 11 of them as power_in. A pin number belongs to exactly one
    unit, and unit B was never placed, so ERC reported an unplaced unit and
    missing input power pins.
    Drop unit B and type unit A's pins for how the part is actually wired:
    IOVDD/DVDD/ADC_AVDD/USB_VDD/EPAD as power_in, VREG_VOUT as power_out
    since it feeds DVDD, RUN/TESTEN/SWCLK/XIN as input, SWDIO and the USB
    pair as bidirectional, QSPI_SCLK/SS_N as output.
    Applied to both the library and the schematic's cached copy so the two
    stay in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
2026-08-07 fix the J2 no-connect and reconnect the GND power flag
    J2 pin 6 is typed NC in the symbol but carried a wire out to a No-Connect
    flag 5.08mm away, which ERC read three ways at once: an NC pin that is
    connected, a flag that sits on a wire end instead of a pin, and a wire
    reaching nothing. The pin's NC type already states the intent, so both
    the wire and the flag are removed.
    The PWR_FLAG at (31.75, 189.23) was wired towards #PWR0123 but stopped
    1.27mm short of the GND pin, leaving the GND net undriven. A short
    vertical segment closes the gap.
    Clears wire_dangling, no_connect_connected, no_connect_dangling,
    unconnected_wire_endpoint and power_pin_not_driven.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
2026-08-07 snap the rotary encoder block onto the schematic grid
    That corner was drawn on a 0.635mm half-grid, leaving 18 endpoints off the
    1.27mm grid. Every off-grid X there sat 0.635 above a grid line and every
    off-grid Y likewise, so X-0.635 / Y+0.635 lands the block on grid without
    disturbing coordinates that were already aligned.
    Pulling C20's pin onto the junction it was joined to collapsed one 0.635mm
    stub to zero length, which is removed.
    Netlist comparison against the pre-cleanup tree confirms every net still
    carries exactly the same set of pins.
2026-08-07 point misused power symbols at their actual rail
    Four +3V3 rails were drawn with the power:+5V symbol and one +5V rail
    with power:VCC, relying on the Value field to name the net. That works,
    but any operation resetting field text from the library would rename
    those nets and short +3V3 to +5V - which is exactly what the field
    options in Update Symbols from Library would have done.
    Re-point each lib_id at the symbol whose name already matches its Value,
    and cache power:+3V3 from the stock library. All three symbols carry one
    power_in pin at (0,0) angle 90 length 0, so no connection can move.
    Netlist comparison confirms all 117 nets keep the same pins; +3V3 still
    has 27 nodes and +5V still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
2026-08-07 refresh cached symbol definitions from their libraries
    Does what Update Symbols from Library does to the symbol body, without the
    field handling that dialog also performs - nothing outside lib_symbols is
    touched, so every instance keeps its reference, value, position and field
    layout as drawn.
    A cached symbol is only replaced when the library copy has an identical pin
    geometry (number, position, angle, length), since a wire attaches by
    coordinate. That guard matters: upstream has moved every pin on
    Memory_Flash:W25Q128JVS and Regulator_Linear:AP2112K-3.3 since this project
    was drawn, and adopting those copies pulls U3 and U4 clean off GND, +3V3,
    +5V and the whole QSPI bus. Both are left o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
2026-08-07 rewrite README
    Document the circuit itself, which the repo never explained: what each
    non-passive part is for and why it was chosen - the USB-C CC resistors
    that gate power entirely, the low-capacitance ESD array USB needs, the
    RP2040 feeding its own core from its internal regulator, the oscillator
    module standing in for a crystal, and the external flash the MCU cannot
    boot without.
    State the branch situation up front so nobody mistakes this for an
    orderable design: main is the finished ATmega32U4 board, rp2040 has a
    complete schematic but its PCB layout is untouched.
    Record two things that are easy to trip over: there is no BOOTSEL button,
    so firmware goes in over SWD, and Update Symbols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
2026-08-07 drop the KiCad 5 symbol cache
    ts52k-cache.lib is the legacy .lib-format cache KiCad 5 kept beside the
    project. KiCad 6 onwards embeds symbol definitions in the schematic
    itself, and nothing in the project references this file - not the
    schematics, not sym-lib-table, not the project file.
2026-08-07 correct the firmware and diode notes in the README
    The QMK repo has no RP2040 port yet and won't until there is hardware to
    test it on, which is a schedule rather than an oversight - say so.
    The diode part number is genuinely undecided, so state the selection rule
    that will settle it (cheapest LCSC basic part, to keep JLCPCB assembly
    free of extended-part fees) instead of implying 1N4148W is chosen.
2026-08-07 add a BOOTSEL button
    RP2040 enters its USB mass-storage bootloader when QSPI_SS is held low at
    power-up. With no button the only way to load firmware was SWD over the
    Tag-Connect pads, which means fetching a cable for every update.
    SW1 pulls QSPI_SS_N to ground through 1k, as the Pico reference design
    does: the resistor limits current when the button is pressed while the MCU
    drives CS high, and against the existing 10k pull-up it divides to ~0.3V,
    a solid logic low.
    The net only reaches the root sheet as a hierarchical sheet pin and the
    area below it is covered by the sheet symbol, so the button sits in free
    space and joins the net through a global label - the same way this sheet
    already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
2026-08-07 document the BOOTSEL button in the README
    Replaces the section warning that no BOOTSEL button exists with one
    describing SW1: why the 1k is there, and the two firmware paths now
    available (UF2 over USB, or SWD over Tag-Connect).
    Flags that the button's position is a case-design decision - whether to
    put a hole in the shell or require opening the base to reach it - since
    that has to be settled during PCB layout.
2026-08-07 remove the old plugin's teardrop zones
    The 278 teardrops were generated by the pre-KiCad-7 teardrop plugin, which
    stamps every zone it makes with priority 16962 (0x4242) - that marker
    separates them cleanly from real copper, and the board's single GND plane
    carries no priority and stays.
    They have to go before the RP2040 layout work. They are fixed polygons
    glued to the current pad and track geometry, so the moment U1 comes off the
    board and the nets are rerouted they turn into orphaned copper that KiCad 7+
    has no way to recognise or update. Teardrops get regenerated at the end
    with the native feature, which stores them as track attributes that follow
    the geometry instead.
    Footprints, tr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
2026-08-07 upgrade PCB to KiCad 10 file format
    Opened and saved in KiCad 10, taking the board file from 20211014 to
    20260206. No edits were made; the diff is entirely the format rewrite,
    which is why it is large. Committed on its own so the RP2040 layout work
    that follows produces a readable diff.
    Verified equivalent: 132 footprints, 1054 track segments, 290 vias, 1 zone,
    534 pads, and the same 99 net names before and after. All 337 pad-to-net
    assignments are unchanged. DRC reports the identical 119 violations and 0
    unconnected items.
    Net references changed shape in this format - KiCad 10 drops the numeric
    index and writes (net "name") - so any tooling that parsed the old
    (net N "name") form need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
2026-08-07 add the RP2040's missing VREG_VIN pin
    The custom symbol was drawn with 56 pins. RP2040 is a QFN-56 plus thermal
    pad, and pin 44 - VREG_VIN, the supply input to the on-die 1.1V core
    regulator - was never drawn at all.
    ERC could not catch this: a pin that does not exist in the symbol cannot be
    reported unconnected. It surfaced only when Update PCB from Schematic
    matched the footprint's 57 pads against the symbol and found nothing for
    pad 44.
    Left as it was, the internal regulator would have had no input, so DVDD
    would never come up and the chip would not run - on a board that otherwise
    looks complete.
    The pin goes beside ADC_AVDD on the supply row, at x=44.45, still inside the
    body outlin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
2026-08-07 document VREG_VIN and the PCB update pitfall
    The RP2040 power description was written from a symbol that was missing
    VREG_VIN, so it showed the core regulator's output feeding DVDD without
    saying where the regulator's own input comes from. Add the pin and a
    diagram of the full 3.3V -> 1.1V -> DVDD path.
    Also record that Update PCB from Schematic must keep 'Link footprints using
    reference designators' off: the ATmega32U4 and RP2040 designs reuse SW1 and
    J2 for different parts, so reference-based linking would pair a reset switch
    with a BOOTSEL button and a pin header with a Tag-Connect pad.
2026-08-07 ground the rotary encoder's mounting pins
    The EC11E footprint has two MP pads - the metal frame's solder tabs - but
    Device:RotaryEncoder_Switch has no pin for them, so Update PCB from
    Schematic reported 'no pin MP in symbol' and the tabs sat on no net. Those
    tabs are what anchors the encoder against the sideways force of a knob, and
    grounding them also gives static a path that would otherwise reach the shaft
    contacts.
    KiCad ships Device:RotaryEncoder_Switch_MP for this. A, B, C, S1 and S2 sit
    at identical positions in both symbols, so re-pointing the lib_id cannot move
    an existing connection - it only exposes the extra pin, which now runs to a
    GND symbol.
    Netlist comparison confirms the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
2026-08-07 update PCB from schematic for the RP2040 design
    Brings the board's component set in line with the RP2040 schematic. New
    parts are parked outside the board outline; nothing is placed or routed yet.
    KiCad matched more parts than expected. UUID linking claimed the 112 parts
    carried over from the original design, and then reference-designator
    fallback reused nine more rather than deleting and re-adding them - old J2
    (3-pin header) became the Tag-Connect, old SW1 (reset switch) became the
    BOOTSEL button, and R2-R4, R7, R8, C4, C6 were re-footprinted from 0603/0805
    to 0402. That is harmless here: schematic parity reports 0 issues, so every
    pad carries the net the schematic says it should.
    1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
2026-08-07 delete the ATmega-era orphaned copper
    Update PCB from Schematic had already done the sorting: copper whose net
    vanished with the old design was blanked to (net ""), while everything still
    in the netlist kept its name. This removes the 130 netless tracks and 7
    netless vias, which sit exactly where the deleted parts were - 36 around U1,
    21 by the old reset switch and fuse, 15 at the resonator and ISP header, and
    the WS2812B data run crossing the board.
    Not done with the GUI's Cleanup Tracks & Vias. Its 'delete dangling tracks'
    cascades: each matrix run would be peeled back segment by segment from the
    end that used to land on a U1 pad, all the way to the nearest pad, throwing
    away routing th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
2026-08-07 drop the cached zone fill
    The GND pour's fill was 2.2MB of computed polygons - 69% of the board file -
    all of it regenerated from a 126-byte, four-point outline whenever KiCad
    needs it. Carrying that through the layout phase means every save rewrites
    82,949 points and buries the actual change in the diff, and the fill goes
    stale the moment a footprint moves anyway.
    Only the filled_polygon blocks are removed. The zone keeps its net, both
    copper layers, hatch style, pad clearance, min thickness, thermal settings
    and outline, verified identical before and after, so Edit > Fill All Zones
    restores it.
    DRC run with --refill-zones gives byte-identical results either way: the
    same 113 violations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
2026-08-08 reassign the matrix to GPIO0-15
    Walking the old ATmega's abandoned fan-out clockwise from its south-west
    corner gives col1, row5, row4, row3, col6, col5, col4, col2, col3, row2,
    row1, rpg2, rpg1. Walking the RP2040's pads the same way now gives the
    same sequence, so every one of these signals meets its stub head-on and
    nothing has to cross anything else to get there.
    row4 and row5 have no pin yet - their labels are sitting loose in the
    rp2040 sheet - so ERC reports two dangling globals until GPIO16/GPIO17
    are wired up.
2026-08-08 put row4 and row5 on GPIO15/GPIO16, moving col1 to GPIO17
    The south edge has four matrix-capable pads east of the SWD/XIN/RUN block
    and two west of it. Six of the eight stubs arriving from the south still
    need a pin, so both halves get used, and it is the two westmost stubs -
    col1 and row5 - that belong on the far side. col1 therefore gives up
    GPIO15 to row4 and takes GPIO17, which leaves the whole south edge in the
    order the stubs already lie in:
    west -> east col1 row5 | SWD block | row4 row3 col6 col5
    pad 28 27 18 17 16 15
    The two loose global labels become hierarchical labels wired to pads
    27/28, with matching sheet pins on the root sheet, so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
2026-08-08 carry the row4/row5 assignment into the board
    Only U5's pads 18, 27 and 28 change name; the 924 tracks, 283 vias and
    147 footprints are untouched and schematic parity is back to zero.
2026-08-08 remove a netlist that got committed by accident
    A `kicad-cli sch export netlist -o -` wrote 208 kB to a file literally
    named `-` in the repo root, and it was swept up by `git add -A`.
2026-08-08 add a board layout guide
    Everything worked out while deciding where the RP2040 goes: which board
    edge each die edge ends up facing once the part is flipped, how much
    room the old ATmega left behind, and how close each part actually has to
    sit. Splitting it out of the README keeps that reference next to the
    board it describes.
2026-08-08 mark the 17 spare GPIO as no-connect
    GPIO5-9 and GPIO18-29 are settled as unused now that the matrix has its
    pins, so say so on the chip. A no-connect flag cannot share a pin with
    a wire, so the run out to a hierarchical label and up to a sheet pin
    that landed on nothing had to come out first - which also takes the
    sheet symbol down to the 13 signals that actually leave the block, and
    lets the box shrink back to 62.23 mm.
    Every net keeps exactly the same members; the only difference in the
    netlist is that 17 auto-generated names go from /rp2040/GPIOn to
    unconnected-(U5-GPIOn-PadN). ERC 34 -> 0.
    The board needs Update PCB from Schematic to pick up those 17 names.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
2026-08-08 carry the no-connect names into the board
    17 pad names on U5, nothing else: the 924 tracks, 283 vias and 147
    footprints are untouched and schematic parity is back to zero.
2026-08-12 bring the docs up to date with the state of the board
    The layout guide was written before the GPIO work finished, so it still
    described ERC warnings that are gone and a parked-part count from an
    earlier round. Added what came out of actually measuring the board:
    - the DRC baseline, broken down so it is clear which 26 dangling tracks
    are deliberate and which items are inherited from the ATmega version
    - routing rules, because the current 0.25 mm track and 0.2 mm clearance
    add up to 0.45 mm and the RP2040's pads are on a 0.4 mm pitch - the
    fan-out cannot leave the chip until a narrower width is defined
    - a routing order to go with the placement order
    - an open-items list, and how to re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
2026-08-12 coarse-place the RP2040 island on the board
    Move the 35 off-board MCU-side parts onto B.Cu near the old
    ATmega site per PLACEMENT.md, keeping U5 at rot 180 and leaving
    matrix tracks untouched. Include the coordinate script for re-runs.
2026-08-12 add RP2040 fanout track and via sizes
    Lower board minima to 0.15mm tracks and 0.45mm vias, register
    0.15/0.20/0.25 widths and 0.5/0.3 vias for MCU work, and put
    +3V3 and 1V1 on the Power netclass.
2026-08-12 keep a tool to clear copper under placed footprints
    Add clear_copper_under_parts.py (clip B.Cu under selected parts,
    leave matrix stubs) and document it in PLACEMENT.md. Run only after
    placement settles; the earlier copper-clear board edit is discarded.
2026-10-26 prepare the RP2040 island so it can be routed
    Footprints, pinouts, and LCSC numbers are checked. The LDO is an XC6206, the series resistors are 22 ohm, and the Tag-Connect header matches a CTX cable. Matrix stubs and the unfilled ground zone stay for the routing pass.
2026-10-29 Shorten decoupling connections and improve QSPI ground reference
2026-10-29 Move 1V1 decoupling capacitors closer to RP2040 power pins
2026-10-30 Split duplex matrix into ten rows and shorten X2 decoupling
    Route paired row trunks with uniform diode polarity and preserve their order.
    Leave only 19 MCU-area connections pending; DRC errors and schematic parity
    issues are zero.
    Set manual matrix routing to 0.15 mm width and 0.20 mm clearance. Move C14
    beside X2 and relocate R3, shortening the supply path from 27.69 to 1.60 mm.
2026-10-30 Fix power connectivity and clean up Tag-Connect routing
2026-10-30 Add 10k pull-ups to rotary encoder inputs
2026-10-30 Improve USB power and ESD protection
2026-10-30 Update USB routing and standard footprints
2026-10-31 Update board routing and USB shield ground
2026-11-01 Document revision 0.2 as current release
2026-11-03 Register wireless TS52K parts and consolidate hardware decisions
2026-11-03 Draw wireless TS52K schematic preserving existing layout
2026-11-03 Rough-place the wireless TS52K board
    Remove the RP2040 section, its local copper, and the 0.15 mm clearance exception. Place MDBT50Q, BQ24072, the 32.768 kHz crystal, and the battery connector on the back without new tracks. Record the decision to gather row and encoder inputs on south pads 3-14; those nets still use the previous assignment.
2026-11-04 Route preliminary wireless PCB power and control circuits
2026-11-05 Refine wireless power layout and symmetric crystal routing
2026-11-07 Rework matrix buses and wireless GPIO routing
2026-11-09 Document KiCad MCP development environment
2026-11-09 Preserve local KiCad MCP compatibility patch
2026-11-10 案C POC: col2・col3を北辺へ移設しGNDフェンスを追加
2026-11-10 案C POC: 旧バス端のスタブ2本を除去 (dangling 19→17、未接続13は不変)
2026-11-10 南側出口の入力5本を上段バスへ接続し、列ホップ部を再構成
    - rpg1/rpg2をアンテナkeepout下の2レーン、row1をMX8.1と左穴の間、row6/row2をMX8左穴の外周、row7をF.Cu約13.5 mmで通し、keepout東側の通路から既存バス端へ接続
    - col4/5/6のF.Cuホップを入力6本をまたぐ位置へ並べ直し、D8アノードを南へ逃がした
    - col1はMX8.1西側の引き出しとビア2個を廃し、x=41の直線で既存の下段ホップへ接続
    - D2を行の壁の西側へ仮移設（MX2側の配線は次段）。U5.2 GNDはベタ直結に変更
    - DRC実測: 未接続13→9、違反93→84（dangling17→6＋via dangling2）、パリテ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
2026-11-10 D7アノードを接続し、列・エンコーダの残置スタブを除去
    - MX7.2→D7.2をB.Cuの45°＋水平で接続
    - col5/col6の微小スタブと重複線、SW2 A/B南向きの残置スタブを除去
    - DRC実測: 未接続9→8、違反84→80（dangling 2＋via dangling 2）、パリティ0
2026-11-10 MX2のcol1・D2アノード・row1を接続
    - col1: MX2.2からR18端子間→西端→J3の端子間通路(x=4.0)→MX3.1へB.Cuで接続
    - D2アノード: MX2.1から同じ通路(x=4.6)→MX3.2の北→D2.2
    - row1: U5.4直下のビアからF.Cu約6.9 mmで行の壁を越えD2.1へ
    - DRC実測: 未接続8→5（残りはJ2/SWD系のみ）、違反80、パリティ0
2026-11-10 SWD・nRESET・VTrefをJ2とSW1へ接続（未接続0）
    - SWDIO/SWCLK/nRESET/nRF_VDDをモジュール下からF.Cuで南西へ引き出し、行の壁とD2/D3アノードを越えてJ2西側へ
    - nRESET・VTrefはJ2の南を回って東列へ。D4アノードを0.07 mm南へ寄せて2レーン確保
    - nRESET→SW1は行の壁とcol1をF.Cuで2回越える
    - GNDビア2個を移設、J2.5はベタ直結
    - DRC実測: 未接続5→0、違反80→76（シルク・文字のみ）、パリティ0
2026-11-10 配線記録・DRC・確認記録を現在の基板に合わせて更新
2026-11-10 SWD・nRESETをモジュール南西角からB.Cuで引き出し、F.Cuの長い斜め配線を廃止
    SWDIO・SWCLK・nRESETはモジュール内側をB.Cuで通し、パッド15/16と14の間から
    行のUターン4本と並べて出す。VTrefのF.Cuは角の外で終える。D3アノードは
    SWD束を短いF.Cuで越える。F.Cu配線長 230.18→174.88 mm、信号ビア 67→63。
    DRC: 未接続0、違反76（シルク・文字とライブラリ差異のみ、件数不変）。
2026-11-10 ビア1個だけで表面につながるB.Cu GND島9か所へ2個目のGNDビアを追加
    対象は面積5 mm2以上の島（アンテナ東・南、モジュール下を含む）。GNDビア 173→182。
    DRC: 未接続0、違反76（件数不変）。
2026-11-10 外径0.5 mmのGNDビア5個を0.6 mmへ統一（環幅0.10→0.15 mm）
2026-11-10 B面の参照名シルクを整理（DRC警告 76→10）
    0.65 mm高だった25個と、パッド・他シルクに重なっていた参照名を0.8 mm高・0.12 mm太さで
    重ならない位置へ移した。置き場のない13個（C23 C24 C27 C28 C29 C31 C33 D89 L1 R17 R19 R20 U6）は
    非表示にした。銅箔・部品位置は不変。残る10件はD89/D90の外形線同士7、J1の基板端2、
    SW2のライブラリ参照1。
2026-11-10 Powerネットクラスの対象を無線版の電源ネット名へ更新
    旧RP2040版の +5V・VCC・+3V3・1V1 を外し、USB_VBUS・MCU_VBUS・BAT・VDDH・nRF_VDD・DCCH を
    割り当てた。Powerクラスのクリアランスは既定と同じ0.2 mmで、DRCの判定条件は変わらない。
2026-11-10 重なっていた同一直線上の線分13組を統合し、BATの行き止まりスタブ1.8 mmを除去
    重複線分に隠れてDRCに出ていなかったスタブ（今回の作業以前からのもの）。銅箔の接続は不変。
2026-11-10 アンテナ先端側・側方のGNDベタを抜くルールエリア ANT_NO_FILL を追加
    範囲 x=33.45〜40.0、y=54.0〜71.0、F.Cu/B.Cu。ベタのみ禁止で配線・ビア・パッドは許可。
    範囲内で孤立するGNDビア2個を除去。メーカー指針（禁止領域を可能な範囲で広げる）への対応。
    DRC: 未接続0、違反9（シルクのみ）。USB・水晶・DCCH直下のF.Cu GND欠損0。
2026-11-10 見直しの配線記録・DRC・確認記録・スクリプトを追加し、工程の記述を現状に合わせて更新
2026-11-10 U5を基板左端へ移設する準備：GPIO割当てを組み直し、旧位置依存の配線を撤去（作業途中・未接続あり）
    回路図はマトリクス18本のU5ピンを付け替え（ERC 0）。PCBはU5を(4.45, 63.4)・270°へ移し、
    ANT_NO_FILLと旧モジュール位置に依存する配線・ビアを除去。この時点では未接続が多数ある。
2026-11-10 U5を基板左端へ移設し、マトリクス・USB・電源・SWDを引き直し（未接続0、シルク整理前）
    モジュールを(4.45, 63.4)・270°に置き、アンテナを基板左端の外向きにした。水晶・電源コンデンサ群・
    J3・D2・D3・J2・SW1・R20を再配置。マトリクス18本はパッド並び順に合わせた割当てでB.Cuのみで
    バスへ接続。USB D±・USB_VBUS・VDDH・BAT・nRESET・VTref・col1(MX7.1)はF.Cuで束をまたぐ。
    基板端から3.8 mmのルールエリア ANT_EDGE を追加。
2026-11-10 GNDスティッチ・モジュール四隅のGNDビアを追加し、移設部品の参照名シルクを置き直し
    DRC違反は起点と同じ9件（D89/D90の外形線7、J1のシルク2）。未接続0、回路図との不一致0。
    USB_VBUSのF.Cu区間を短縮し、BATのビアをJ3パッドの外へ出した。
2026-11-10 モジュール左端移設の記録・検査結果・GPIO割当て表を更新
    配線記録、確認記録、DRC、画像、スクリプトの説明を追加。GPIO割当て表・決定事項・README・
    AGENTS.md を新しい割当てと配置に合わせた。回路図の検査スクリプトのGPIO表を改めて再実行し、
    PDF・画像・ネットリストを出力し直した（PASS、ERC 0）。
2026-11-10 西端移設後のGPIO説明を統一しZMK同期チェックリストを追加
2026-11-10 アンテナ帯のパッドを禁止しGPIO・銅箔検査と最終DRC/ERCを記録
2026-11-10 西端移設後のPCB工程と旧製造データの記録を補足
2026-11-10 jlcpcb export: 製造ソース一覧を無線版に更新 (mdbt50q.kicad_sch、旧RP2040ファイルを除去)
2026-11-10 無線版の製造データを再生成 (ガーバー/BOM 20行/CPL 81点・全てBottom、LCSC欠けなし)
2026-11-10 PLACEMENT.md冒頭の状態記述を更新 (取り込み完了・無線版製造データ再生成済み)
2026-11-10 jlcpcb README冒頭とAGENTS.mdの状態記述を実態に更新 (無線版製造データ再生成済み・取り込み済み)
2026-11-10 J2(SWD接点)を行間へ横向きに移設し、J3に極性シルクを追加
    J2の位置決め穴の1つ(11.0,79.46)が表面のMX3本体外形(下端y=80.8)の内側に
    あり、スイッチ実装後にTag-Connectの位置決めピンが突き当たる配置だった。
    J2を(12.0,83.3)・0°へ移し、3穴ともMX3とMX4の本体の間(y=80.8〜85.8)に
    収めた。SWDIO/SWCLK/nRESET/VTref/GNDを引き直し、穴と重なるGNDビア1個を
    削除。J3の差し込み口正面に + / - のシルクを追加。
    DRC: 未接続0・パリティ0・違反9(従来と同じシルク9件)。ERC 0。
2026-11-10 J2移設後の基板から製造データを再生成 (ガーバー更新、BOM/CPLは不変)
2026-11-10 文鎮化回避の運用ルール・初回書き込み/復旧手順を追加し、既存手順の危険な記述を修正
    - notes/brick-avoidance.md を新設 (守るルール、初回書き込み手順、復旧の順序、PC側チェックリスト)
    - リセット後にSWDでUICRを読戻す手順を、リセット前の読戻し+USB/電圧での確認に変更
    (保護強化版ではブートローダ単体の間SWDが閉じ、再消去の誤操作を招くため)
    - 配布HEXの逆アセンブル照合結果を記録
    - J2移設の記録、発注時に向きを確かめる部品の一覧を追加
2026-11-10 最終DRC/ERC記録とHEX検査スクリプトを追加、手順書の電圧目安の出所を明記
2026-11-10 回路図: 電池逆接続保護のQ1 (AO3401A) をJ3とBQ24072 BATの間に追加
    J3 1番 -> Q1 ドレイン (BAT_CONN)、Q1 ソース -> BAT、ゲート -> GND。
    ts52k ライブラリに AO3401A シンボルと SOT-23 ランドを登録。
    J3 は空きのある右下へ移して Q1 と並べた。ERC 0。
2026-11-10 基板: Q1 (AO3401A, SOT-23) をJ3の南西に配置し、BATを直列に引き直し
    - Q1 (24.97, 68.73) 裏面。S=BAT、D=/BAT_CONN (J3 1番)、G=GND (J3 2番へ専用配線)
    - BATは表面をD3の南まで延ばし、ビア(23.8, 66.5)でQ1ソースへ
    - Net-(D3-A)はQ1を表面でまたぐ (ビア2個)
    - D-/D+/nRESET/col1 は Q1 の下の約2〜3 mm だけ 0.15 mm 南へ寄せた
    - DRC: 未接続0、パリティ0、違反9 (起点と同じシルク警告)。ERC 0
2026-11-10 検査スクリプトと回路図の検査記録をQ1追加後の構成に更新 (20品種82点)
    check_schematic.py: BAT = U6.2/U6.3/C24.1/Q1.2、/BAT_CONN = J3.1/Q1.3、Q1.1 = GND を厳密照合。
    check_libraries.py: 21シンボル・15ランド。両方 PASS (KiCad 10.0.8)。回路図PDF・全体図を再出力。
2026-11-10 Q1追加後の基板から製造データを再生成 (BOM 21行、CPL 82点)
2026-11-11 Q1追加の記録: 配置・挙動・選定根拠・手順書・製造READMEを更新、最終DRC/ERCと見積もりを保存
    - pcb/placement-review/README.md 冒頭にQ1の節 (配置理由、実測の余裕、状態別の挙動、逆挿し過渡の見積もり)
    - notes/brick-avoidance.md: 電池の抜き差しはUSBを抜いてから、Q1の確認手順
    - pcb/jlcpcb/README.md: Q1の実装向きをプレビューで確認 (EasyEDAのランドはKiCadと180°違い)
    - 最終検査: 未接続0、パリティ0、違反9 (起点と同じシルク)、ERC 0
2026-11-11 KiCadのロックファイル (~ts52k.kicad_pro.lck) を除去
2026-11-11 Q1 (C15127) のCPL回転に+180°補正を適用
    EasyEDAのC15127ランド定義はKiCadのSOT-23と180°違い、ピン番号
    (1=G, 2=S, 3=D) は一致することを実データで確認済み。export.pyに
    ROTATION_CORRECTIONS (LCSC番号キー) を追加し、再生成でも補正が
    維持されるようにした。あわせて製造READMEの旧方針記述と
    AGENTS.mdのQ1マージ状態を現状に更新。
2026-11-11 全20種類のJLCPCBランド取得と82点の回転監査根拠を保存
2026-11-11 回転監査結果を発注手順へ反映し製造出力とmanifestを再生成
2026-11-11 全BOM行の監査報告と82点の角度・最終DRC/ERC検証を記録
2026-11-13 J2（SWD接点）を基板西端の帯へ移設しSWD配線を引き直す
    J2を裏面(12.0, 83.3)・0°から(-0.6, 86.5)・-90°へ移した。J2コートヤードから
    最寄りのスイッチ本体（15.6 mm換算、MX3）まで2.98 mm。VTref・nRESET・SWDIO・
    SWCLK・GNDをB.Cuで引き直し、経路上のGNDステッチングビア2個を削除した。
    DRCはエラー0・未接続0・回路図との不一致0（シルク警告9は従来どおり）、ERCは0。
    ガーバーとmanifestを再生成した（BOM・CPLは変化なし）。
2026-11-13 J2（SWD接点）を最下段のMX5とMX9の間へ再移設しSWD配線を引き直す
    J2を裏面(-0.6, 86.5)・-90°から(19.05, 115.0)・+90°へ移した。表面側の障害物
    （スイッチ本体15.6 mm、全スタビライザー本体とワイヤー、エンコーダ）を対象に
    基板全体を探索し、SWD端子に最も近い候補を選んだ。スタビライザー本体の寸法は
    CHERRY Keymodule MX資料（p.63）による。J2コートヤードから最寄りの障害物は
    MX5・MX9のスイッチ本体で各2.061 mm、スタビライザー本体まで8.70 mm。
    VTref・nRESET・SWDIO・SWCLK・GNDをB.Cuで引き直した。他の部品・配線は不変。
    DRCは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
