sadaoikebe/ts52k/(notices)

Notices in the files:
ts52k.kicad_pcb:
(C) 2023 Ikebe Sadao https://github.com/sadaoikebe
